Yuwen2024/Fall-2025-Ember-Bot/Documentation/ECEN403 Final Presentation.pdf

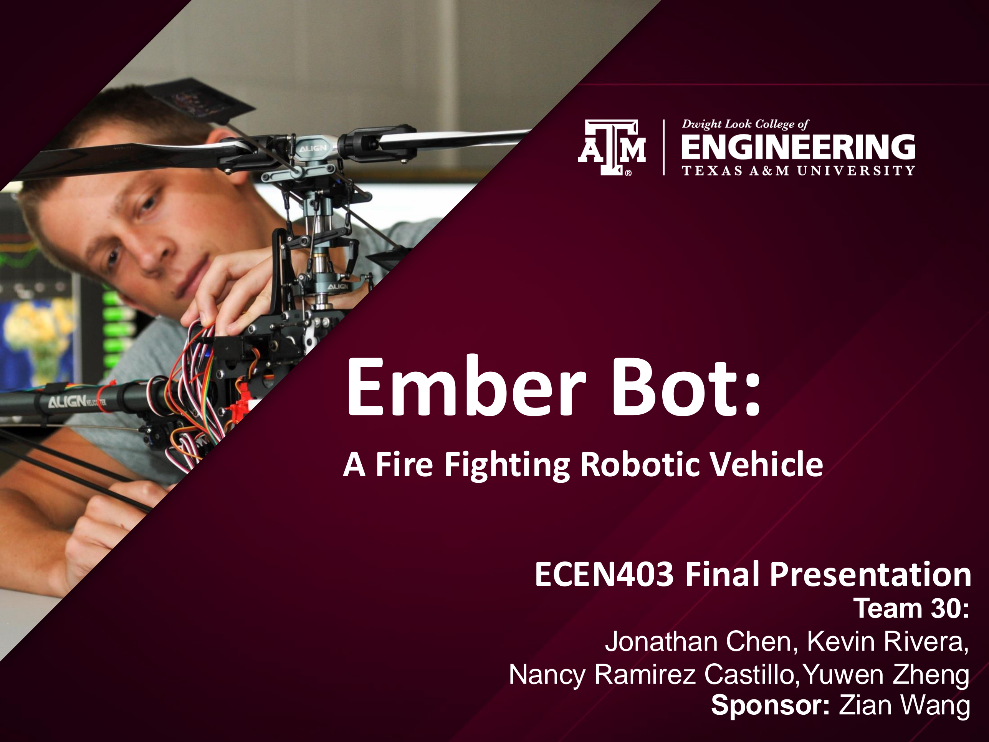
[picture p62: page 1]

# Ember Bot:

# A Fire Fighting Robotic Vehicle

## Sponsor: Zian Wang

## Team 30:

Jonathan Chen, Kevin Rivera,

## Nancy Ramirez Castillo,Yuwen Zheng

# ECEN403 Final Presentation

# Problem Statement:

### Traditional firefighting methods rely on human intervention, exposing personnel to extreme hazards such as heat, toxic smoke, and structural collapse. These settings can pose safety risks and potential response delays, especially in hard-to-

reach areas.

# Project Overview

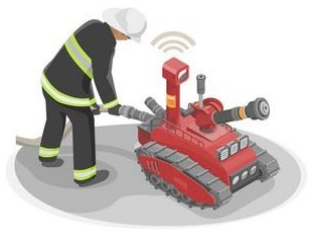
[picture p63: figure]
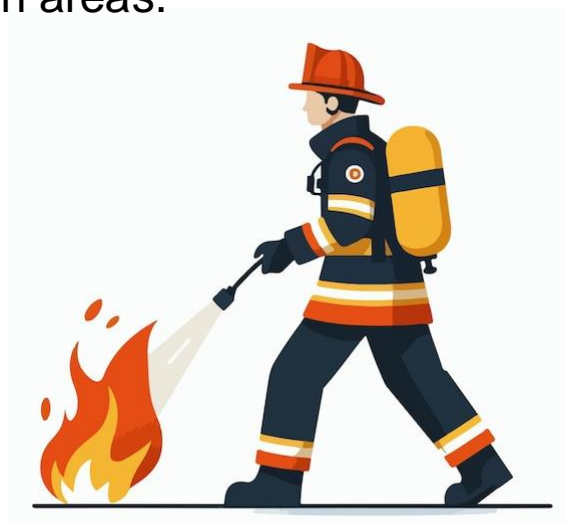
[picture p64: figure]

# Solution proposal:

### Ember Bot is a fire-fighting robotic vehicle designed to detect and extinguish small fires in

high-risk areas through a mobile app. Equipped with IR sensors and a camera,

### firefighters will be able to control Ember Bot

in areas deemed unsafe for humans.

# System Overview

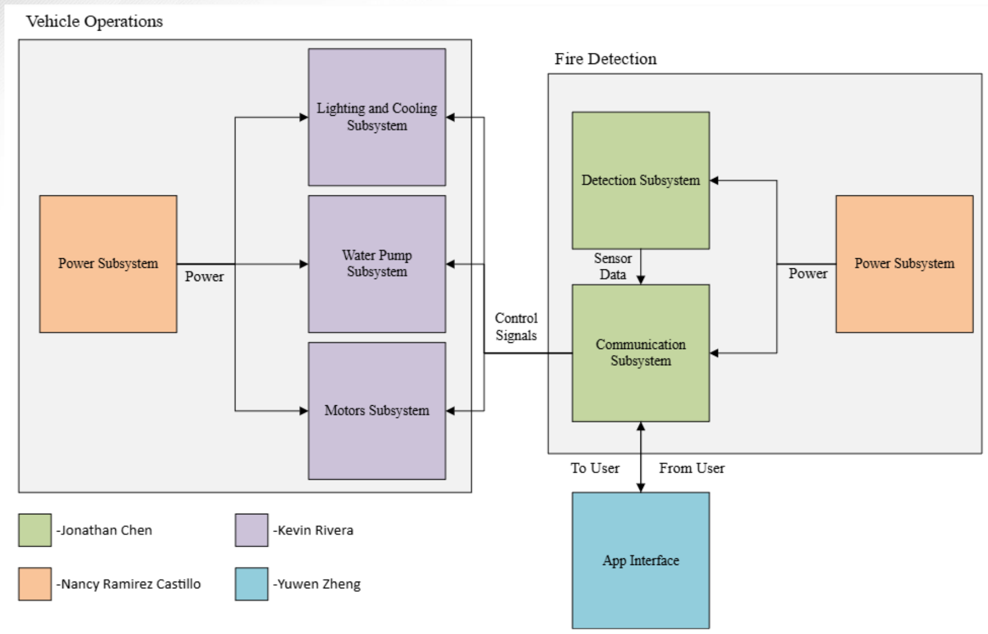
[picture p65: figure]

# Microcontroller Subsystem

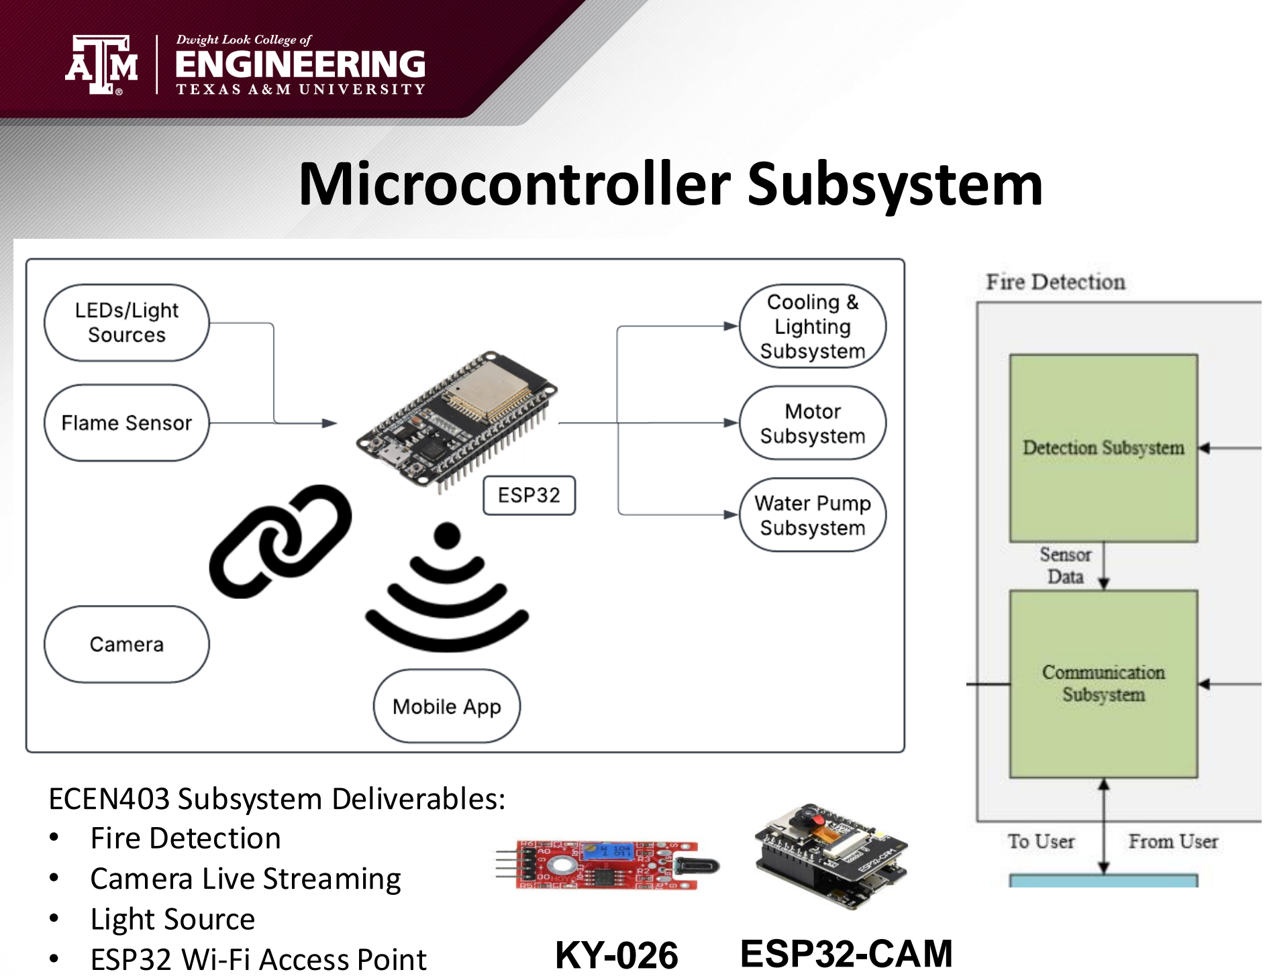
[picture p66: page 4]

## KY-026 ESP32-CAM

## ECEN403 Subsystem Deliverables: - Fire Detection - Camera Live Streaming - Light Source - ESP32 Wi-Fi Access Point

# Microcontroller Subsystem

## Jonathan Chen

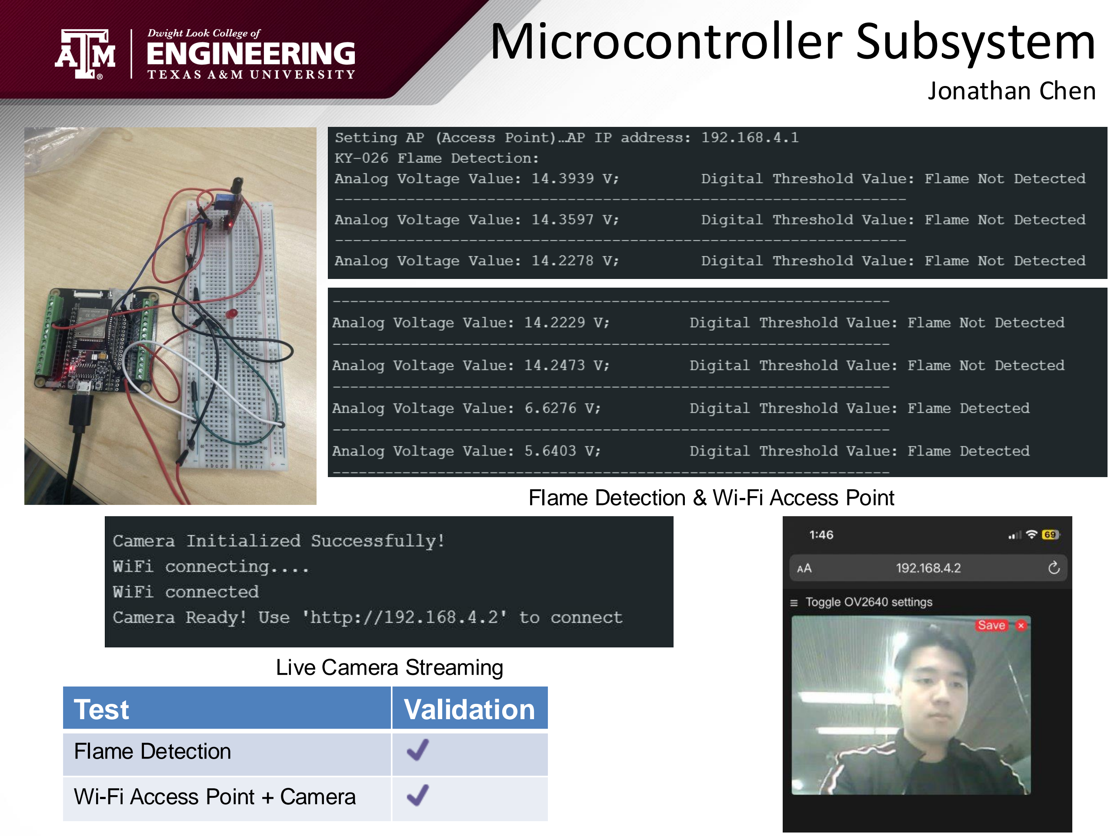
[picture p67: page 5]

Flame Detection & Wi-Fi Access Point

Live Camera Streaming
Test | Validation

Flame Detection

Wi-Fi Access Point + Camera

# Vehicle Operations

## Kevin Rivera

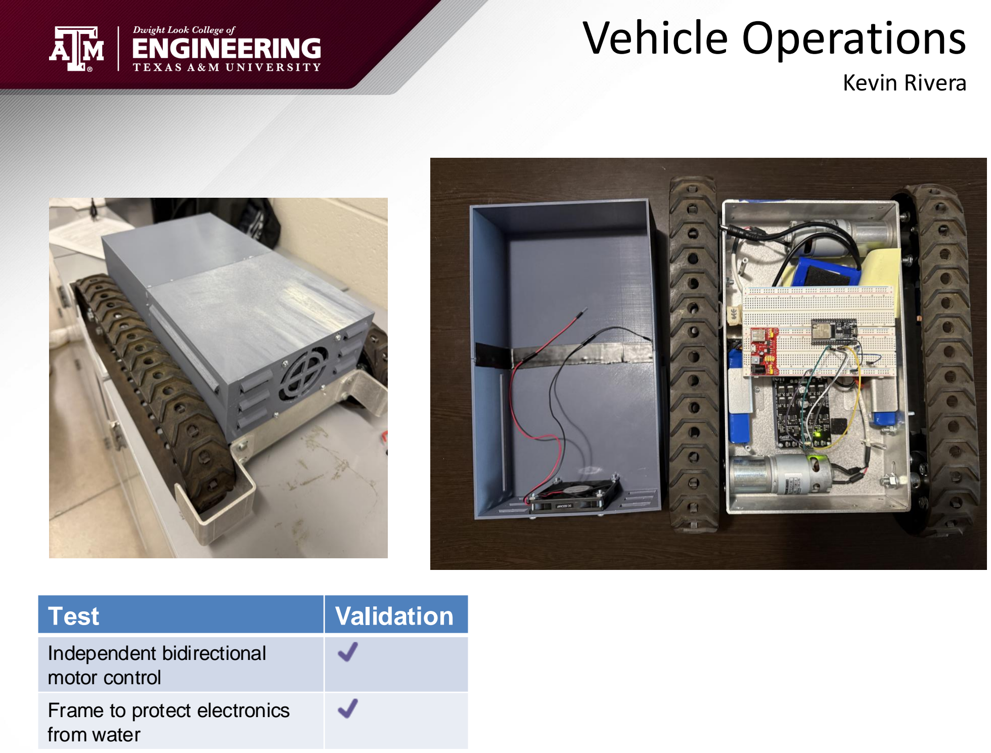
[picture p68: page 6]

Test | Validation

Independent bidirectional motor control

Frame to protect electronics from water

# Vehicle Operations

## Kevin Rivera

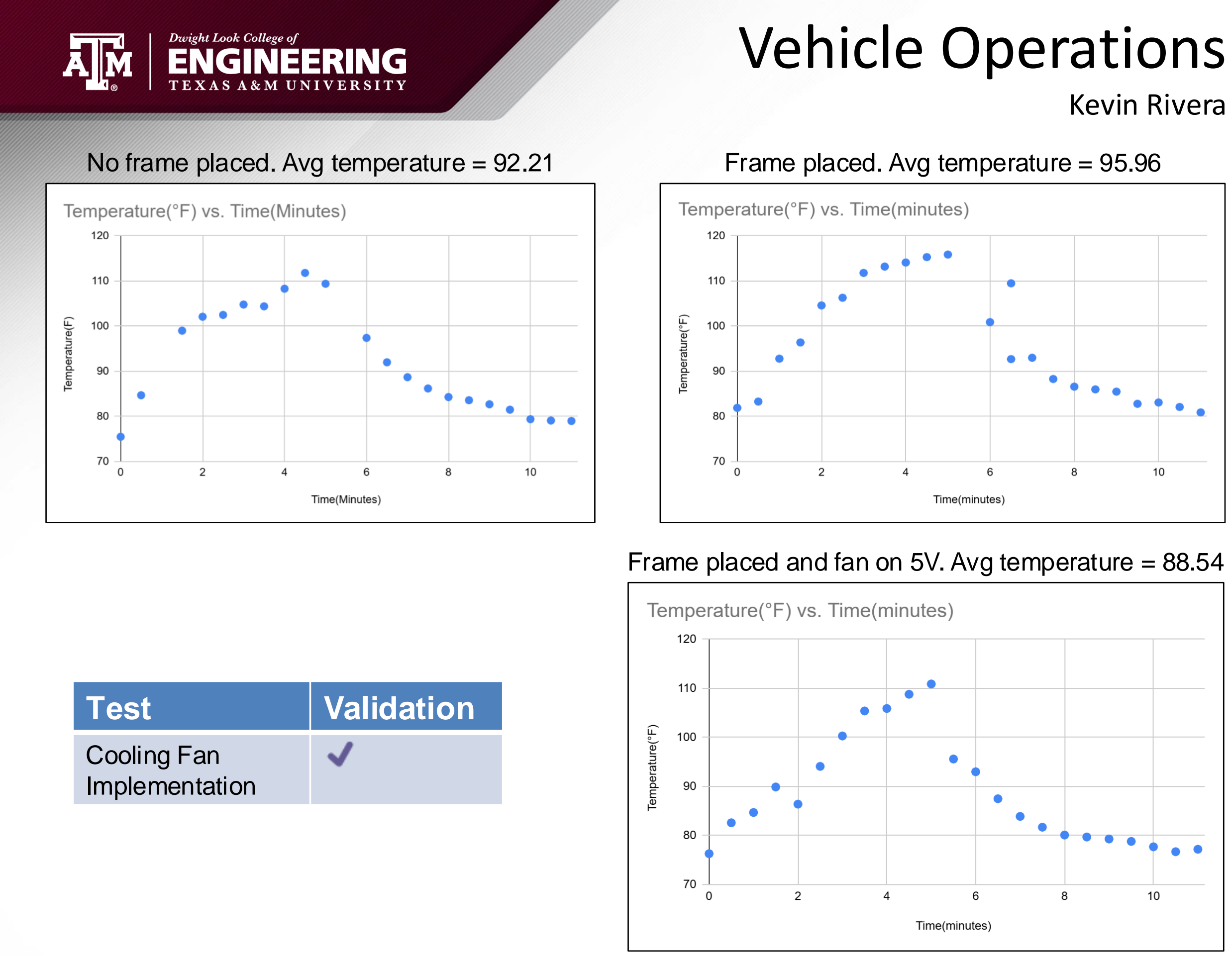
[picture p69: page 7]

No frame placed. Avg temperature = 92.21 | Frame placed. Avg temperature = 95.96

Frame placed and fan on 5V. Avg temperature = 88.54

Test | Validation

Cooling Fan Implementation

# Water Pump System

## Kevin Rivera

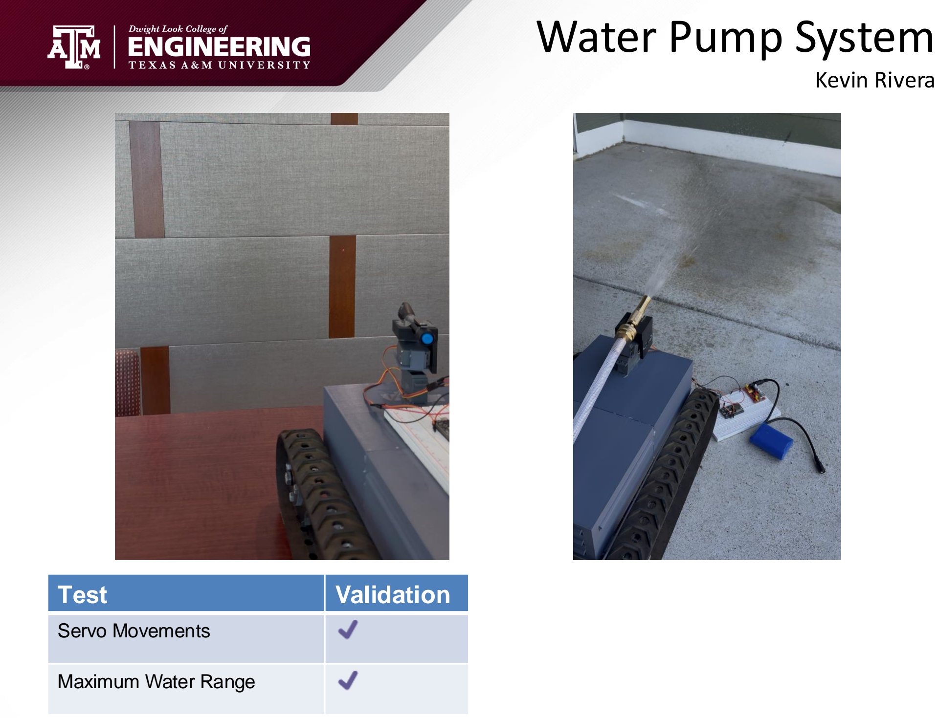
[picture p70: page 8]

Test | Validation

Servo Movements

Maximum Water Range

# Power Subsystem

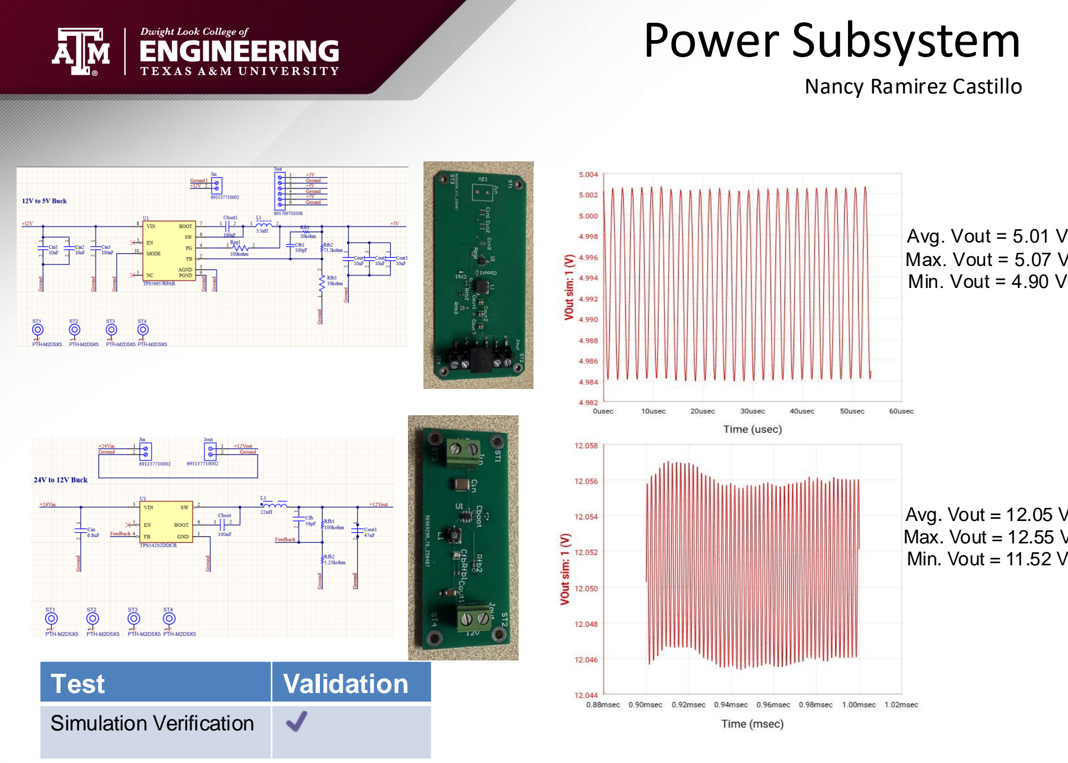
[picture p71: page 9]

### Nancy Ramirez Castillo

Test | Validation

Simulation Verification

Avg. Vout = 5.01 V
Max. Vout = 5.07 V
Min. Vout = 4.90 V

Avg. Vout = 12.05 V
Max. Vout = 12.55 V
Min. Vout = 11.52 V

# Power Subsystem

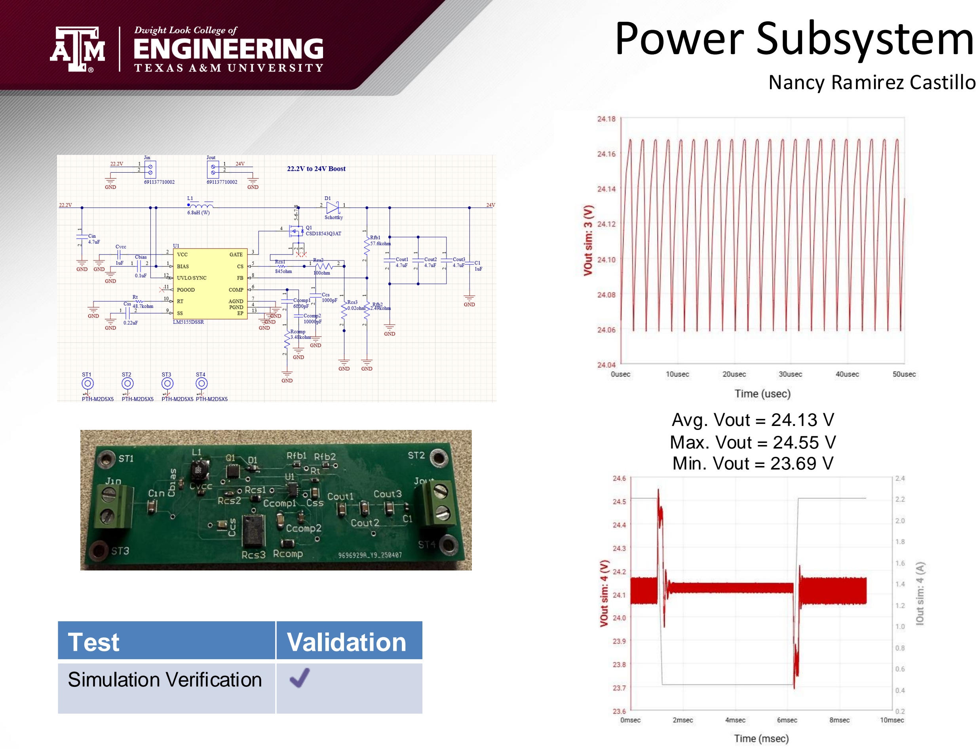
[picture p72: page 10]

### Nancy Ramirez Castillo

Test | Validation

Simulation Verification

Avg. Vout = 24.13 V
Max. Vout = 24.55 V
Min. Vout = 23.69 V

# App Design

# - Designed and built a mobile app as controller for Ember Bot - Can be used on iOS & Android - Communicate with Ember Bot via Wi-Fi - Including live video streaming functionality - User experience considered

# App Interface

## Yuwen Zheng

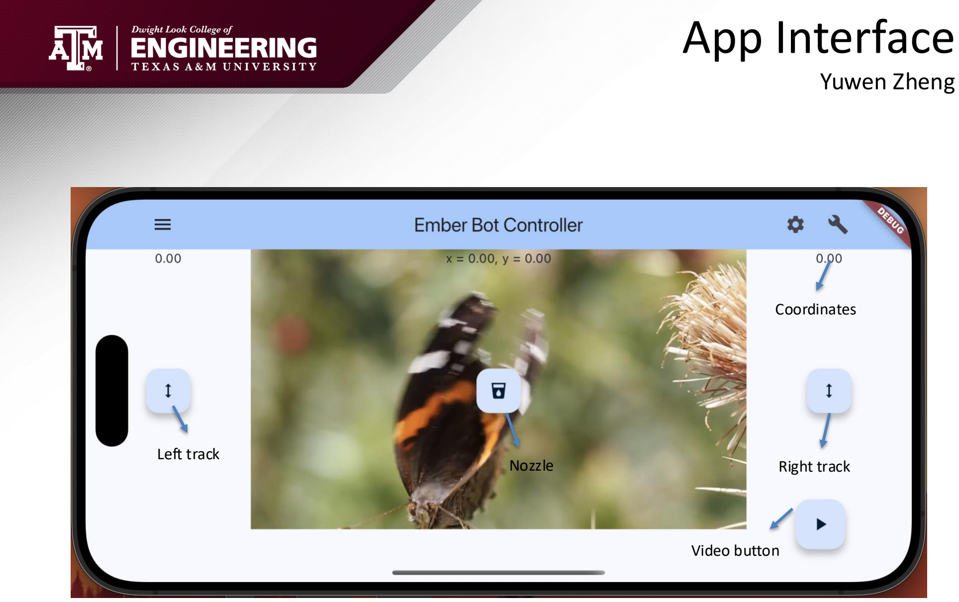
[picture p73: page 12]

Left track
Nozzle | Right track

Coordinates

Video button

# Execution Plan

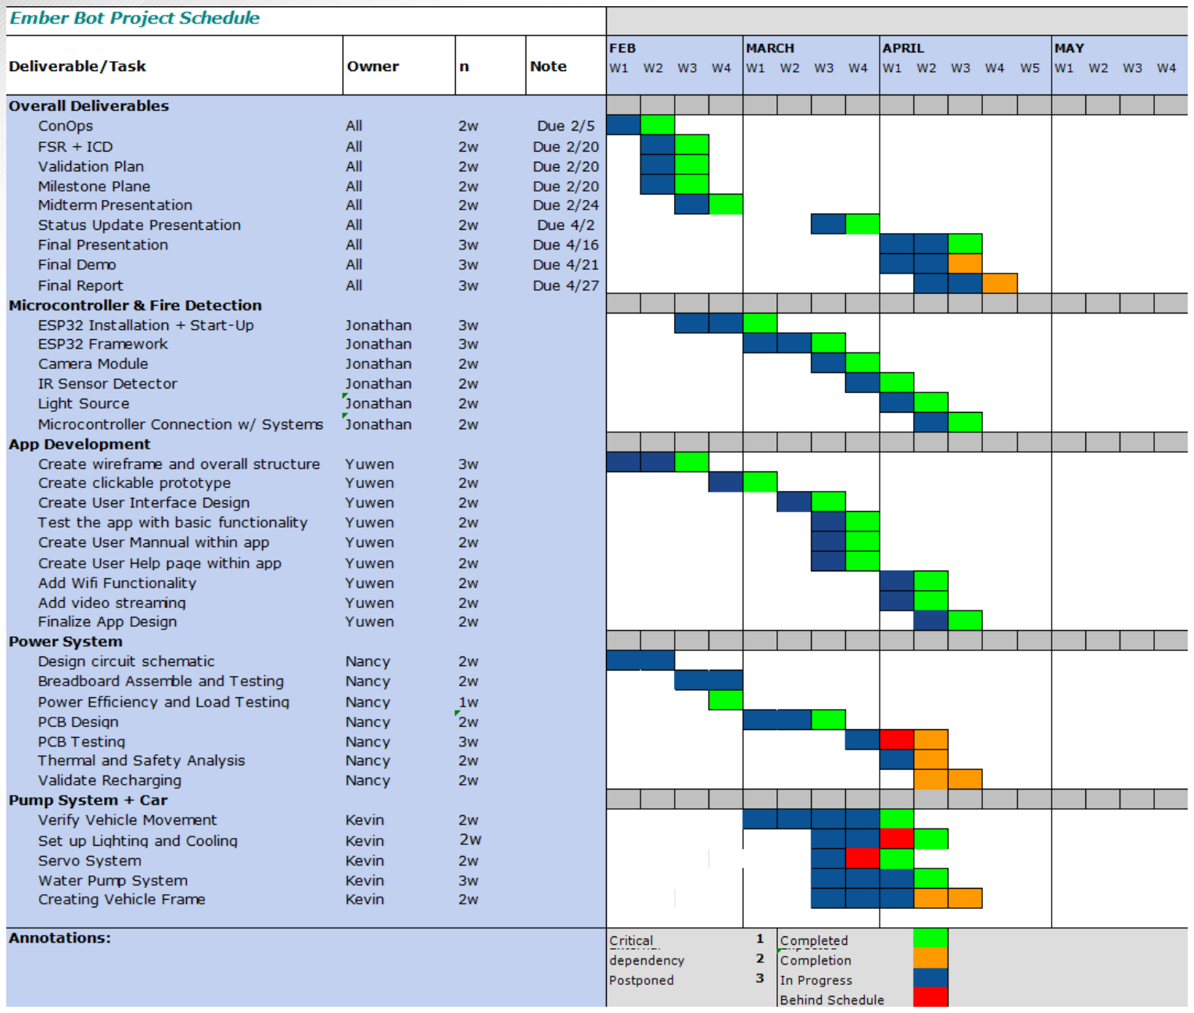
[picture p74: figure]

# Validation Plan

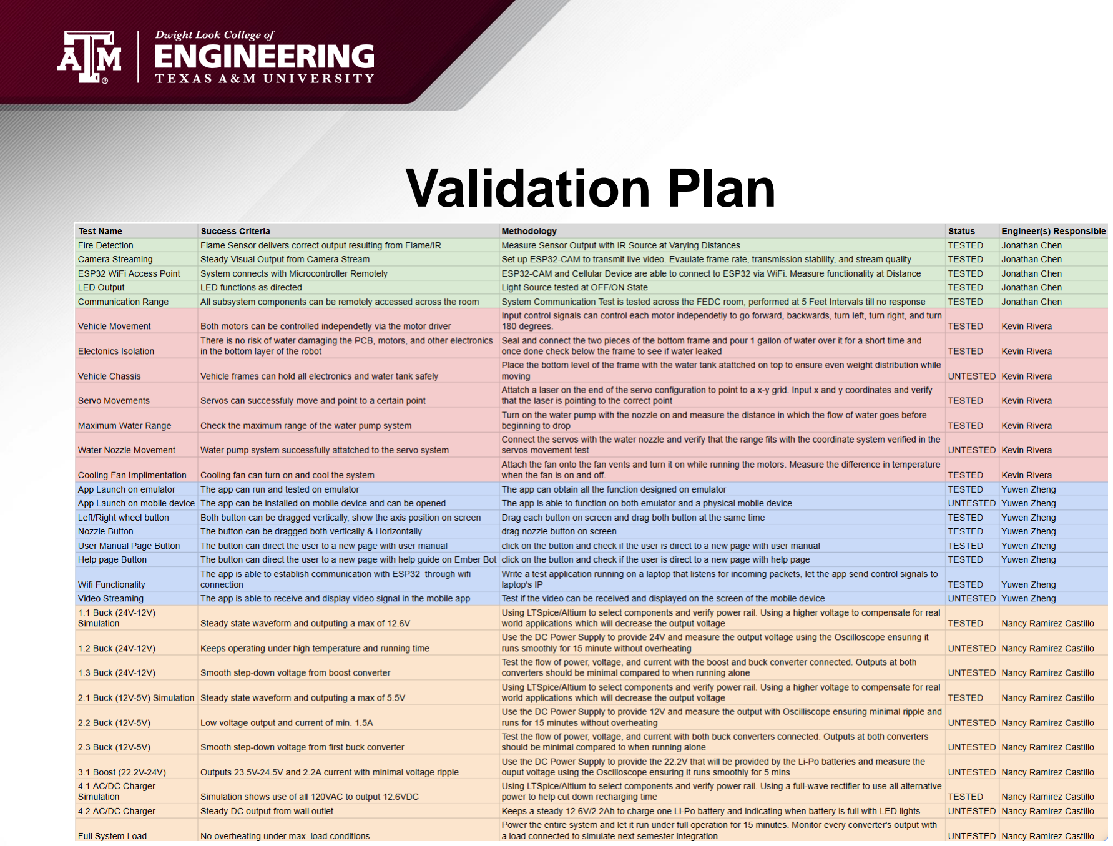
[picture p75: page 14]

# Remaining Tasks & 404 Goals

Subsystem | Remaining Tasks | 404 Goals
Microcontroller Subsystem | • Prepare for Demo with Independent Power | • Subsystem Integration with Communication • Integrate Data Readings into Mobile App • Help Design PCB for Microcontroller
Vehicle Operations & Water Pump System | • Attach frame onto the body • Design water tank • Translate co-ordinates to servo positions | • Placing PCBs and sensors inside the robot • Attach water pump system to the frame
Power Subsystem | • Test soldered PCB designs • Complete thermal testing with max load conditions | • Minimize wiring, new PCB design for microcontroller paths
Mobile App | • Test video stream from camera • Finalize app design | • Integrate app buttons with other subsystems • Optimize user experience
