Yuwen2024/Fall-2025-Ember-Bot/Documentation/ECEN403 Midterm Presentation.pdf

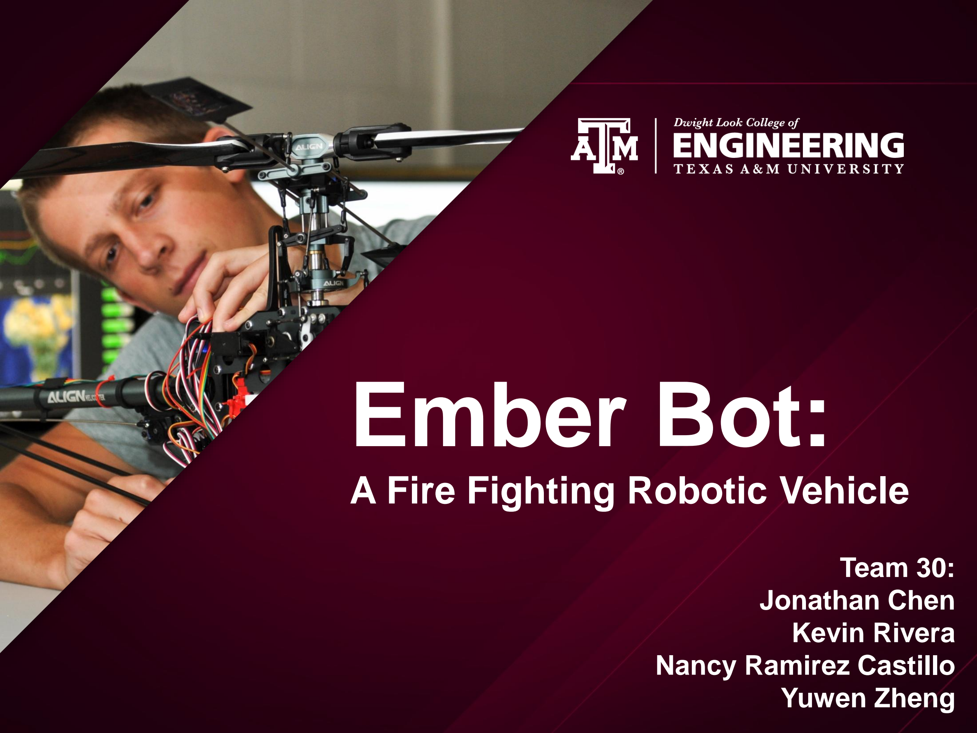
[picture p76: page 1]

# Team 30: Jonathan Chen Kevin Rivera Nancy Ramirez Castillo Yuwen Zheng

# Ember Bot:

# A Fire Fighting Robotic Vehicle

# Executive Summary:

# Problem Statement:

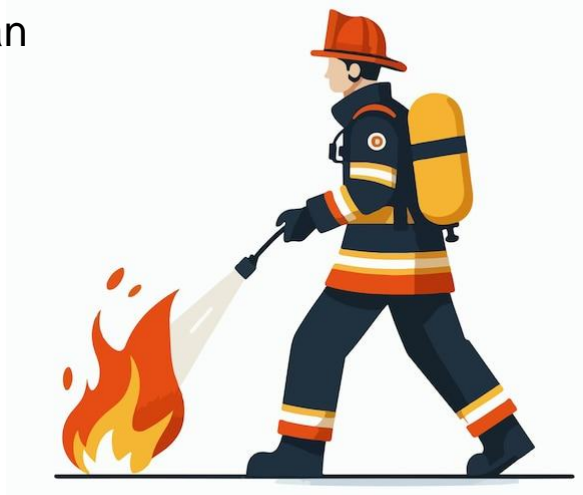
[picture p77: figure]

# Traditional firefighting methods rely on human intervention, exposing personnel to extreme hazards such as heat, toxic smoke, and structural collapse. These settings can pose

safety risks and potential response delays, especially in hard-to-reach areas.

# Project Description

# Solution proposal:

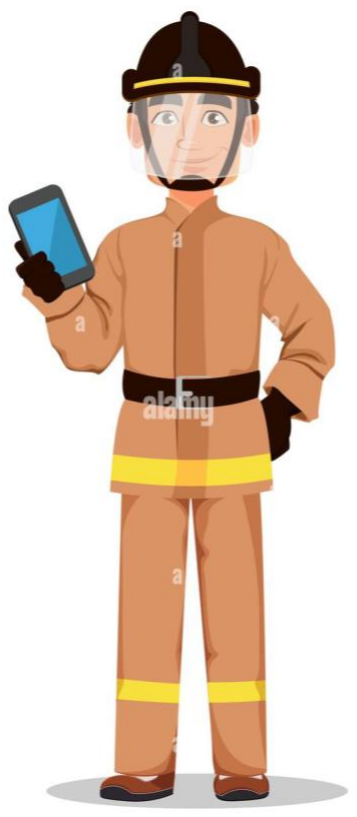
[picture p78: figure]

# Ember Bot is a fire-fighting robotic vehicle designed to detect and extinguish small fires in high-risk areas through

a mobile app. Equipped with IR sensors and a camera,

# firefighters will be able to control Ember Bot in areas

deemed unsafe for humans.

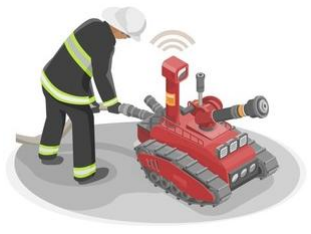
[picture p79: figure]

# System Overview

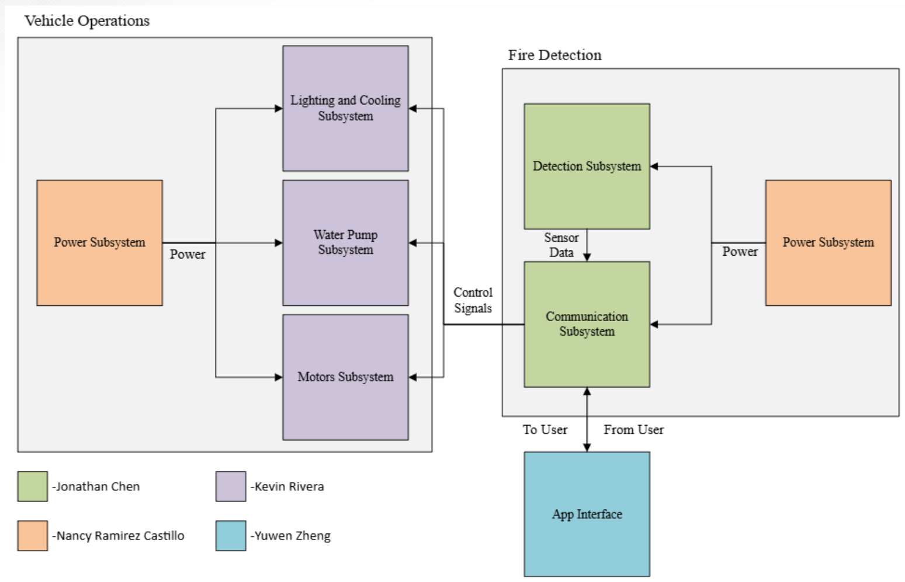
[picture p80: figure]

# Microcontroller and Fire Detection

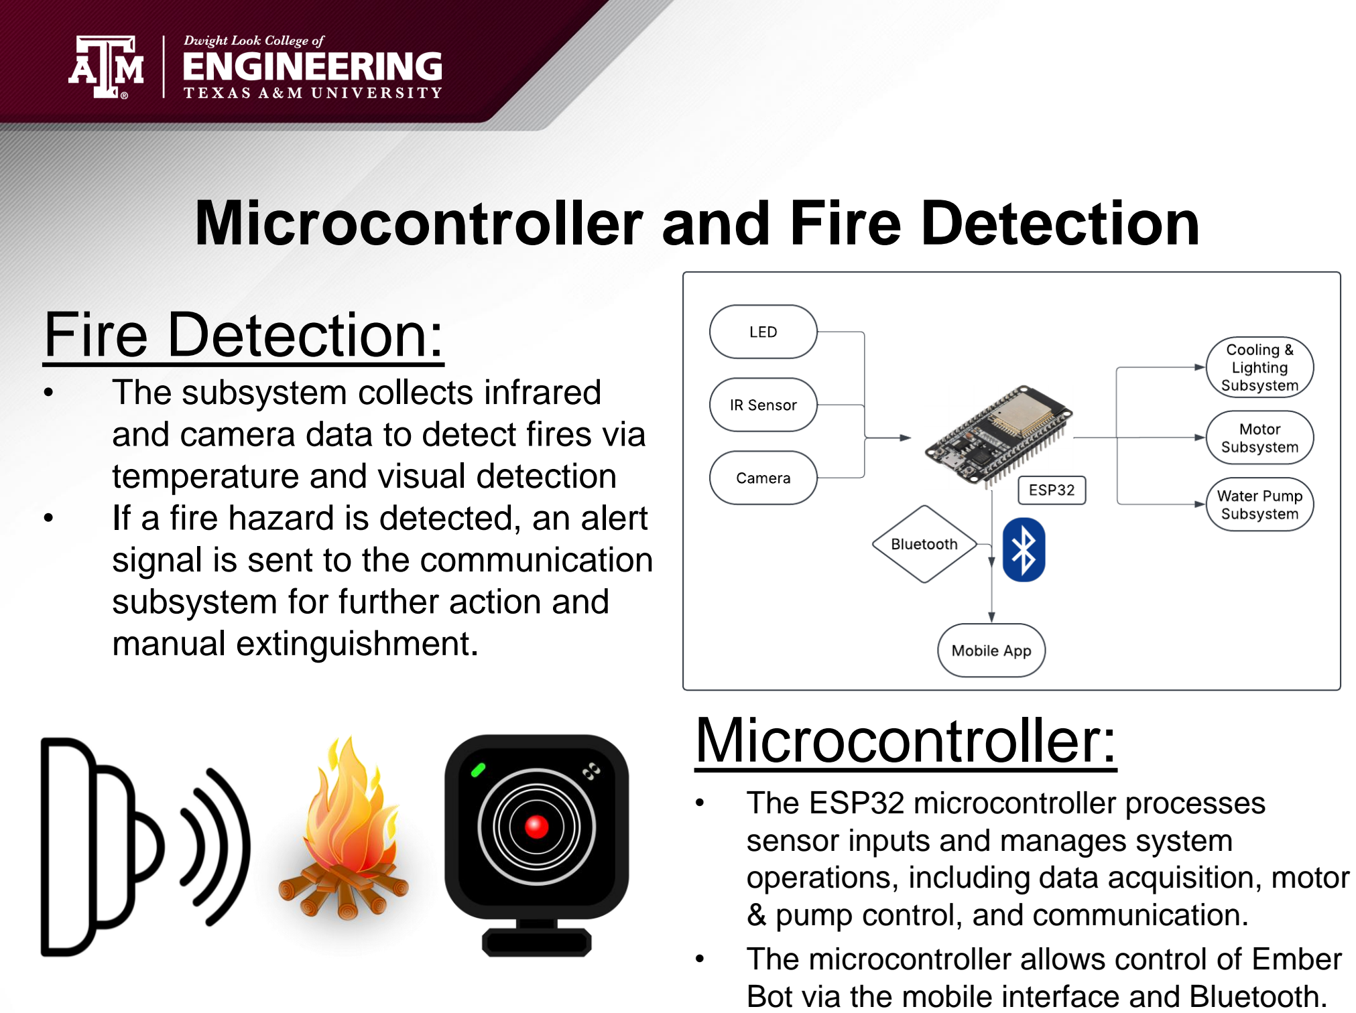
[picture p81: page 5]

# Microcontroller:

## - The ESP32 microcontroller processes sensor inputs and manages system operations, including data acquisition, motor

& pump control, and communication.

## - The microcontroller allows control of Ember

Bot via the mobile interface and Bluetooth.

# Fire Detection:

## - The subsystem collects infrared and camera data to detect fires via temperature and visual detection - If a fire hazard is detected, an alert signal is sent to the communication subsystem for further action and

manual extinguishment.

# Car Design

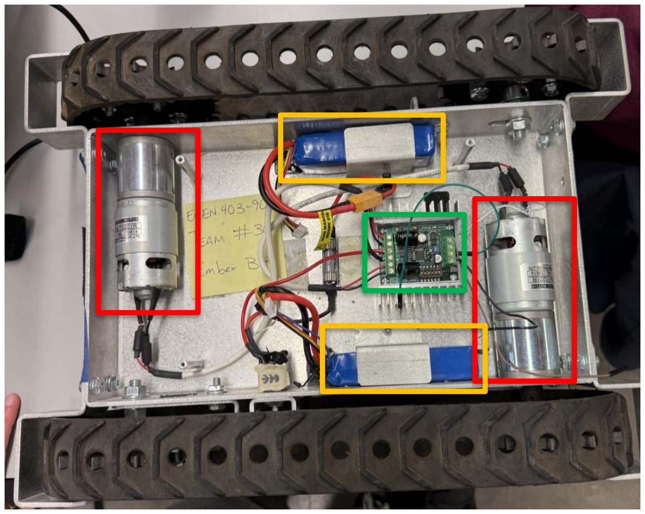
[picture p82: figure]

# - 2 24V DC Motor - Dual Channel Motor Control - 2 11.1V Battery - To be added:

## – LED Strip – Cooling Fan – Temperature Sensor – ½ Gallon Refillable Water Tank

# Pump System

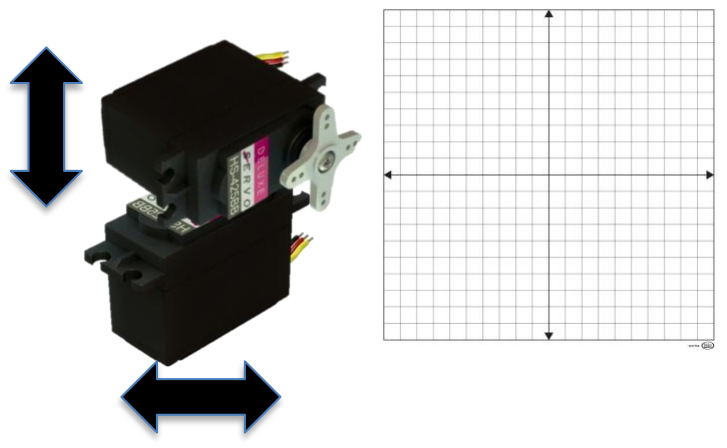
[picture p83: figure]
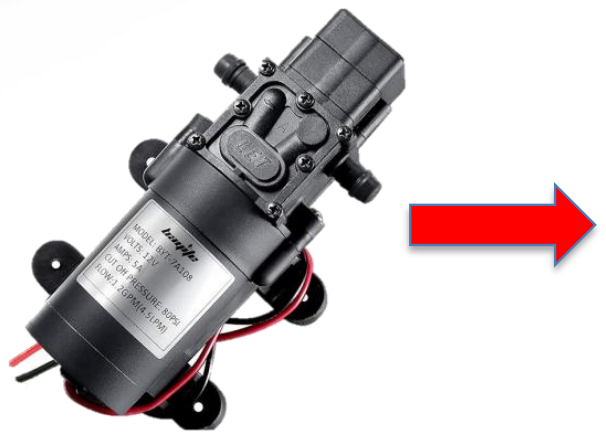
[picture p84: figure]
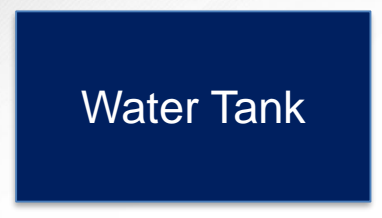
[picture p85: figure]
Water Tank

# - Water transfer pump pressurizes the water to shoot it out - Two stacked servos to move the water nozzle

# – One servo moves in the x direction, the other in the y

# Power System

# - Power Source & Distribution:

# - 2 – 11.1V/2200mAh Batteries - Regulators:

# - Buck Converter (11.1V to 3.3V) - Boost Converter (22.2V to 24V) - Buck Converter (22.2V to 12V)

# Power System

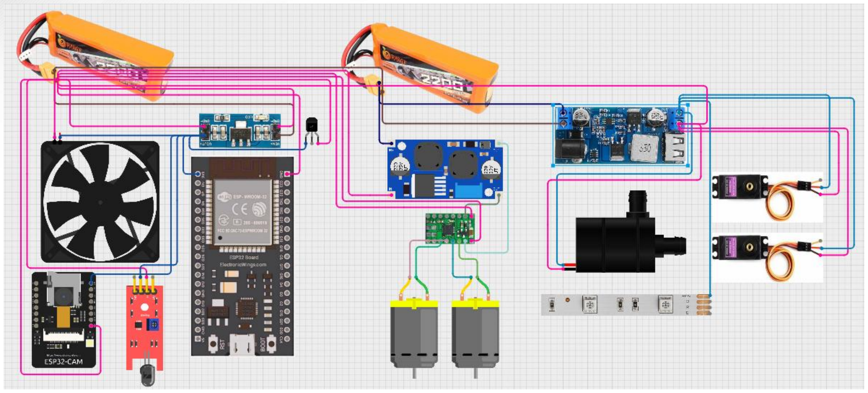
[picture p86: figure]

# Mobile App Design

# - Build with Flutter, a cross-platform framework - Support iOS / Android - Code written in Dart - Communicate with Ember Bot via Bluetooth

# UI Demonstration

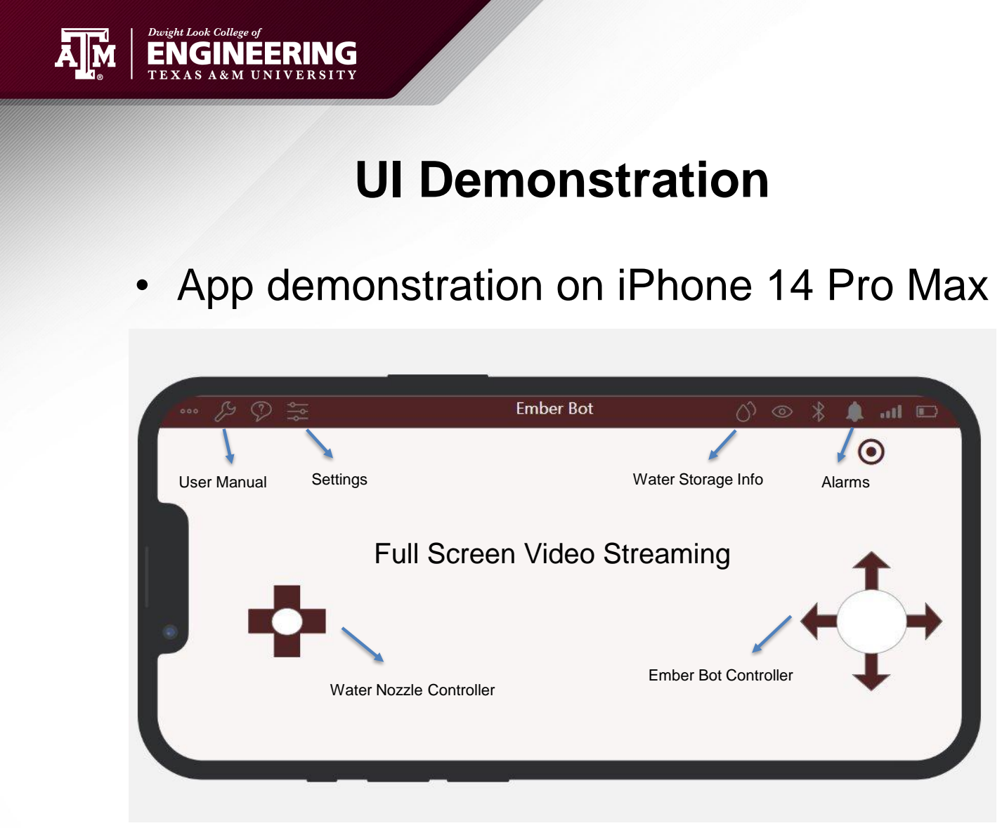
[picture p87: page 11]

# - App demonstration on iPhone 14 Pro Max

## Full Screen Video Streaming

User Manual | Settings | Water Storage Info

Ember Bot Controller
Water Nozzle Controller

Alarms

# Features - User Manual - Settings & Help Page - Warnings & Alarms

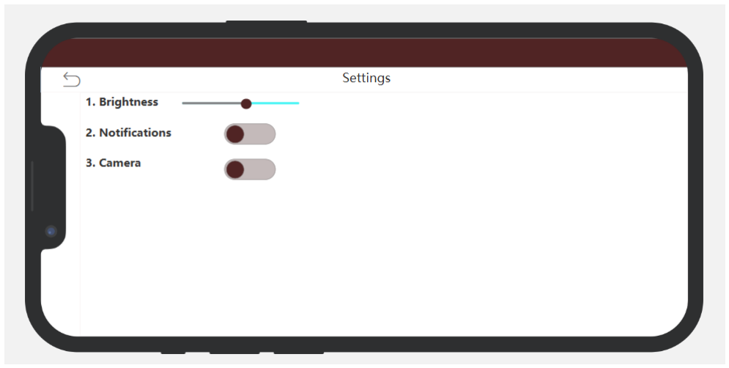
[picture p88: figure]

# Future Possibilities

# Some Possible Future Additions:

# 1. Tap to Extinguish 2. Automatic Land Traversal 3. Extended Communication Range 4. Even More Possibilities!

# Execution Plan

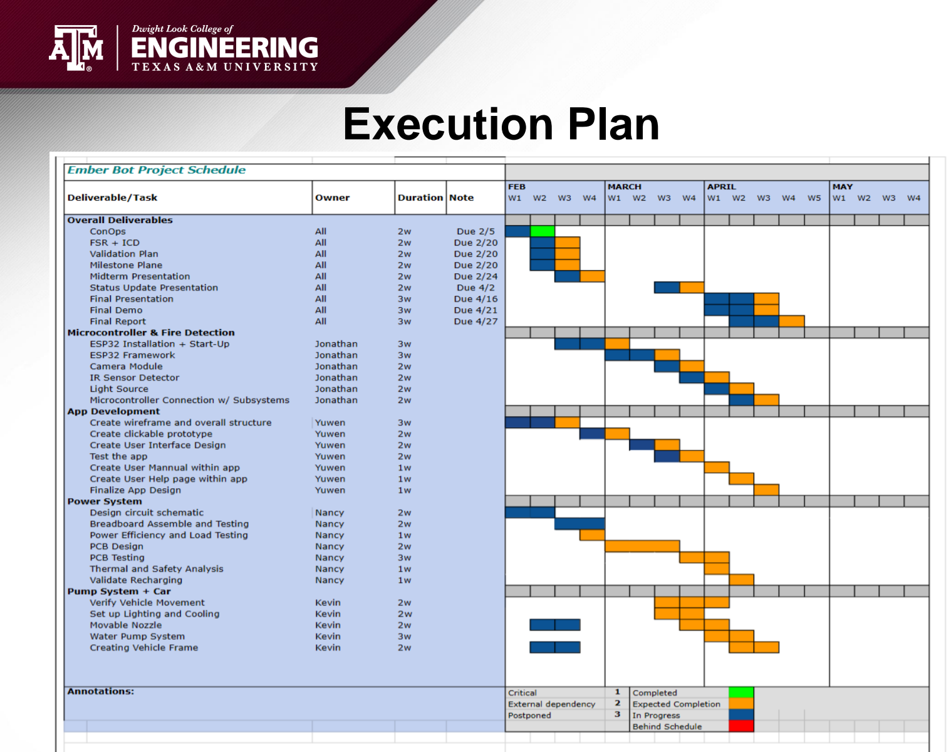
[picture p89: page 14]

# Validation Plan

Status Indicators

Completed

In Progress

Behind Schedule

Task | Deadline | Current Status | Color Code
Understand & Research | 1/30/2025 | Completed
ConOPS Completed | 2/5/2025 | Completed
Components Ordered | 2/18/2025 | Completed
FSR, ICD, Milestones, and Validation Plan Completed | 2/20/2025 | Completed
Midterm Presentation | 2/24/2025 | In Progress
Parts Received | TBD | In Progress
Breadboard Testing | 2/28/2025 | In Progress
Vehicle Movement | 3/18/2025 | In Progress
PCB Designed + Ordered | 3/19/2025 | In Progress
ESP32 Framework Completed | 3/25/2025 | In Progress

# Validation Plan

Task | Deadline | Current Status | Color Code
Pump System Completion | 3/25/2025 | In Progress
Primary App Design Completed | 4/1/2025 | In Progress
PCB Testing Complete | 4/2/2025 | In Progress
Microcontroller System Set-up | 4/8/2025 | In Progress
Power System Tested w/ Car | 4/8/2025 | In Progress
Final Presentation | 4/16/2025 | In Progress
Final Demo | 4/21/2025 | In Progress
Final Report | 4/27/2025 | In Progress
