Yuwen2024/Fall-2025-Ember-Bot/Documentation/ECEN403 Status Update.pdf

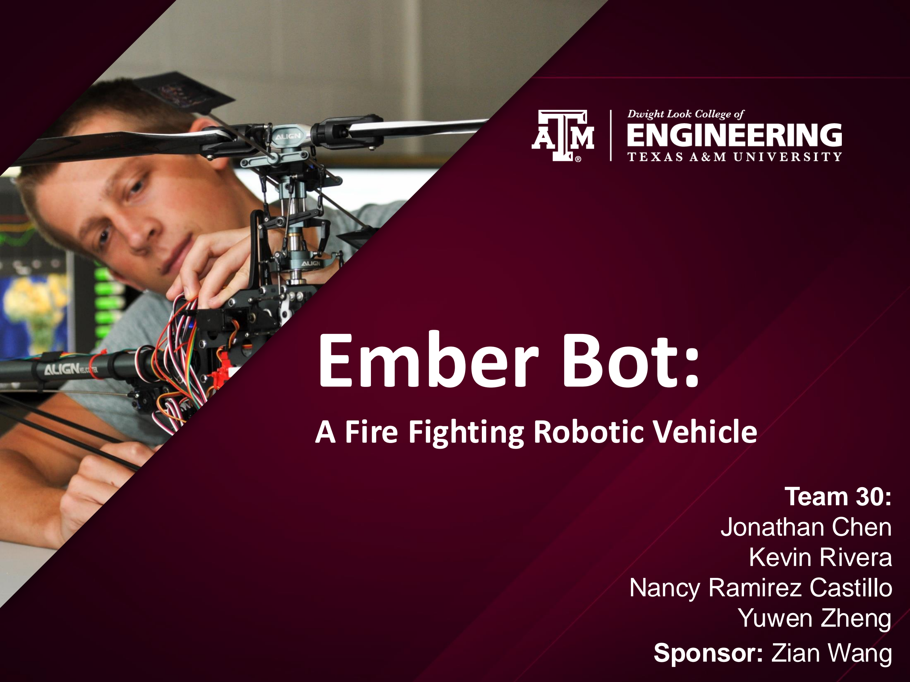
[picture p90: page 1]

# Ember Bot:

## A Fire Fighting Robotic Vehicle

Sponsor: Zian Wang

Team 30:
Jonathan Chen
Kevin Rivera
Nancy Ramirez Castillo
Yuwen Zheng

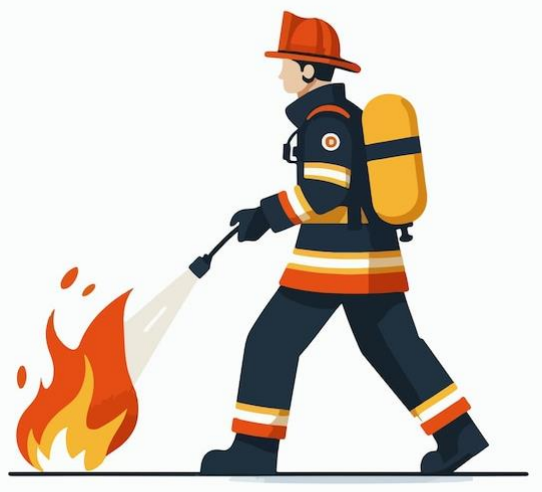
[picture p91: figure]

# Problem Statement:

Traditional firefighting methods rely on human intervention, exposing personnel to extreme hazards such as heat, toxic smoke, and structural collapse. These settings can pose safety risks and potential response delays, especially in hard-toreach areas.

# Project Overview

# Project Overview

# Solution proposal:

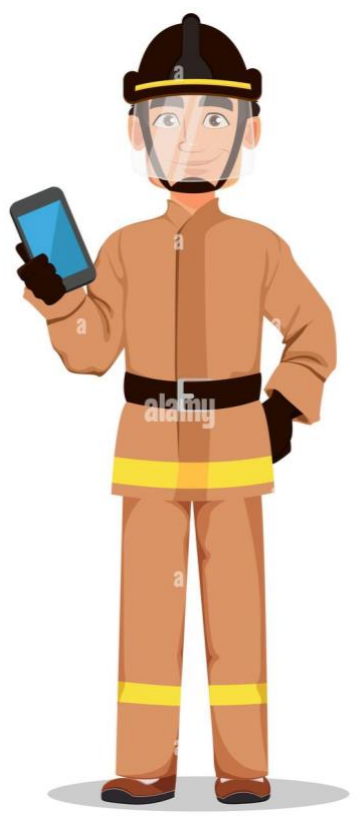
[picture p92: figure]

Ember Bot is a fire-fighting robotic vehicle designed to detect and extinguish small fires in high-risk areas through a mobile app. Equipped with IR sensors and a camera, firefighters will be able to control Ember Bot in areas deemed unsafe for humans.

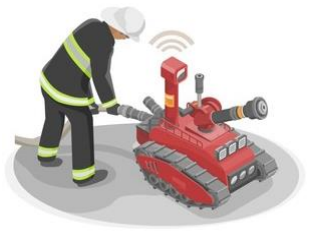
[picture p93: figure]

# System Overview

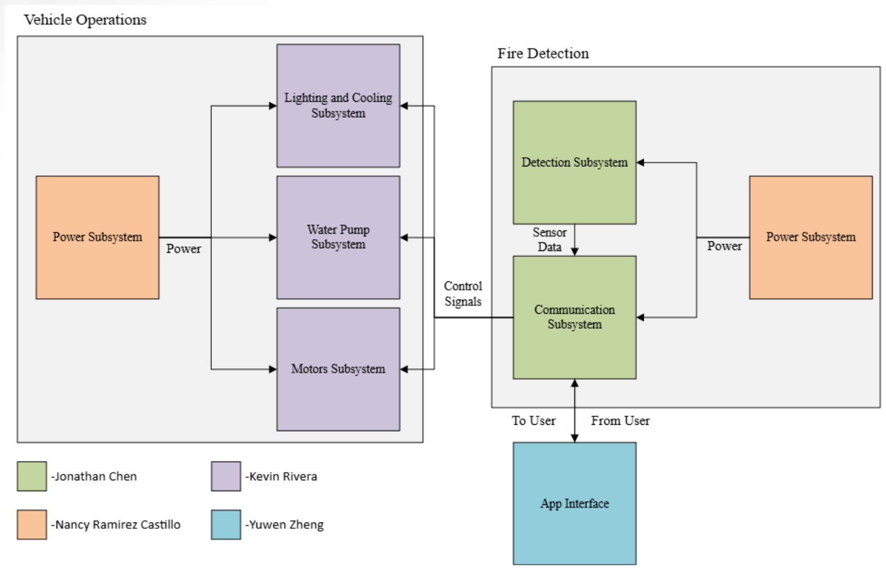
[picture p94: figure]

# Microcontroller Subsystem

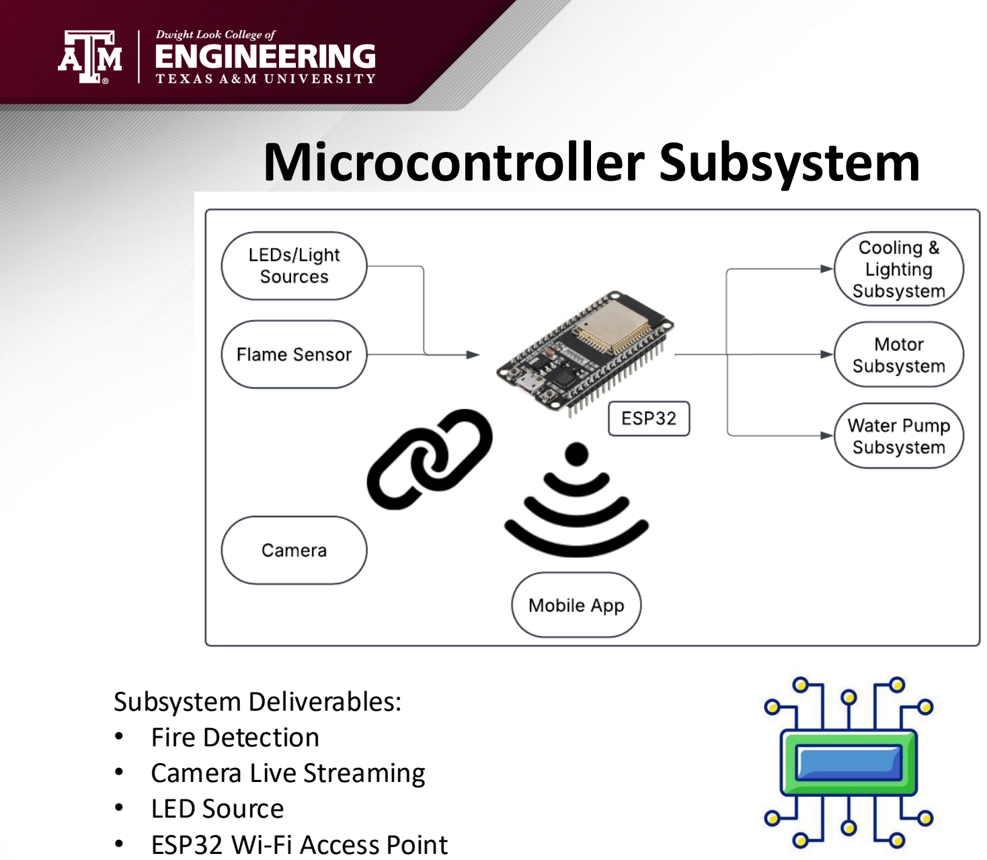
[picture p95: page 5]

Subsystem Deliverables:
- Fire Detection
- Camera Live Streaming
- LED Source
- ESP32 Wi-Fi Access Point

# Microcontroller Subsystem

Jonathan Chen

Accomplishments since the last presentation

Ongoing progress/problems and plans until the next presentation

- Fire Detection Completed (KY-026)
- Camera Live Streaming (ESP32-CAM)
- Code Base & IDE-Set Up (ESP-IDF & Arduino IDE)

Ongoing Progress:
- Wi-Fi Access Point
- Lighting System
- Demo/System Integration

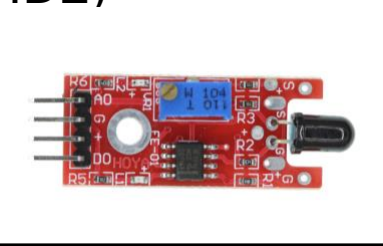
[picture p96: figure]
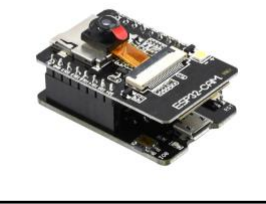
[picture p97: figure]

Problems:
- Fire Detection Range
- Unstable Camera Feed

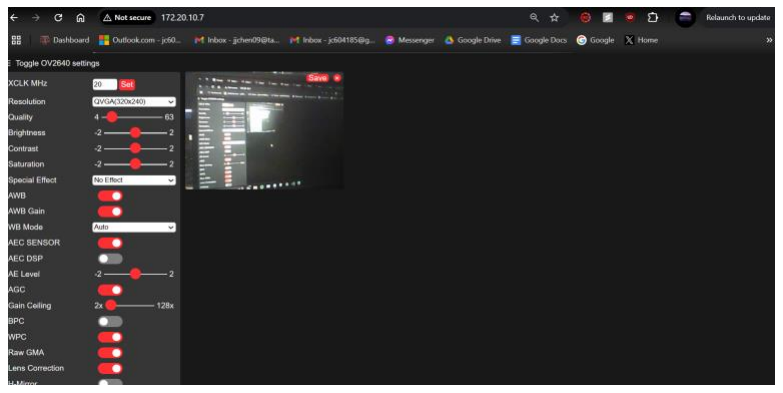
[picture p98: figure]
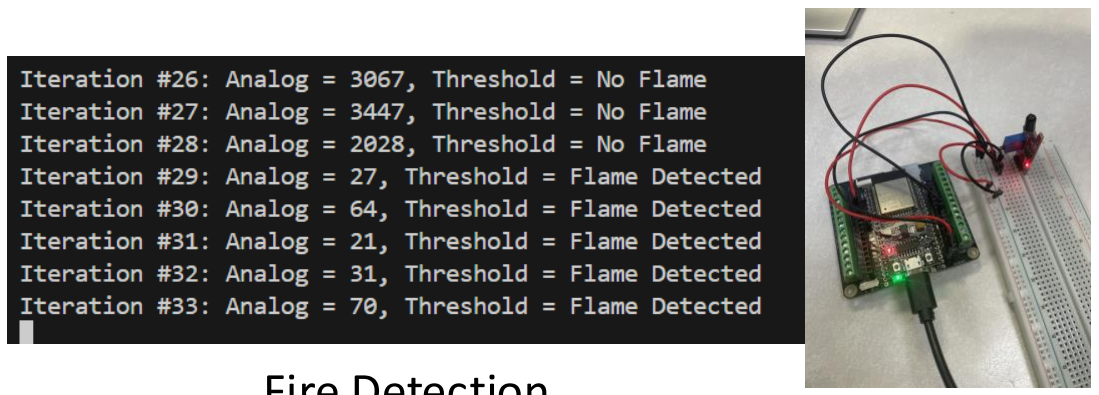
[picture p99: figure]

Fire Detection | Camera Streaming

# Vehicle Operations

Kevin Rivera

Accomplishments since the last presentation | Ongoing progress/problems and plans until the next presentation
- First version of frame printed | • Design is too big to be printed as a single piece • Designing second layer containing water tank • Old motor driver did not work, new one coming in this week

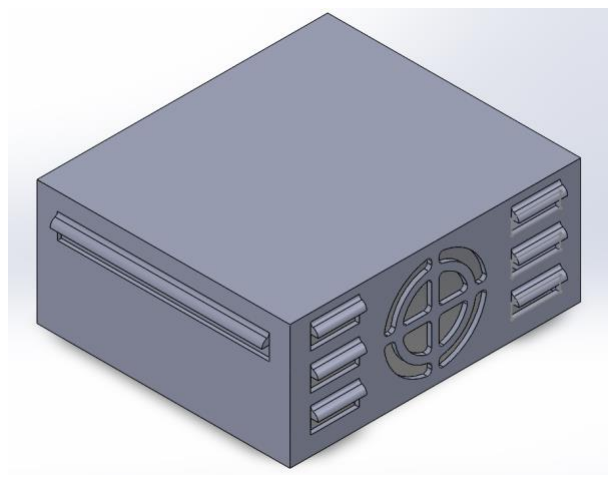
[picture p100: figure]
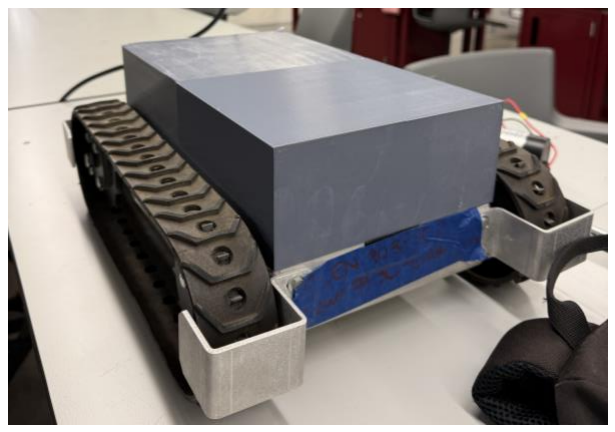
[picture p101: figure]
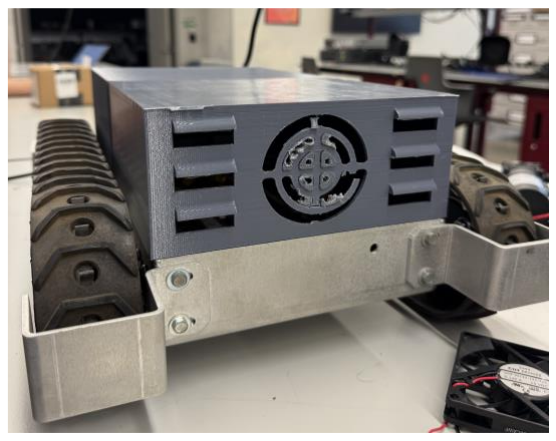
[picture p102: figure]

# Water Pump System

Kevin Rivera

Accomplishments since the last presentation | Ongoing progress/problems and plans until the next presentation
- Verified water pump max range of 7-8ft • Began testing nozzle movement system | • Water pump is a little loud • Design a holder for the water nozzle

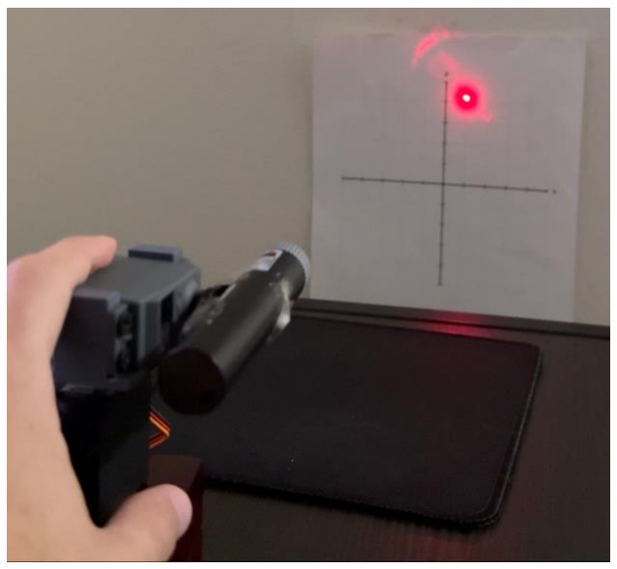
[picture p103: figure]
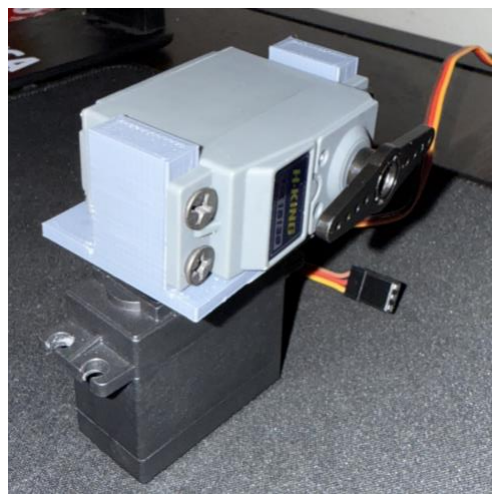
[picture p104: figure]

# Power Subsystem

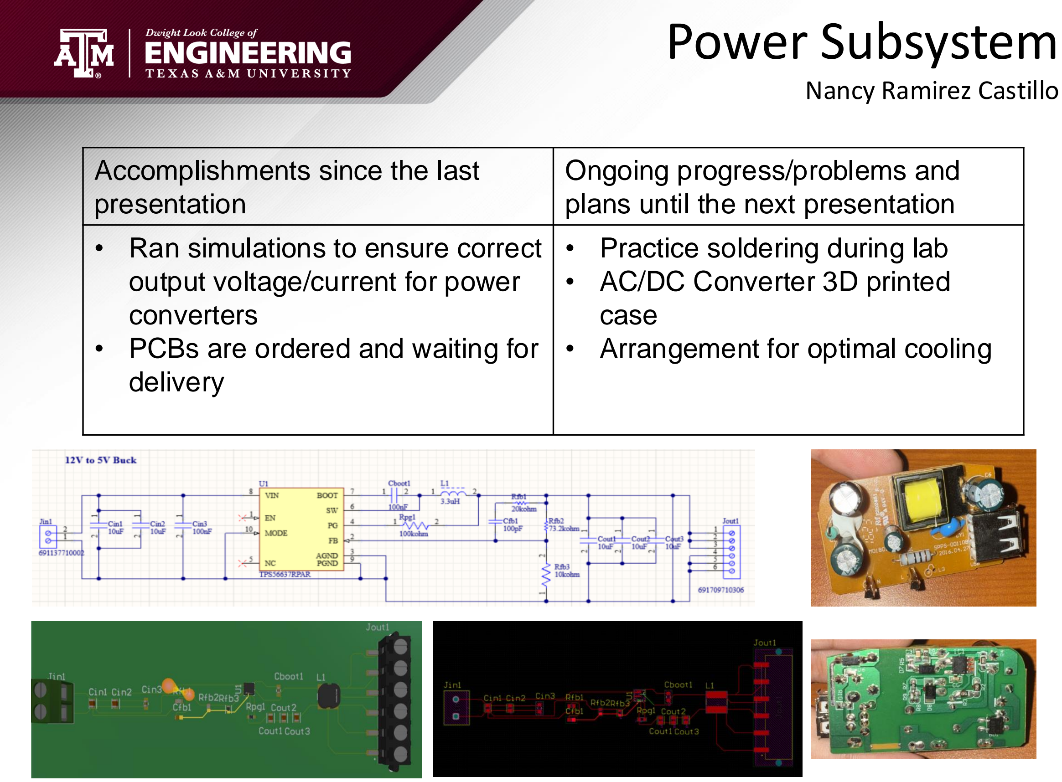
[picture p105: page 9]

Nancy Ramirez Castillo

Accomplishments since the last presentation | Ongoing progress/problems and plans until the next presentation
- Ran simulations to ensure correct output voltage/current for power converters • PCBs are ordered and waiting for delivery | • Practice soldering during lab • AC/DC Converter 3D printed case • Arrangement for optimal cooling

# App Interface

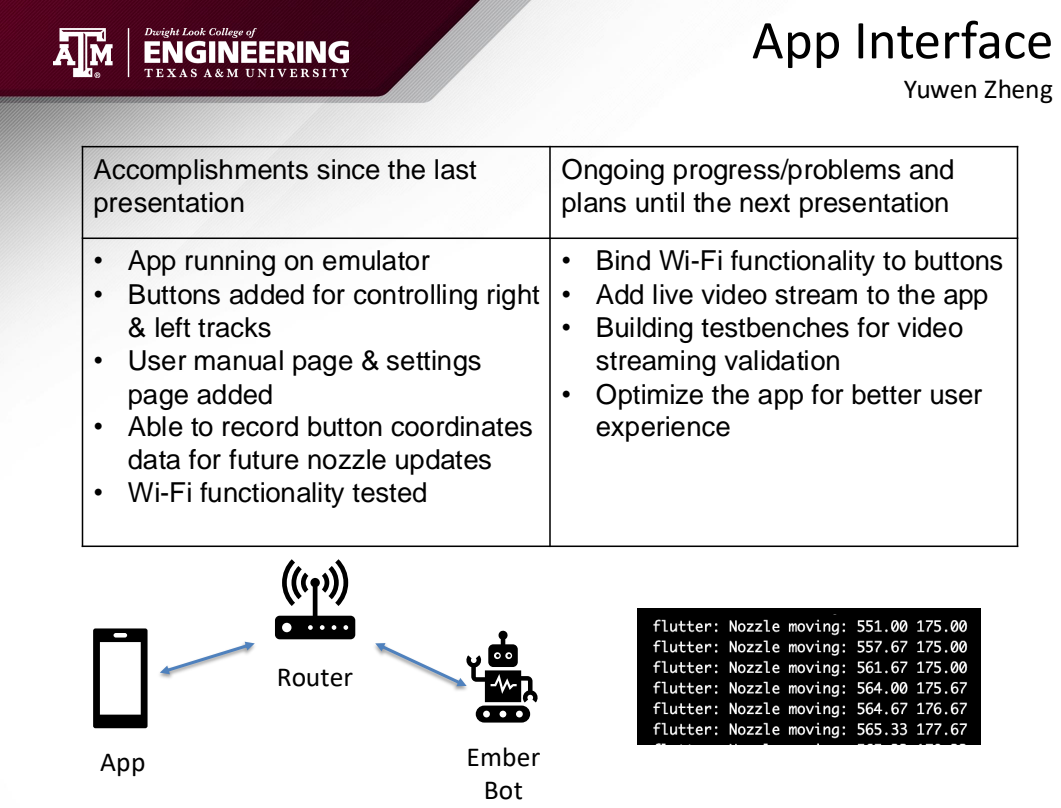
[picture p106: page 10]
Yuwen Zheng; App; Router; Ember Bot

Accomplishments since the last
presentation

Ongoing progress/problems and
plans until the next presentation

• App running on emulator
• Buttons added for controlling right
& left tracks
• User manual page & settings
page added
• Able to record button coordinates
data for future nozzle updates
• Wi-Fi functionality tested

• Bind Wi-Fi functionality to buttons
• Add live video stream to the app
• Building testbenches for video
streaming validation
• Optimize the app for better user
experience

# App UI Demo

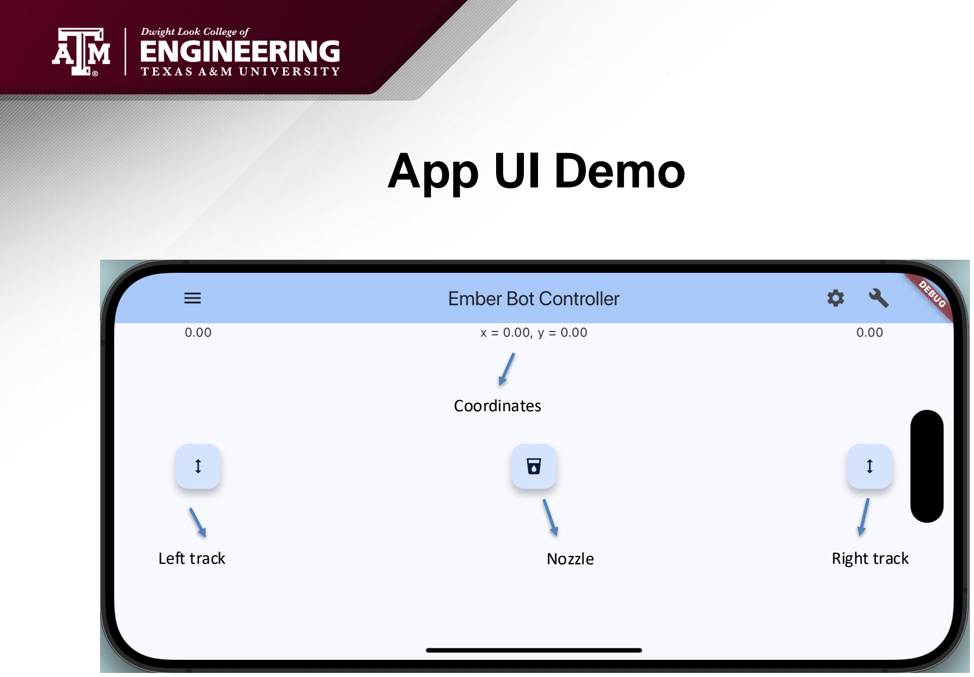
[picture p107: page 11]

Left track | Nozzle | Right track

Coordinates

# Execution Plan

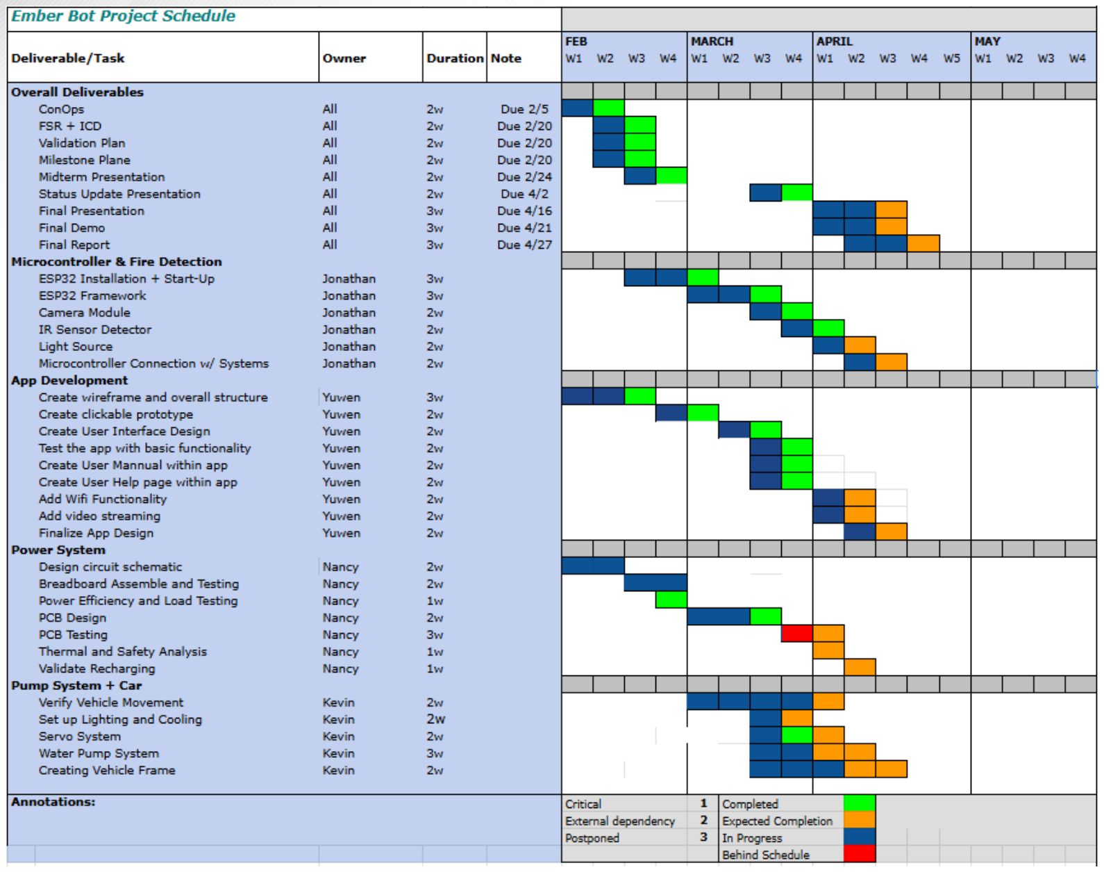
[picture p108: figure]

# Validation Plan

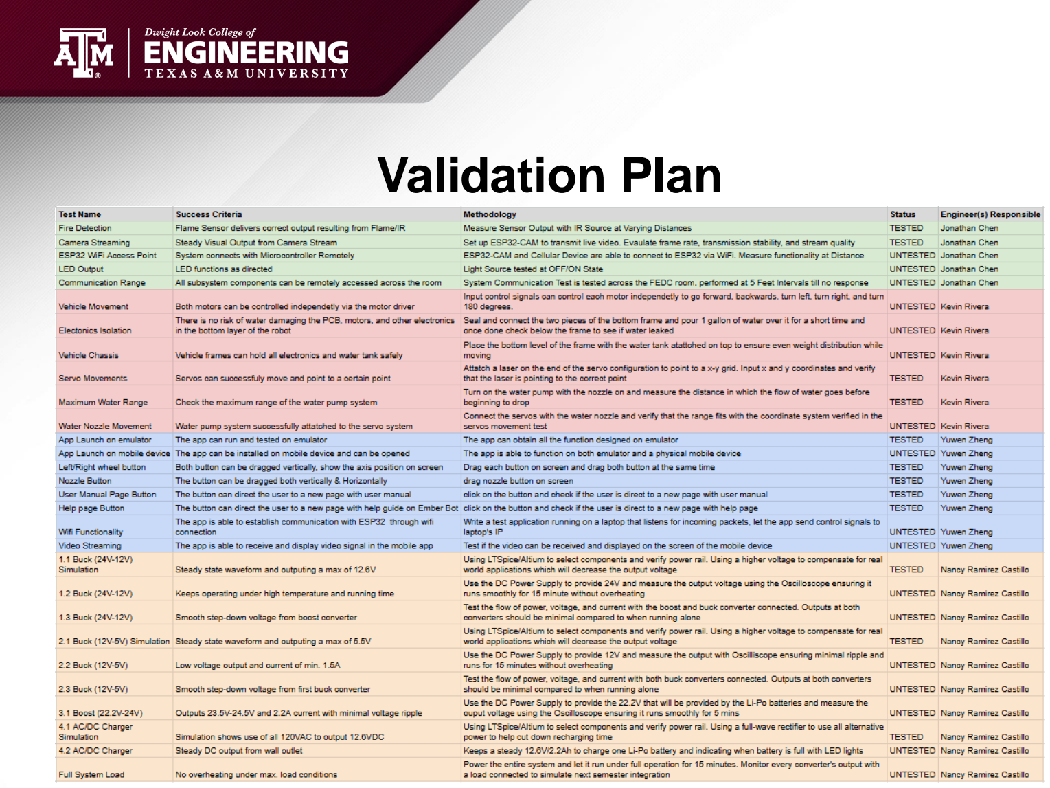
[picture p109: page 13]
