Yuwen2024/Fall-2025-Ember-Bot/Documentation/ECEN404 Final Presentation.pdf

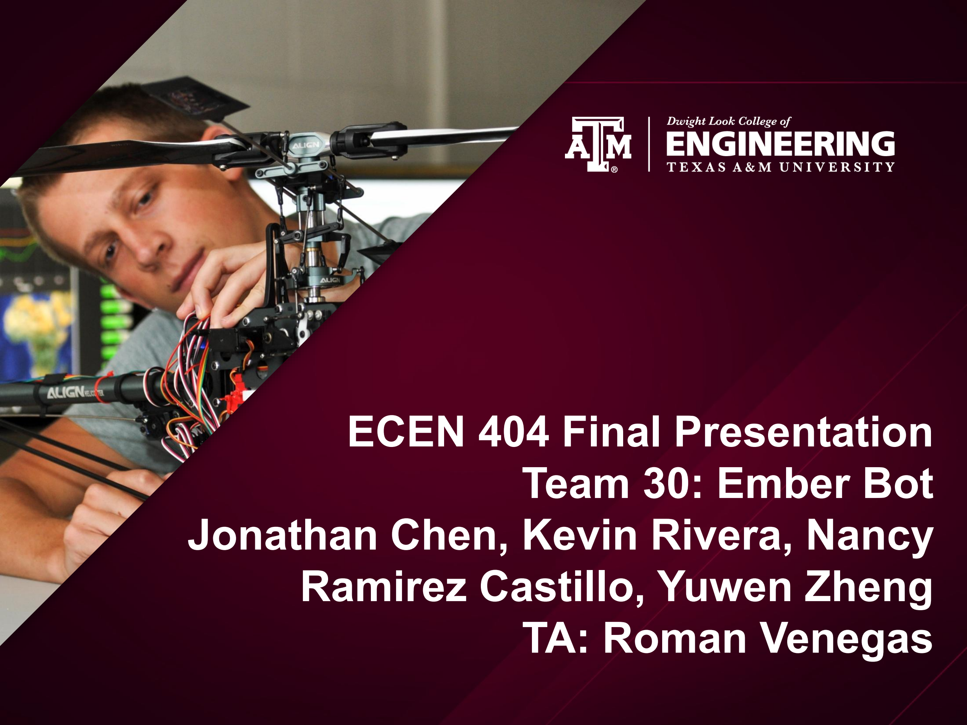
[picture p110: page 1]

# ECEN 404 Final Presentation Team 30: Ember Bot Jonathan Chen, Kevin Rivera, Nancy Ramirez Castillo, Yuwen Zheng TA: Roman Venegas

# Project Overview

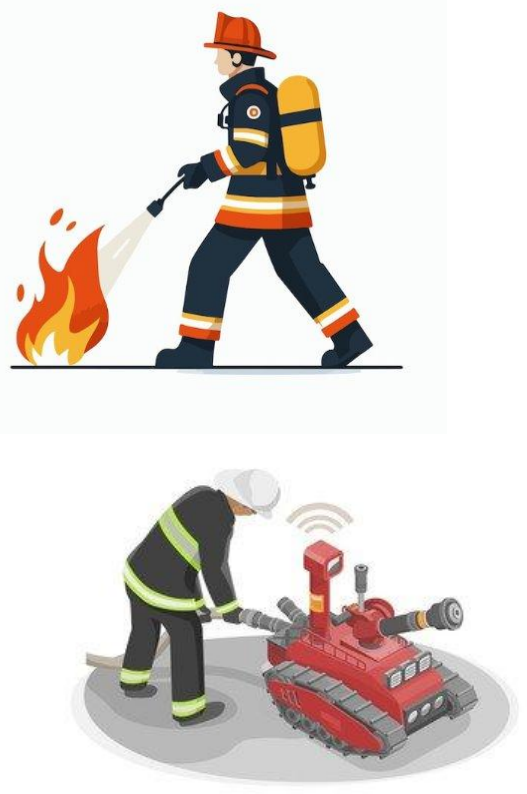
[picture p111: figure]

# Problem Statement:

# Traditional firefighting methods

place firefighters in direct danger,

# exposing them to conditions that significantly threaten their safety

and livelihood.

# Solution Proposal:

## Ember Bot introduces a remotely operated robotic vehicle that allows firefighters to

combat fires from a safe distance.

# Integrated Project Diagram

Back: | Front:

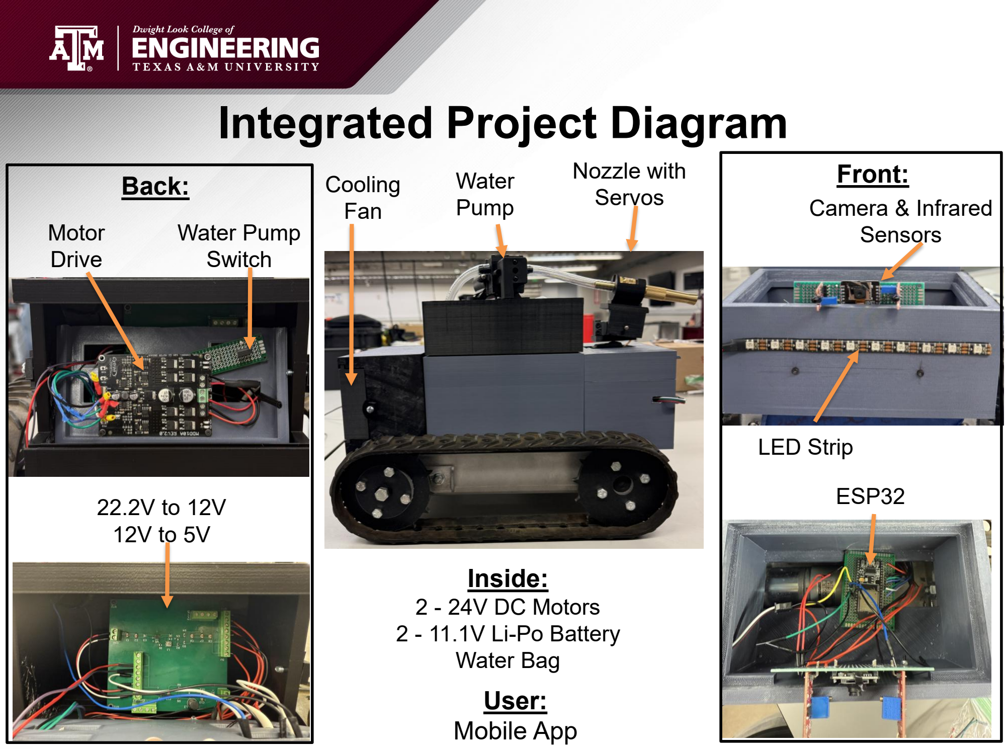
[picture p112: page 3]

Water
Pump

Nozzle with
Servos | Camera & Infrared
| Sensors

LED Strip

ESP32

Motor
Drive

Water Pump
Switch

22.2V to 12V
12V to 5V

## Inside:

2 - 24V DC Motors
2 - 11.1V Li-Po Battery
Water Bag

## User: Mobile App

Cooling
Fan

# UI Design

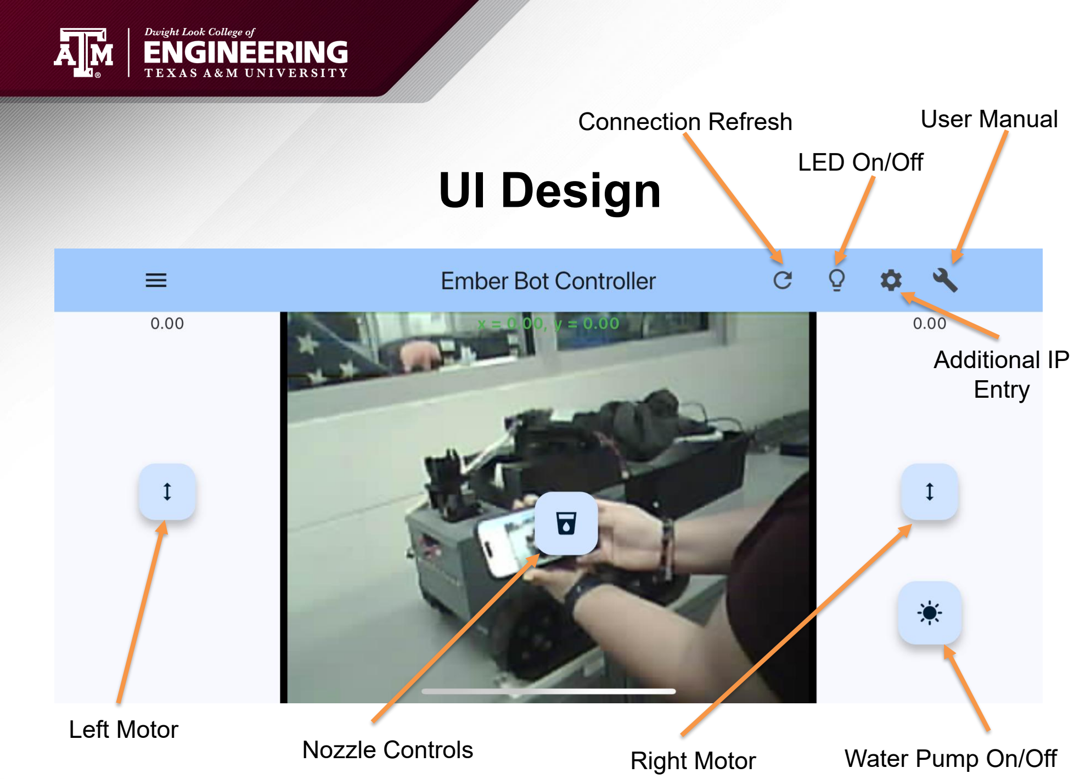
[picture p113: page 4]

Left Motor
Right Motor | Water Pump On/Off Nozzle Controls

Connection Refresh

LED On/Off

User Manual

Additional IP
Entry

# User Manual Page

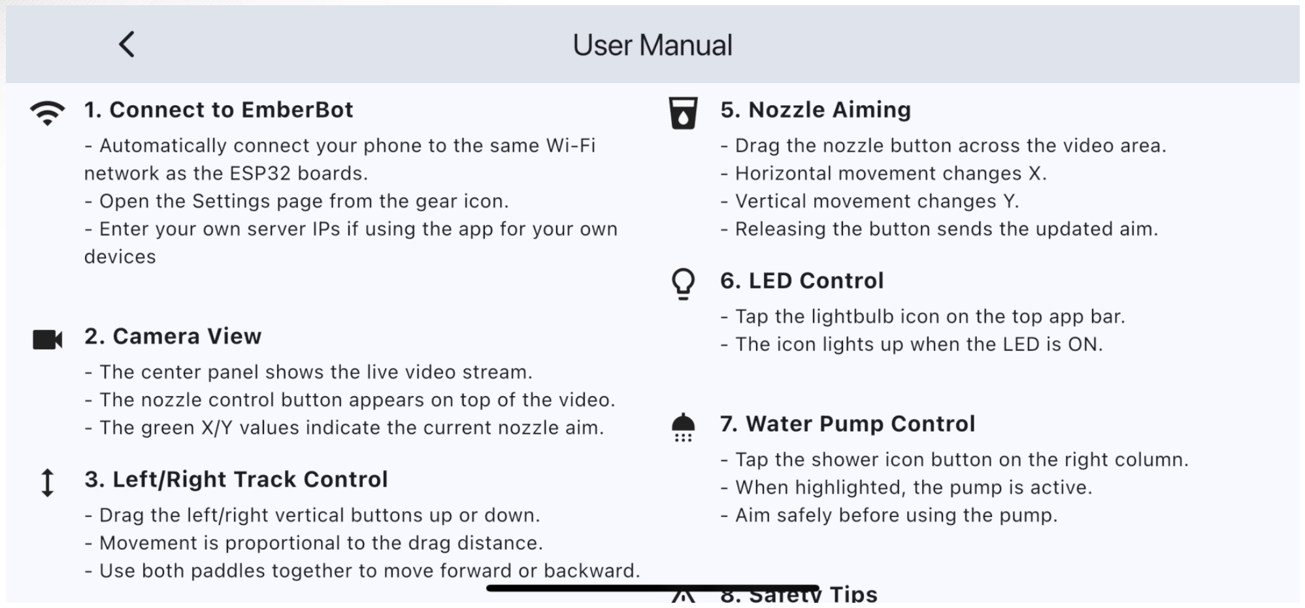
[picture p114: figure]

# Engineering Design Accomplishment

## Kevin Rivera

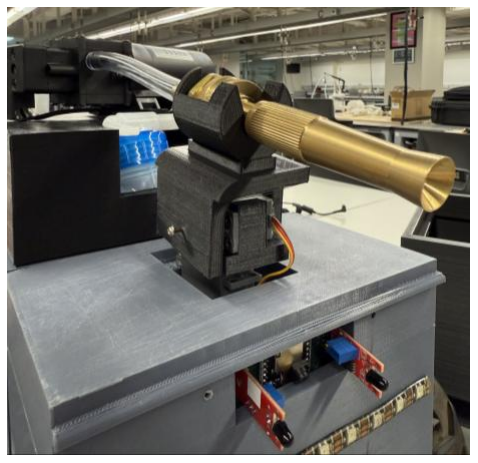
[picture p115: figure]

Parameter | Result

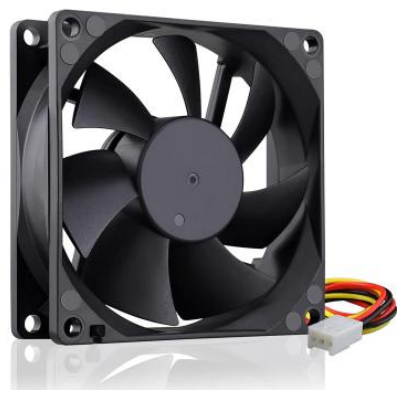
[picture p116: figure]

Nozzle Accuracy | Mean: 0.975 inches Standard Deviation: 0.764 inches

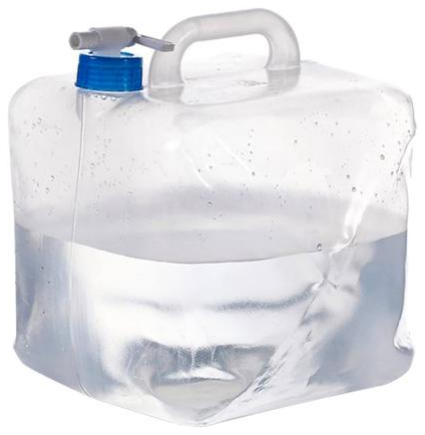
[picture p117: figure]

Water Storage | 0.92 Gallons
Water Output | 40 mL/s
Water Spray Max Range | 7ft
Total Robot Weight | 24.3 lbs
Maximum Speed | Mean: 1.72 mph
Obstacle Capability | Max: 2.1 inches (44% tread height)

## - 2 - 24V DC Motor - Motor Driver - 12V Water Pump - 2 - 5V Servos - Foldable Water Tank - Vehicle Framing - 12V Cooling Fan

# Engineering Design Accomplishment

## Kevin Rivera

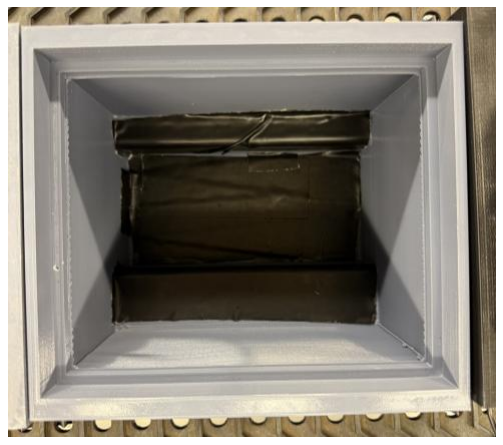
[picture p118: figure]
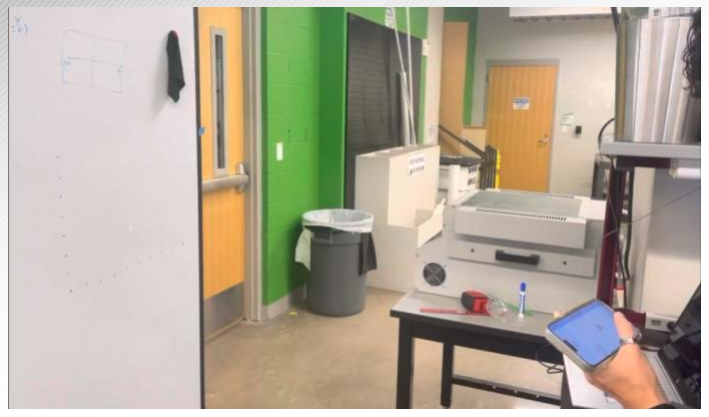
[picture p119: figure]

Challenges | Solution | Status
Increase Nozzle Accuracy | Modify code to microseconds instead of angle values | Resolved – Accuracy improved from mean 1.6 inches to 0.975 inches
Ensure All Electronics Remain Dry | Plastic water tank instead of pouring water directly into 3D print design. | Resolved – Plastic water tank safely stores water, further actions currently undergoing to ensure plenty of safety nets
Increase Nozzle Maneuverability | Swap high pressure, threaded tubing for standard tubing. | Implemented – Range of motion increased by 13.5 inches in x-direction. Y-direction needs further testing
Maximize Total Water Storage | Attach plastic water tank directly to surface of container | Not Implemented – Attaching directly will be done before final demo

# Engineering Design Accomplishments

## Nancy Ramirez Castillo

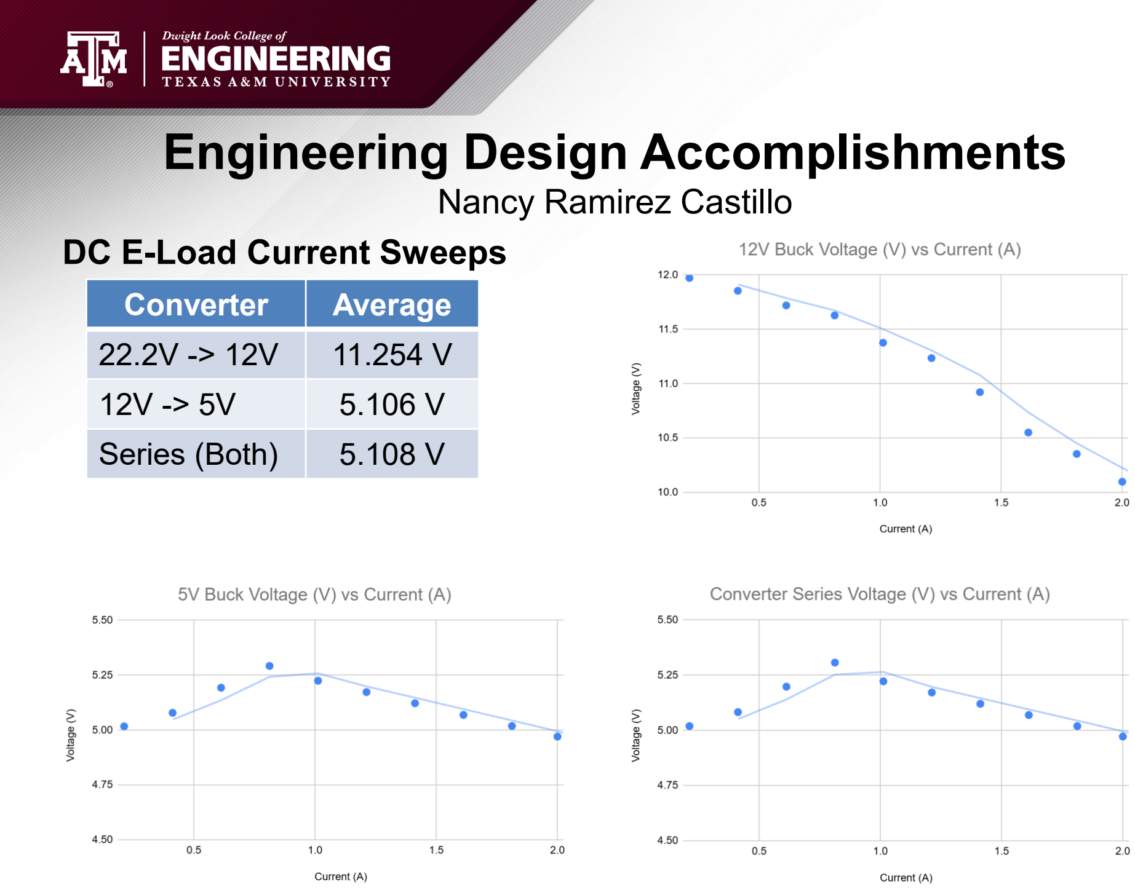
[picture p120: page 8]

Converter | Average
22.2V -> 12V | 11.254 V
12V -> 5V | 5.106 V
Series (Both) | 5.108 V

## DC E-Load Current Sweeps

# Engineering Design Accomplishments

## Nancy Ramirez Castillo

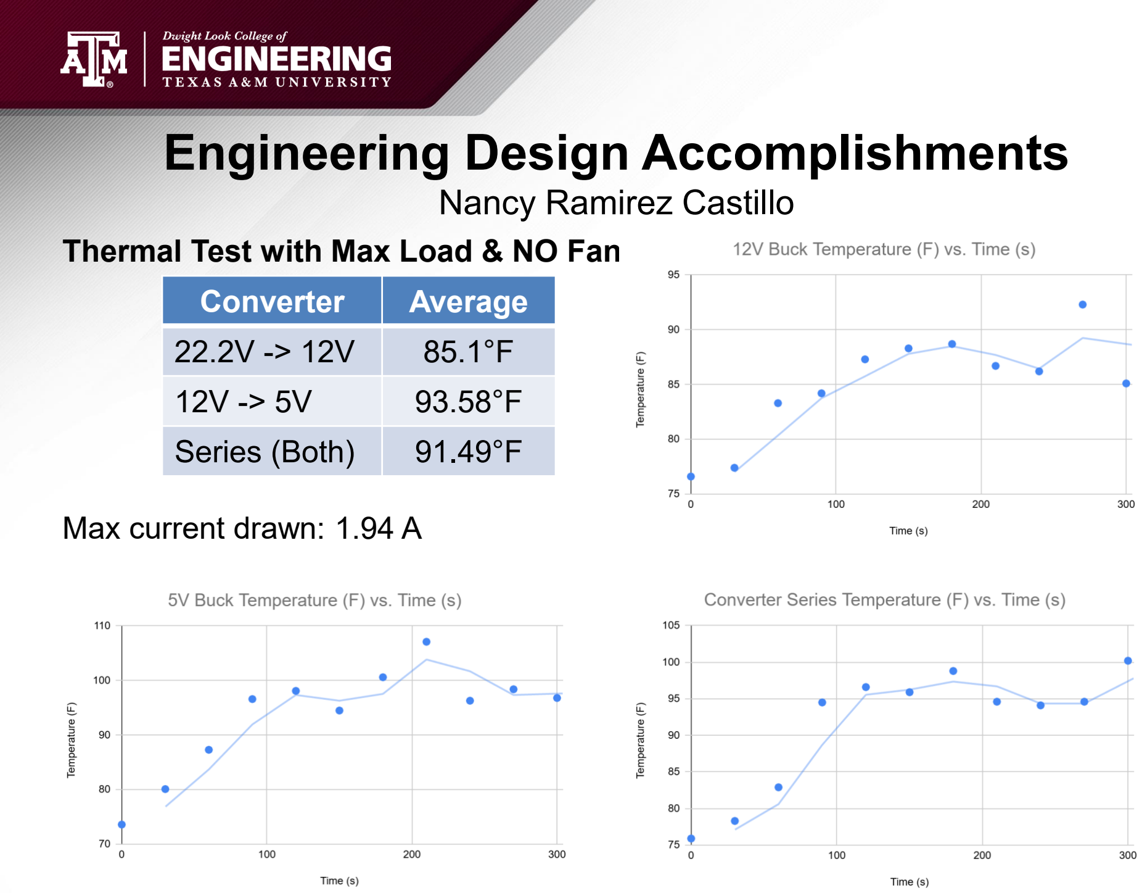
[picture p121: page 9]

Converter | Average
22.2V -> 12V | 85.1°F
12V -> 5V | 93.58°F
Series (Both) | 91.49°F

## Thermal Test with Max Load & NO Fan

## Max current drawn: 1.94 A

# Engineering Design Accomplishments

## Nancy Ramirez Castillo

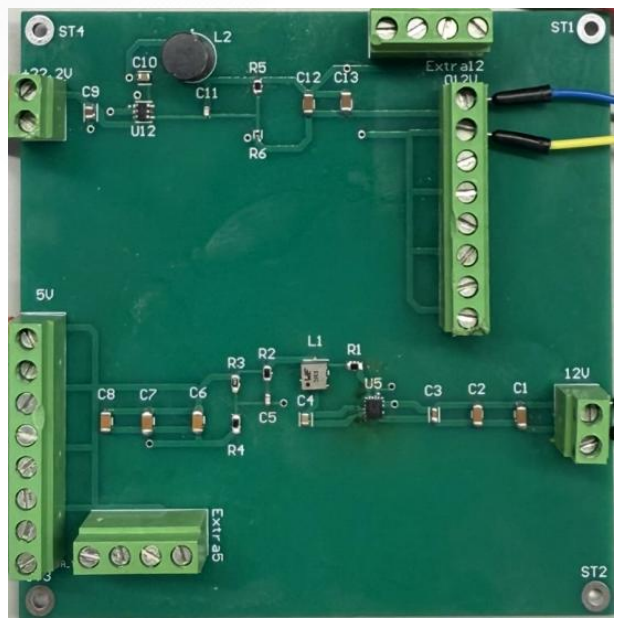
[picture p122: figure]

Challenges | Description | Status
12V -> 5V Failure | Unit worked initially, then stopped producing Vout or feedback after ~24 hrs. | Resolved — Replaced IC and inductor; converter now functional
Start-up Delay | Water pump and LED require pressing on/off twice before powering. | Unresolved — Likely power sequencing or current-limiting delay.

# Engineering Design Accomplishment

## Jonathan Chen

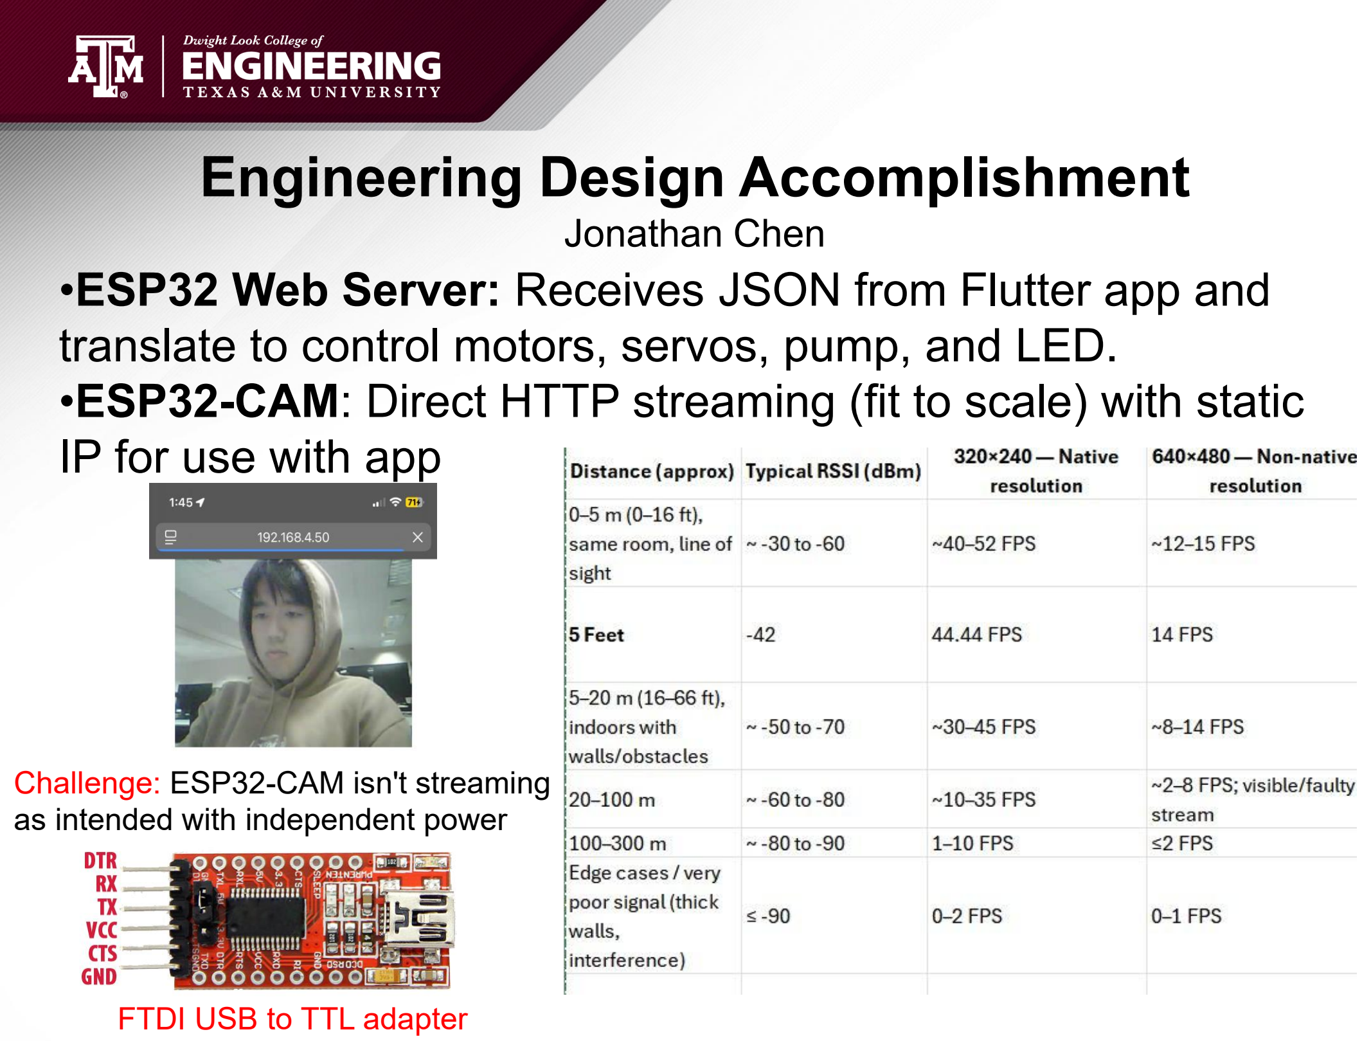
[picture p123: page 11]

# •ESP32 Web Server: Receives JSON from Flutter app and

translate to control motors, servos, pump, and LED.

# •ESP32-CAM: Direct HTTP streaming (fit to scale) with static IP for use with app

Challenge: ESP32-CAM isn't streaming as intended with independent power

FTDI USB to TTL adapter

# Engineering Design Accomplishment

## Jonathan Chen

Challenge: ESP32 has
latency in data handling
from delays in processing
incoming JSON files

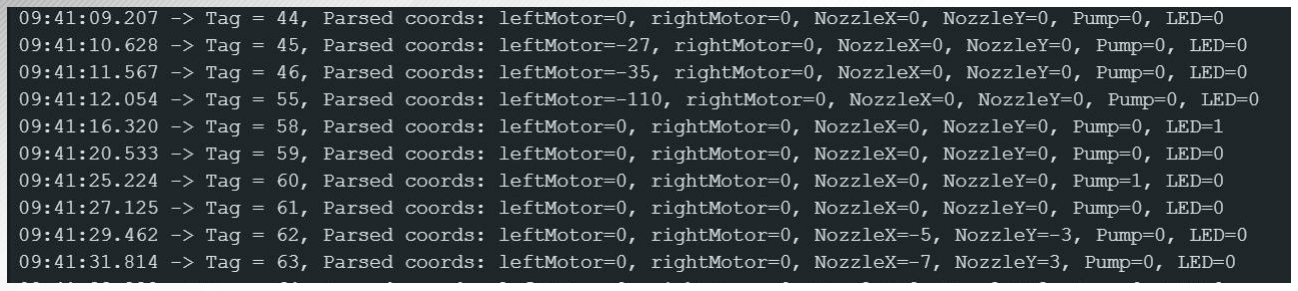
[picture p124: figure]

Solution: Implemented a
tagging system with integrity and timing checks as well as multiple JSON validation
functions.

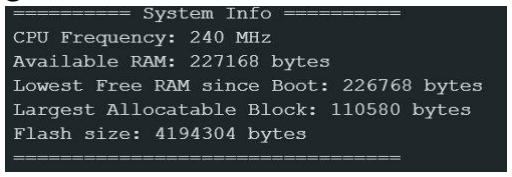
[picture p125: figure]

### ESP32 Internal Diagnostics

Control | Result (Response < 500 ms)

Left Motor & Right Motor

Nozzle X & Nozzle Y

Pump

LED

Tests Conducted Per Variable | 100
Average Response Time | 483 ms

# Mobile App Design Accomplishments

## Yuwen Zheng

- Designed and built a mobile app as a controller for the Ember Bot using Flutter - The mobile app can automatically connect to the Ember Bot when opened - The App can support functionalities such as moving the robot, turn LED ON/OFF, video streaming, reconnecting to the Ember Bot and shooting waters - Provide user manual guide for users in the app - Designed a different version for iPads

# Mobile App Validation

- All functionalities are successfully tested on iOS/Android emulators, 4 different iOS devices and on the physical Ember Bot - Tested the accuracy of the App when sending motor control signals - Tested how easily users can understand the user manual guide - Cannot test on Android physical devices due to lack of product but tested on the android emulator

# Tested Devices & Accuracy

Devices | Results
iPhone 16 Promax | Loaded | Successfully connected to Ember Bot
iPhone 16 Pro | Loaded | Successfully connected to Ember Bot
iPhone 16 Pro | Loaded | Successfully connected to Ember Bot
iPhone 13 | Loaded | Successfully connected to Ember Bot
iPad Air | Loaded | Successfully connected to Ember Bot
Android Emulator | Loaded | Successfully connected to Server
Using scenario | Average % of Accuracy
Motor Button Dragging Slowly | 97.55%
Motor Button Flicking | 91.10%

## The accuracy tends to be lower when the data set is larger and when user flick buttons

faster.

## This does not affect the motor behavior

# Integrated System Results

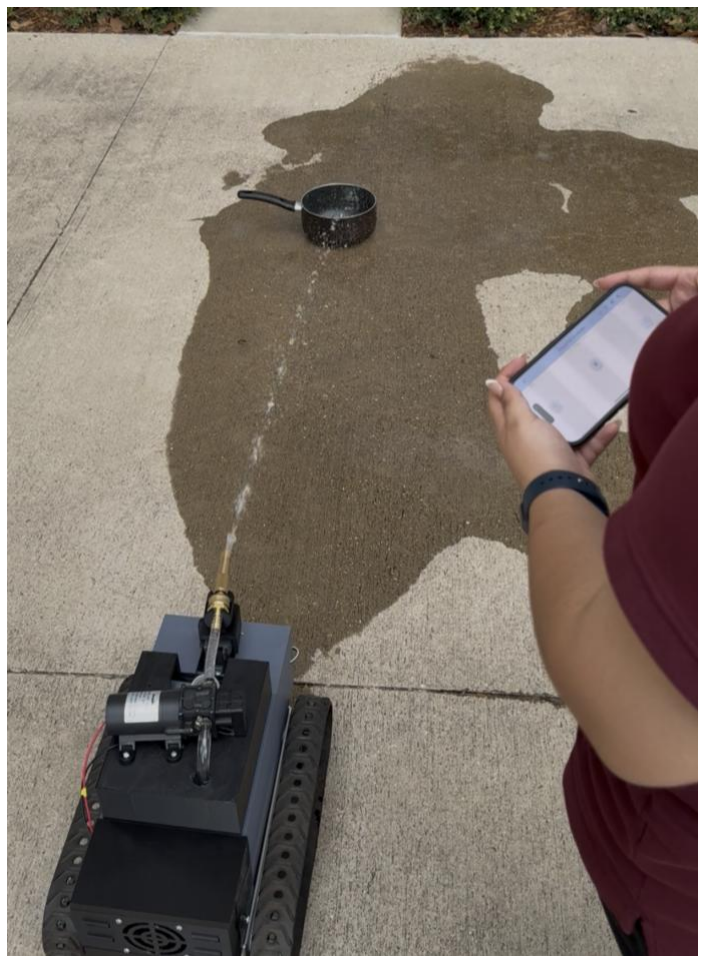
[picture p126: figure]

## - Test Parameter: - Drive Ember Bot 10 ft to a point 5 ft away

from the target.

## - Aim and shoot the nozzle to hit the target - Volume of water landing inside to be tracked - Result: - Ember Bot successfully controlled

through mobile app.

## - Target was hit after moving the nozzle

with user adjustment.

## - Total volume shot: 490 mL - Total volume inside target: 250mL - Target total volume shot: Minimum 75% of volume inside target (438 mL)

# Conclusion

Issue | Original Assumption (ConOps/FSR/ICD) | Design Change / Mitigation
IR Flame Sensors don't work outside | KY-026 Sensors would function as a flame detector in working scenarios – Inside Situation (ICD 5.2) | Removed Flame Sensor Detection for Outside Cases, left for additional features if desired in the future
Multiple Connections to ESP32 Access Point | Only one connection would be needed from App to Microcontroller (FSR 4.1.1) | Used multiple connections: HTTP /coords server runs independently from camera streaming using static IPs
High pressure threaded tubing being inflexible | The tubing would be able to deliver water in a high-pressure manner to ensure maximum range (FSR 3.1.2.5) | Swapped out high pressure tubing for standard tubing
22.2V -> 24V Boost Converter | Originally planned boost to 24V to achieve motor top speed. (FSR 3.2.1.3) | Removed as it's not required after weight & test data showed 22.2V is sufficient.

# Current Status: Full Integrated Complete, on Final Testing & Minor Debugging, Final Demo Testing Course Preparation

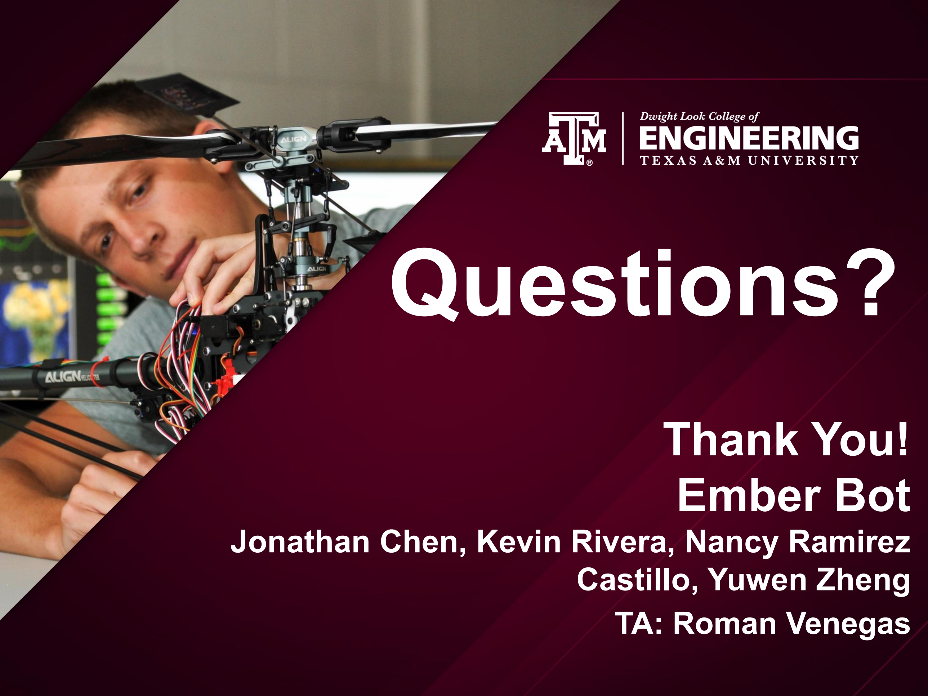
[picture p127: page 18]

# Thank You! Ember Bot

# Jonathan Chen, Kevin Rivera, Nancy Ramirez Castillo, Yuwen Zheng

# TA: Roman Venegas

# Questions?
