Yuwen2024/Fall-2025-Ember-Bot/Documentation/ECEN404 Status Update #1.pdf

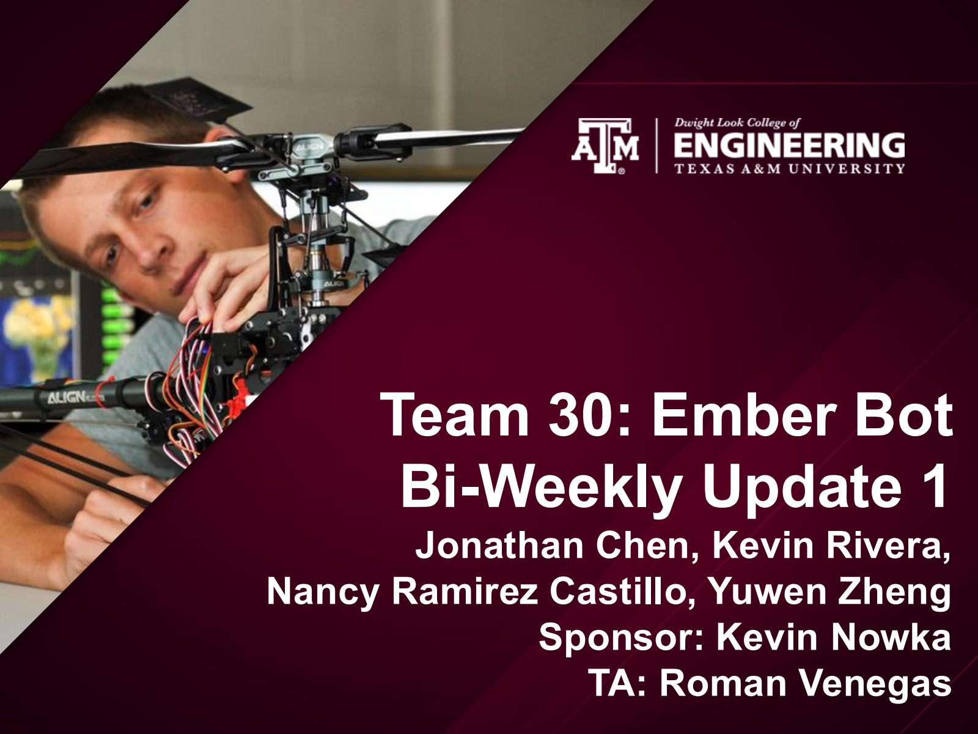
[picture p128: page 1]

# Team 30: Ember Bot Bi-Weekly Update 1

Jonathan Chen, Kevin Rivera,

## Nancy Ramirez Castillo, Yuwen Zheng Sponsor: Kevin Nowka TA: Roman Venegas

# Project Summary

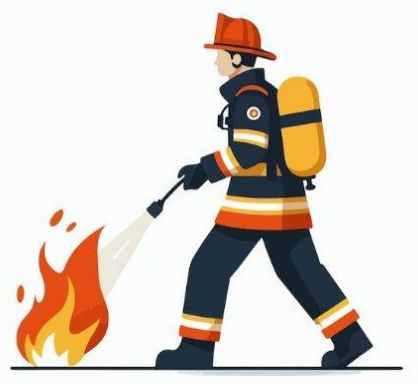
[picture p129: figure]

## Problem Statement:

Traditional firefighting methods rely on human intervention, exposing personnel to extreme hazards such as heat, toxic smoke, and structural collapse. These settings can pose safety risks and potential response delays, especially in hard-to-reach areas.

# Project Summary

## Solution Proposal:

Ember Bot is a fire-fighting robotic vehicle designed to detect and extinguish small fires in high-risk areas through a mobile app. Equipped with IR sensors and a camera, firefighters will be able to control Ember Bot in areas deemed unsafe for humans.

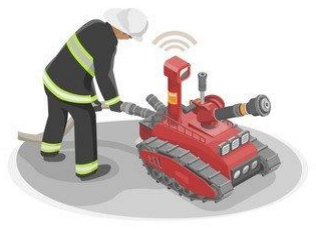
[picture p130: figure]

# System Overview

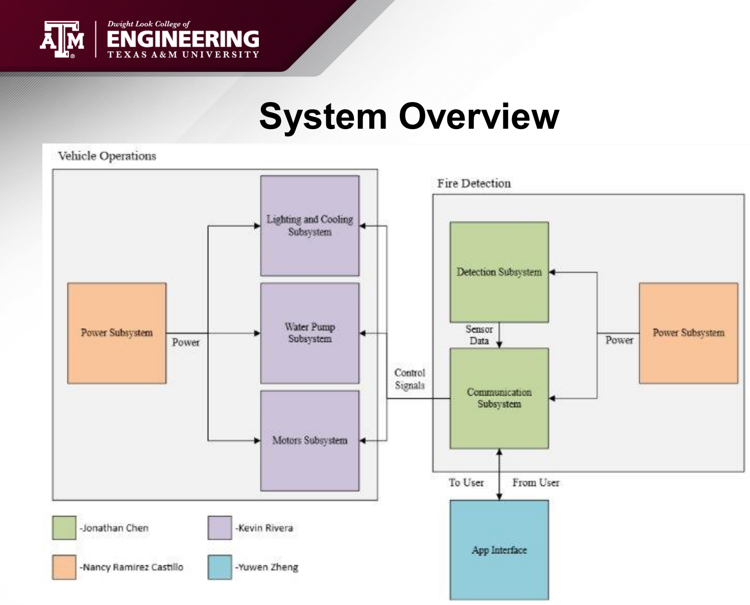
[picture p131: page 4]

# Major Project Changes for 404

Major Changes | Reasons & Purpose
- Frame Redesign
- Power Restructure
- Database & Server
- Collaboration
- New design to lower center of mass and decrease overall height
- No need for the 24V boost converter
- To store user data
- For better integration of the project

# Project Timeline

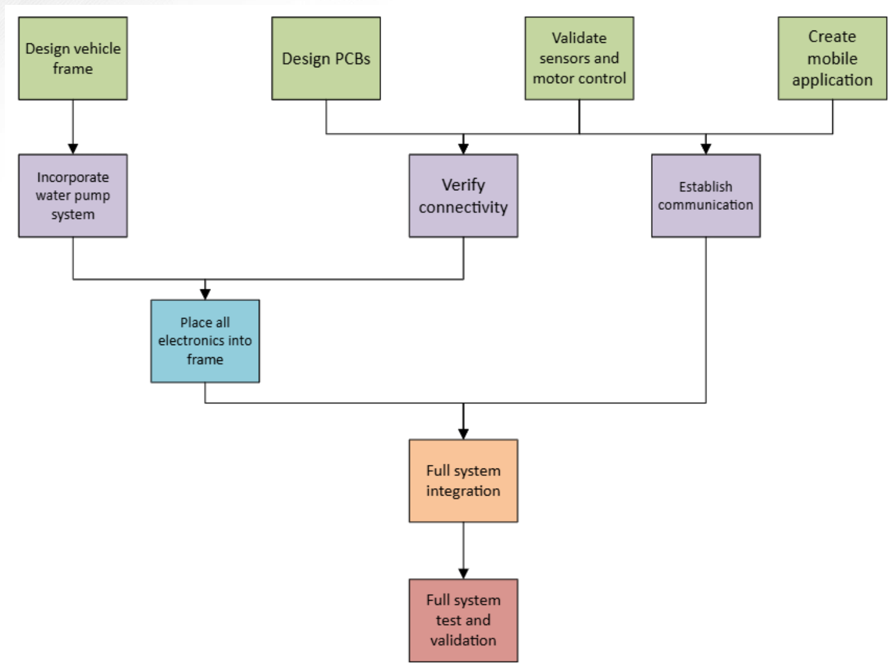
[picture p132: figure]

# Microcontroller Subsystem

Jonathan Chen

Accomplishments since 403
9 hrs of effort

Ongoing progress/problems and plans until the next presentation

- Set Up IR Detection and Camera from 403 with minor code
upgrades
- Set Up Static IP Address for Wi-Fi Connectivity
- Started Integrating Camera with Mobile App Interface
- Assisting on creating PCBs for components on robot
- Looking into Data Server possibilities for other subsystems

# Microcontroller Subsystem

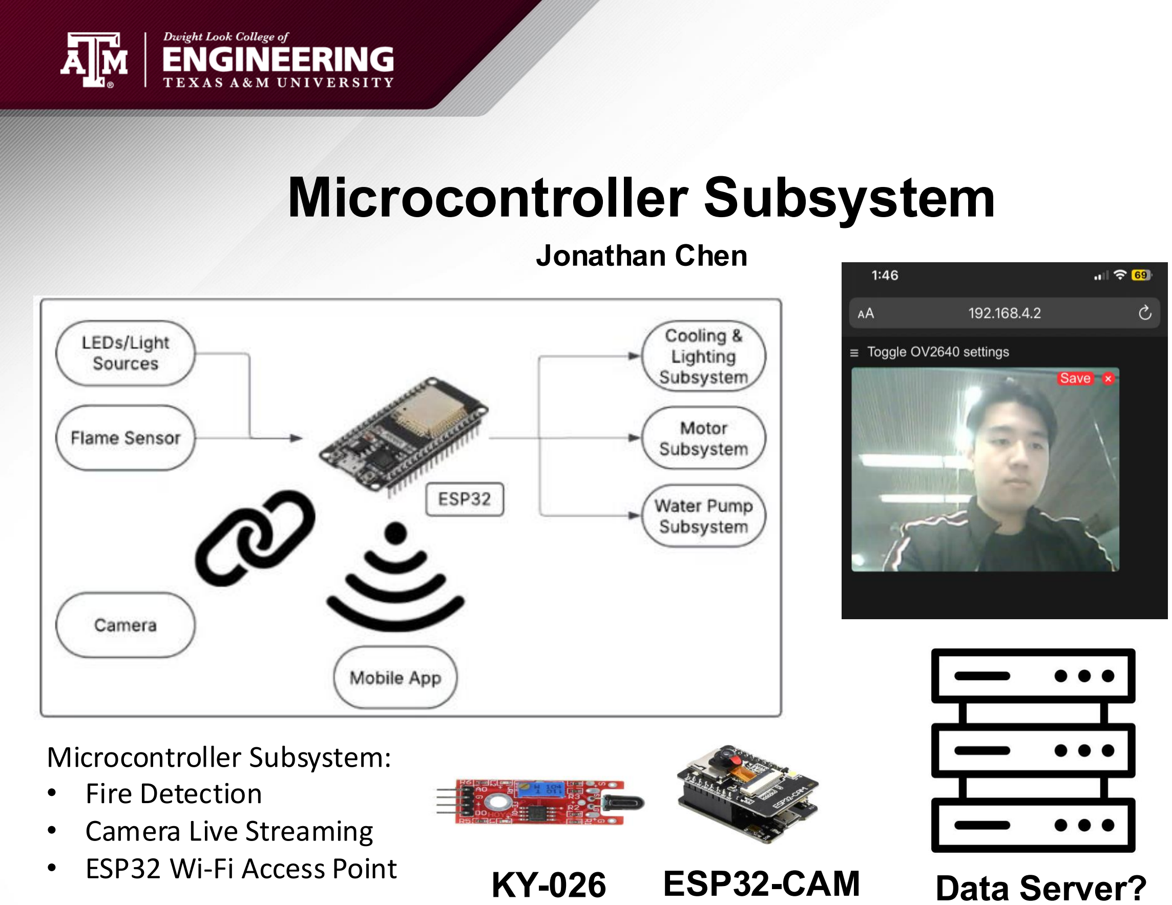
[picture p133: page 8]

Jonathan Chen

Microcontroller Subsystem:
- Fire Detection
- Camera Live Streaming
- ESP32 Wi-Fi Access Point | KY-026 | ESP32-CAM | Data Server?

# Vehicle Operations & Water Pump

Kevin Rivera

Accomplishments since 403 8 hrs of effort | Ongoing progress/problems and plans until the next presentation
- Completed first version of frame redesign | - Optimize code for motor control and servos - Assist in new PCB designs to connect servos and water pump

# Vehicle Operations & Water Pump

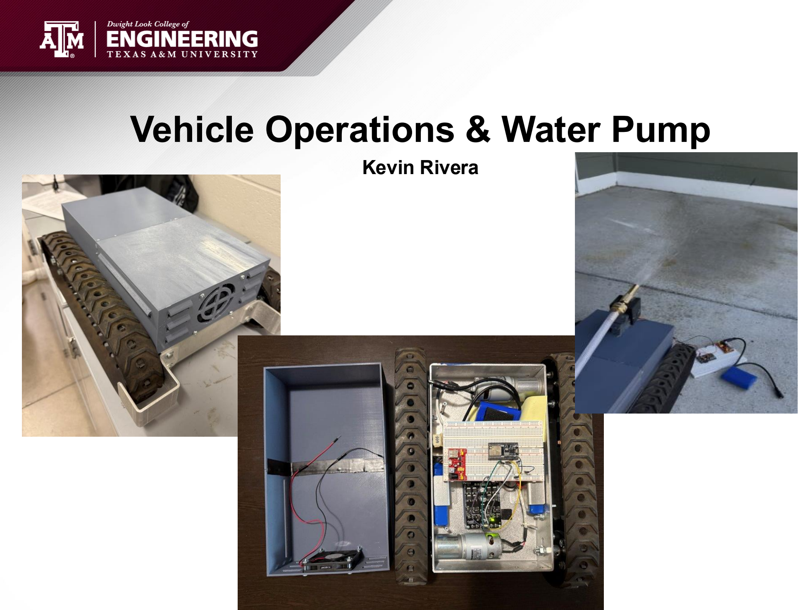
[picture p134: page 10]

Kevin Rivera

# Vehicle Operations & Water Pump

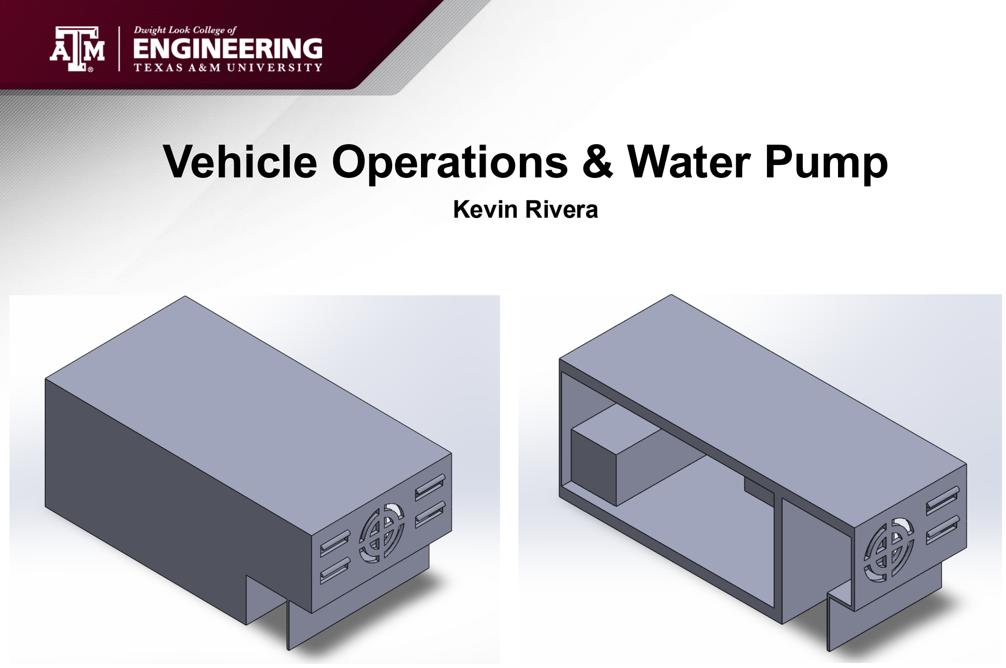
[picture p135: page 11]

Kevin Rivera

# Power & Recharging

Nancy Ramirez Castillo

Accomplishments since 403 8 hrs of effort | Ongoing progress/problems and plans until the next presentation
- Battery Charger - Completed editing current PCB traces on buck converters | - Design one PCB to isolate ESP32 and all I/O from other subsystems - Implement battery percentage monitor - Assist in creating a water monitor

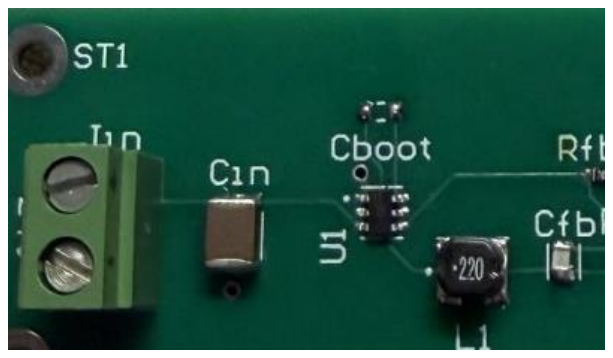
[picture p136: figure]

- Traces were too small for the high discharge batteries, so they kept frying while testing, shown on Cboot

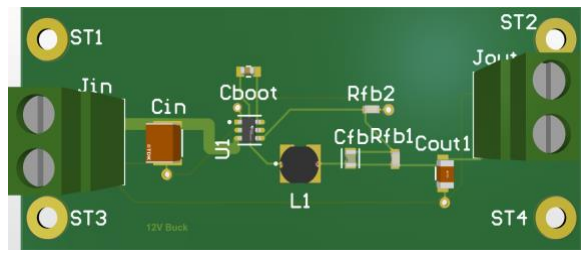
[picture p137: figure]
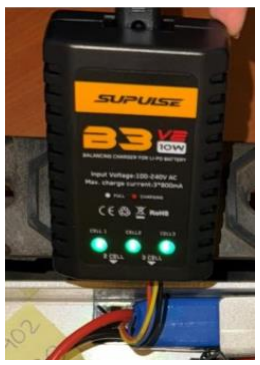
[picture p138: figure]

- Battery charger has been tested two times and takes ~1.5 hrs to fully charge
- 24V Boost Converter is low priority, eliminating completely

# Power & Recharging

Nancy Ramirez Castillo

# App Interface

Yuwen Zheng

Accomplishments since 403
12 hrs of effort

Ongoing progress/problems and plans until the next presentation

- Reloaded the mobile app on iPhone
- The mobile app can send
coordinates data to a Python Flask server with different IP Address
- The mobile app can display online video
- Implement the code for video streaming
- Integrate video streaming with ESP32

# App Interface

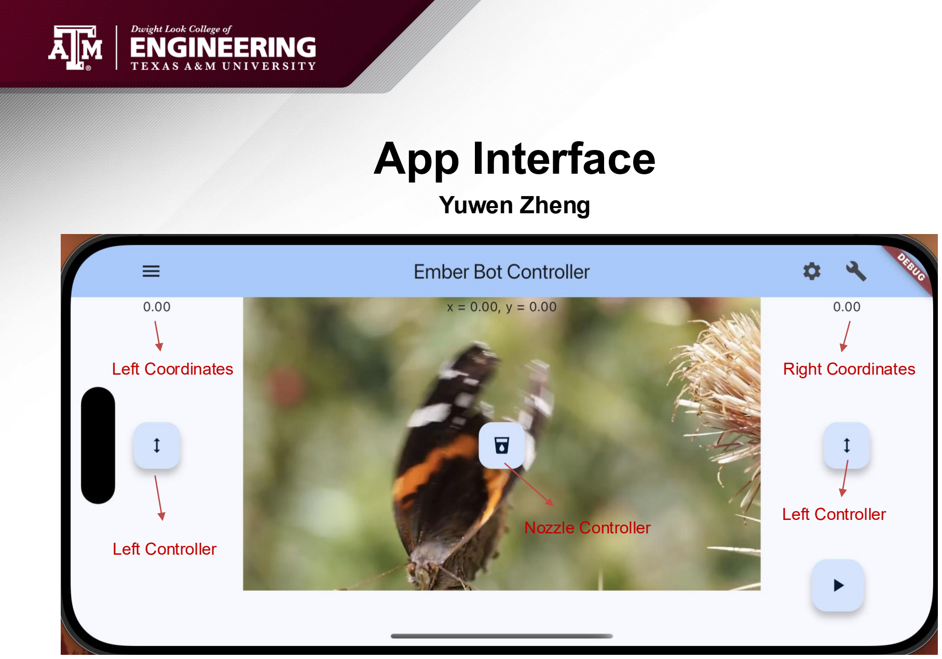
[picture p139: page 15]

Yuwen Zheng

Left Coordinates

Left Controller

Right Coordinates

Left Controller
Nozzle Controller

# Parts Ordering Status

- ESP32 PCB & Components
- Will be complete and ordered by next week 9/18
- Extra battery charger
- Ordering tomorrow, not yet received
- Buck Converters Components
- None needed, have plenty of extras

# Execution Plan

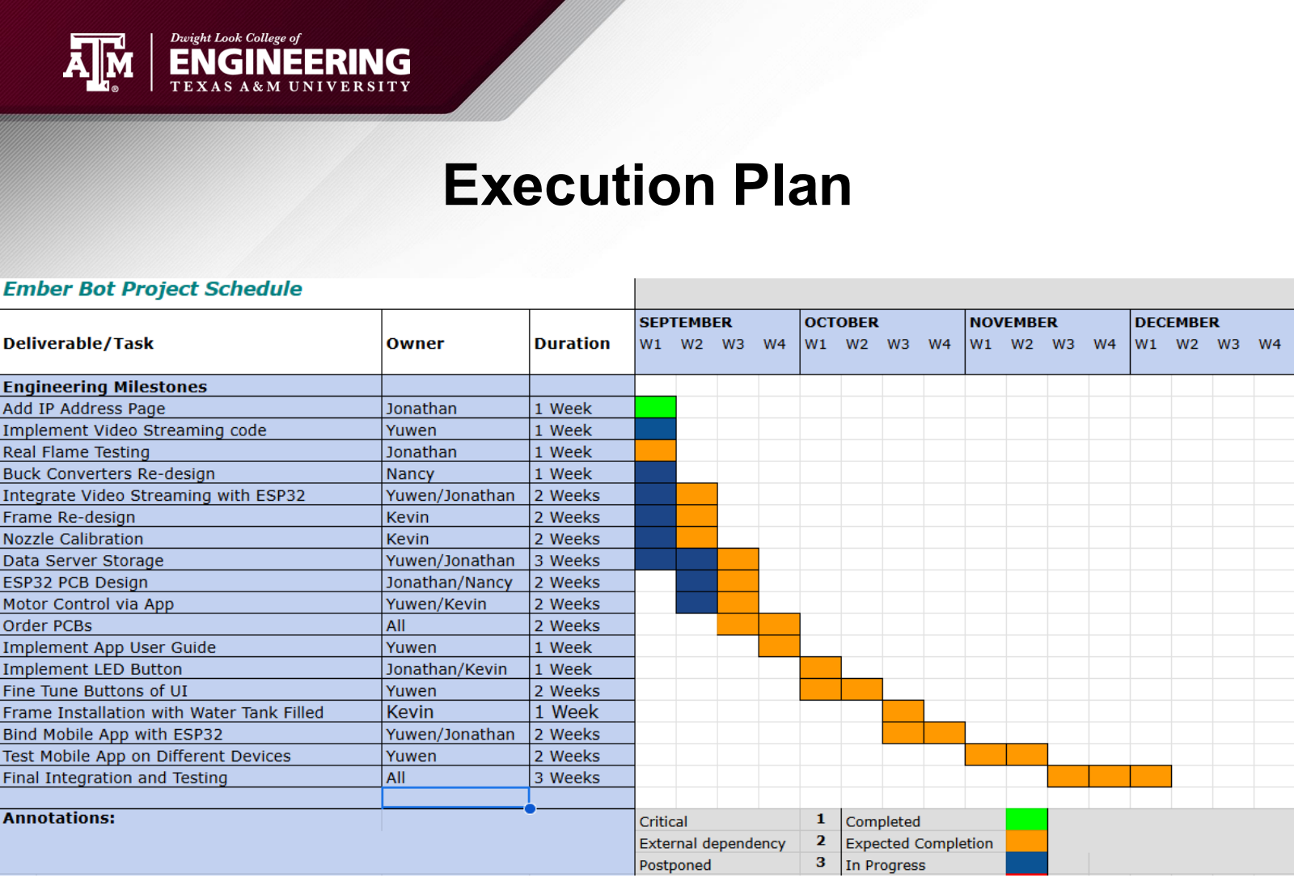
[picture p140: page 17]

# Validation Plan

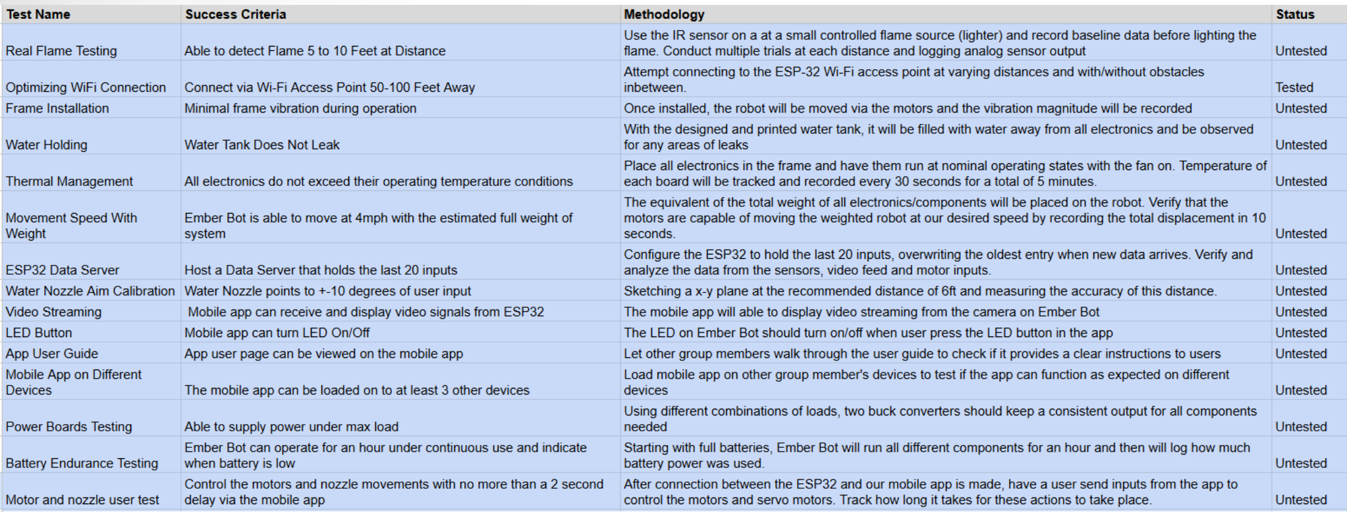
[picture p141: figure]
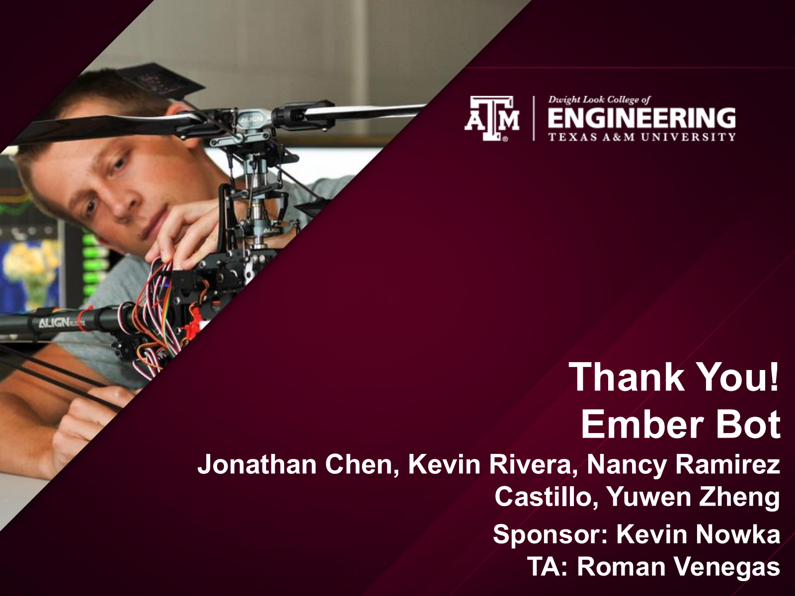
[picture p142: page 19]

# Thank You! Ember Bot

## Jonathan Chen, Kevin Rivera, Nancy Ramirez

## Castillo, Yuwen Zheng

## Sponsor: Kevin Nowka TA: Roman Venegas
