Yuwen2024/Fall-2025-Ember-Bot/Documentation/ECEN404 Status Update #2.pdf

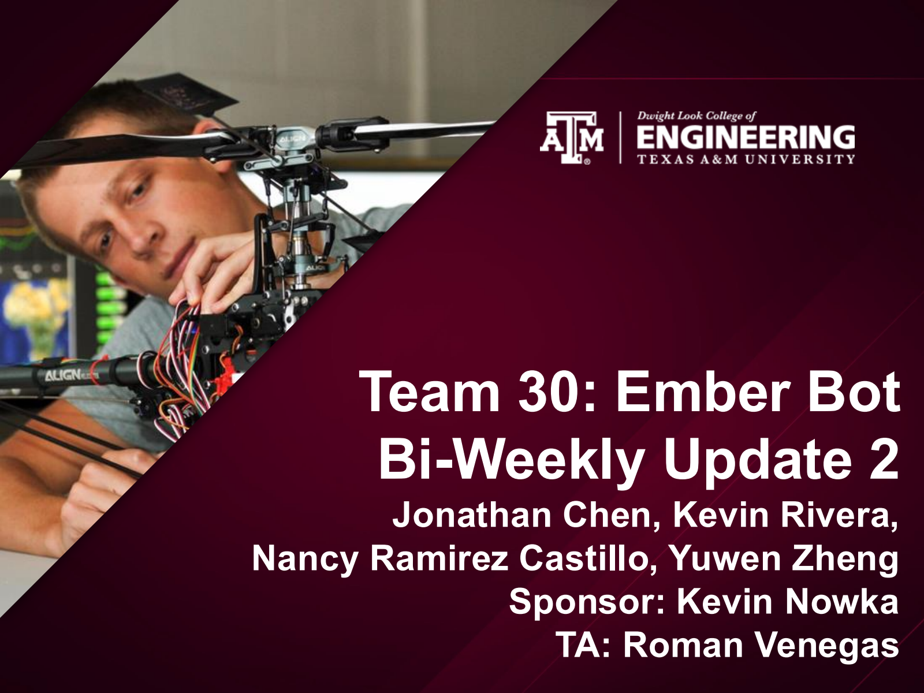
[picture p143: page 1]

# Team 30: Ember Bot Bi-Weekly Update 2

Jonathan Chen, Kevin Rivera,

## Nancy Ramirez Castillo, Yuwen Zheng Sponsor: Kevin Nowka TA: Roman Venegas

# Project Summary


# Problem Statement:

## Traditional firefighting methods rely on human intervention, exposing personnel to extreme hazards such as heat, toxic smoke, and structural collapse. These settings pose safety risks, especially in hard-to-reach

areas.

# Project Summary

## Solution Proposal:

Ember Bot is a mobile-controlled fire-fighting robotic vehicle equipped with IR sensors and a live camera feed, enabling firefighters to remotely detect and extinguish small fires in hazardous areas where human presence is unsafe.


# System Overview

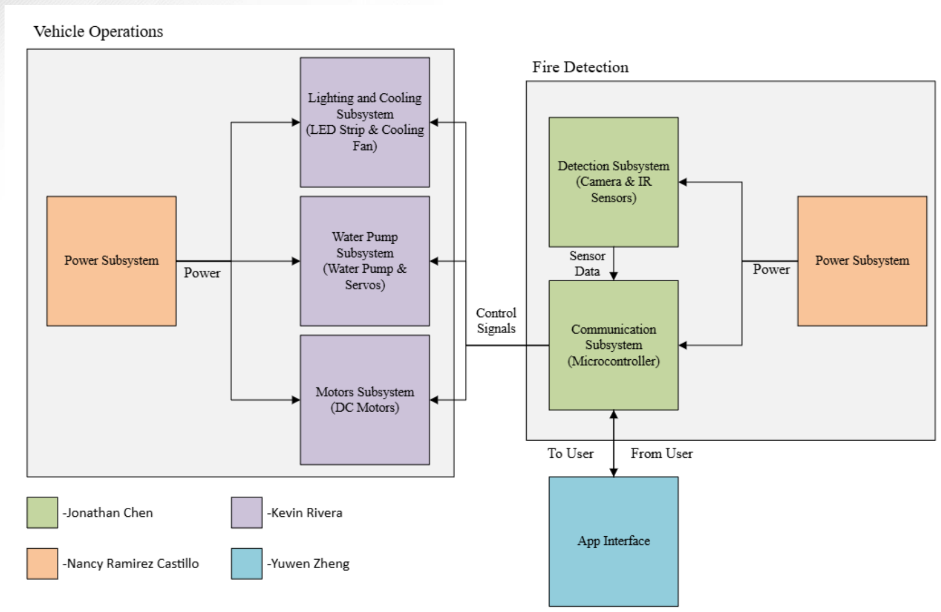
[picture p144: figure]

# Project Timeline

Subsystem
Designs and
Testing
(completed
9/11)

Integration of
motor
subsystem
and MCU
(completed
9/17)

Integration of
Wi-Fi and
iPhone App
(to complete
by 9/28)

Individual
Subsystem
Power Test
(to complete
by 10/15)

Frame
Placement
Integration
(to complete
by 11/2)

Integration
Validation
(to complete
by 11/26)

Demo and
Report
(to complete
by 12/5)

Accomplishments since last update 9 hours of effort

Ongoing progress/problems and plans until the next presentation
- Completed Video Streaming Integration with Mobile App
- Tested independent IR Sensors and Camera with real-life
situation
- Designing and Testing New Frame for IR Sensor Constraints
- Implementing PCBs integration with Power and Motor
Subsystems
- By next review, will be able to receive information from App Inputs
- Optimizing camera output display with mobile app

# Microcontroller Subsystem

Jonathan Chen

# Microcontroller Subsystem

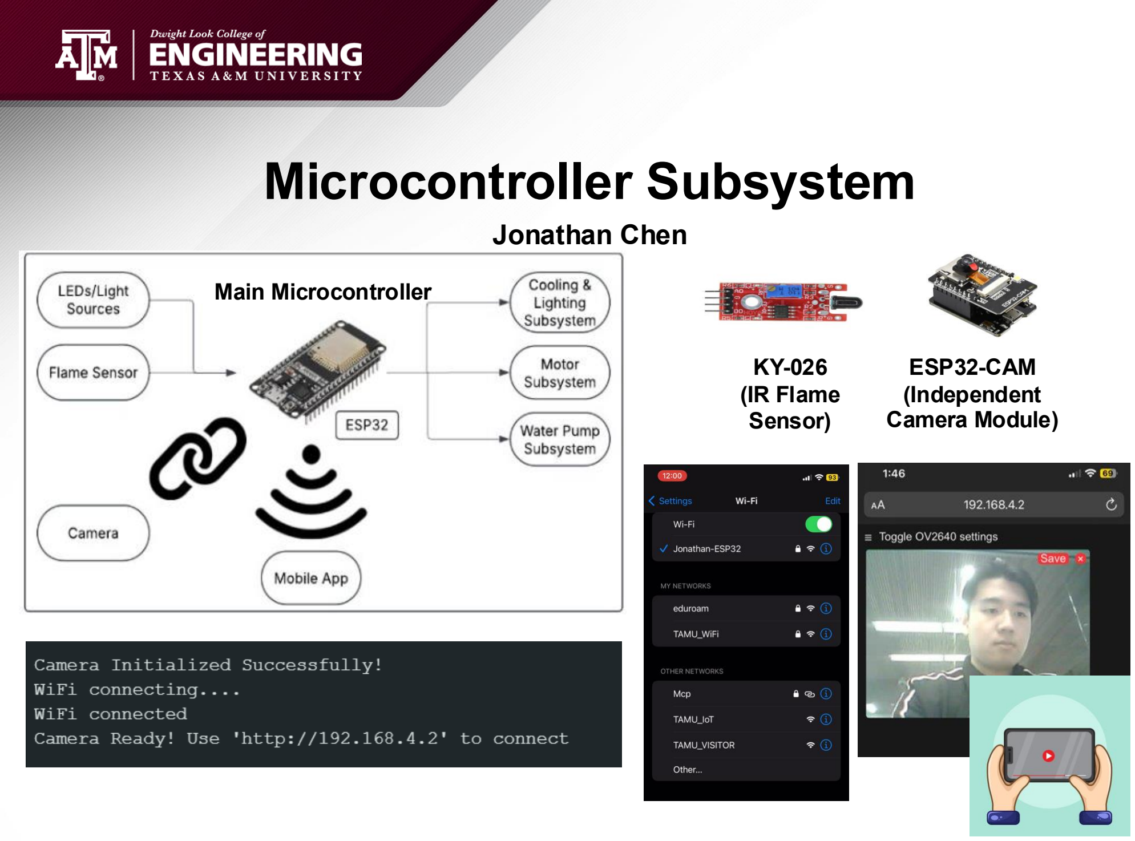
[picture p145: page 7]

Jonathan Chen

KY-026
(IR Flame
Sensor)

ESP32-CAM
(Independent
Camera Module)

Main Microcontroller

## Vehicle Operations & Water Pump Subsystem

Kevin Rivera

Accomplishments since last update 10 hrs of effort | Ongoing progress/problems and plans until the next presentation
- Separated robot cover frame into 3 sections | • Verify user-input code to integrate with mobile app • Secure cover frame onto metal base to begin placing all boards/sensors

# Vehicle Operations & Water Pump


Kevin Rivera

# Vehicle Operations & Water Pump

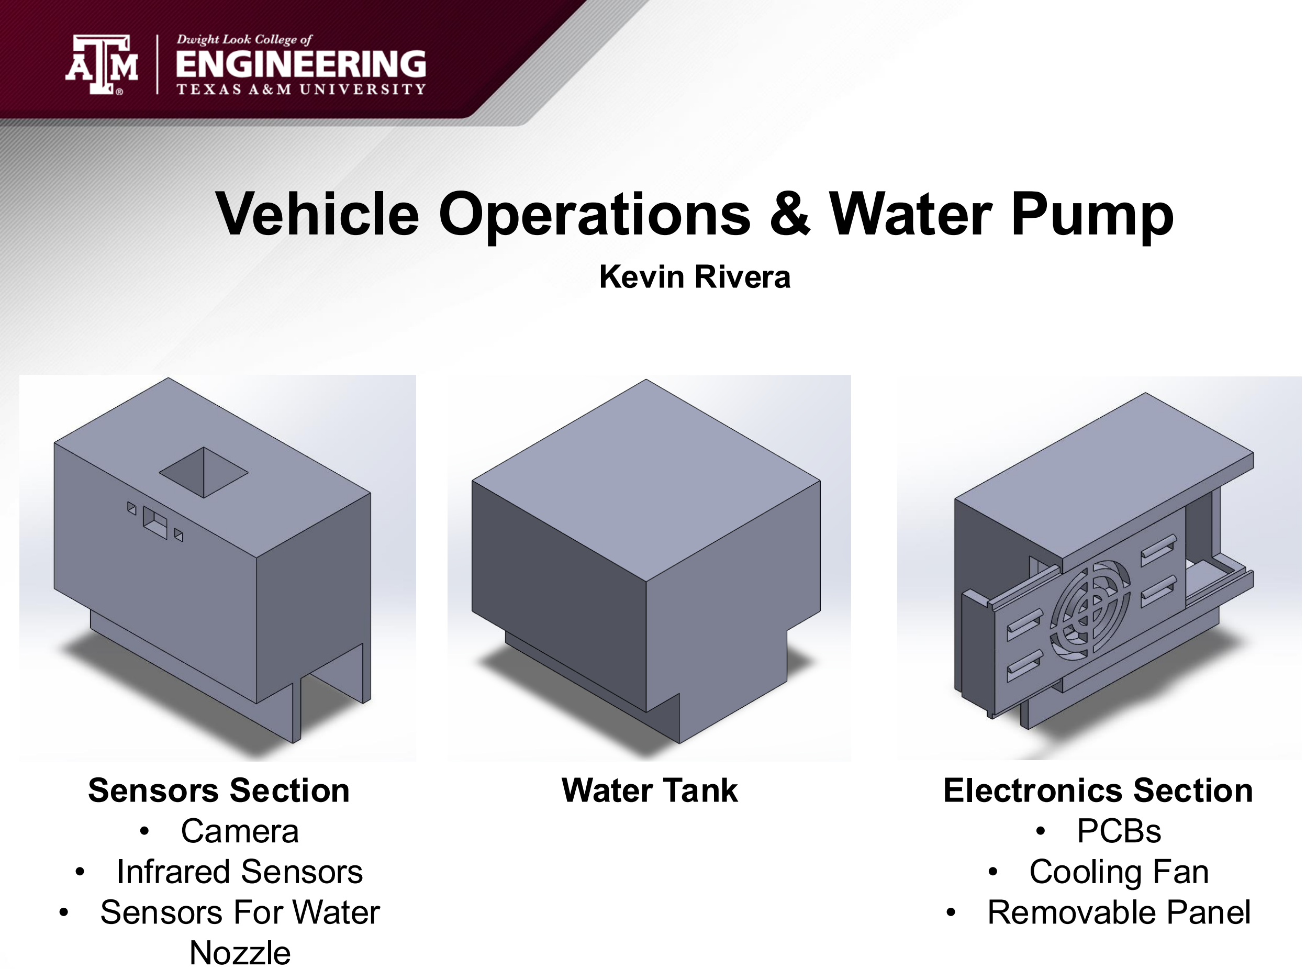
[picture p146: page 10]

Kevin Rivera

Electronics Section
- PCBs
- Cooling Fan
- Removable Panel
Sensors Section | Water Tank
- Camera
- Infrared Sensors
- Sensors For Water
Nozzle

# Power & Recharging

Nancy Ramirez Castillo

Accomplishments since last update 9 hrs of effort | Ongoing progress/problems and plans until the next presentation
- Ordered ESP32 PCB, Flame Detection PCB - 12V Buck Converter Running | - Minor fixes on the 5V Buck - Integrate with Vehicle Operations and Microcontroller to mount on frame

# Power & Recharging

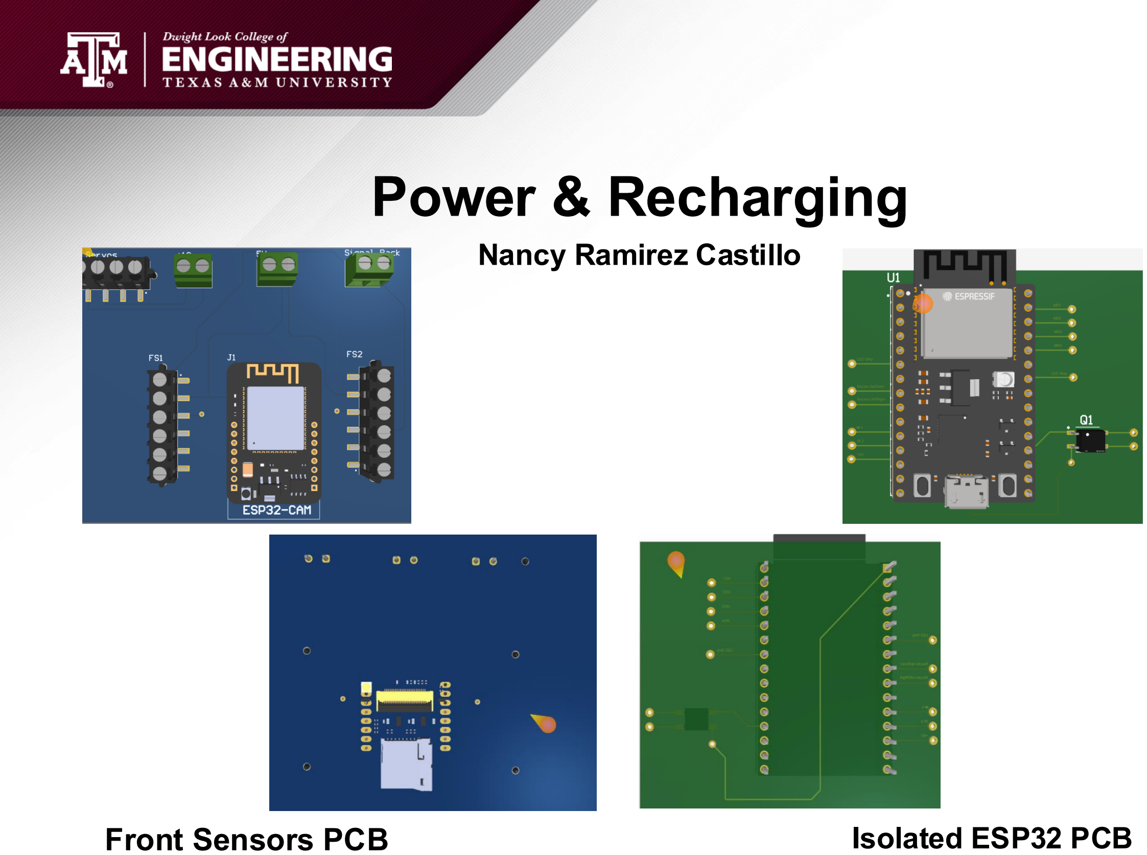
[picture p147: page 12]

Front Sensors PCB

Nancy Ramirez Castillo

Isolated ESP32 PCB

# Mobile App Subsystem

Yuwen Zheng

Accomplishments since last update 8 hrs of effort

Ongoing progress/problems and plans until the next presentation
- Completed real-time video streaming integration
with microcontroller subsystem
- Tested video streaming
functionality on mobile app by connecting to ESP32 and
displaying video streaming while camera is moving
- Create fixed size video display in Mobile App
- Add LED Button & Nozzle Button
- Test user control coordinates functionality with microcontroller and water pump subsystem

# App Interface

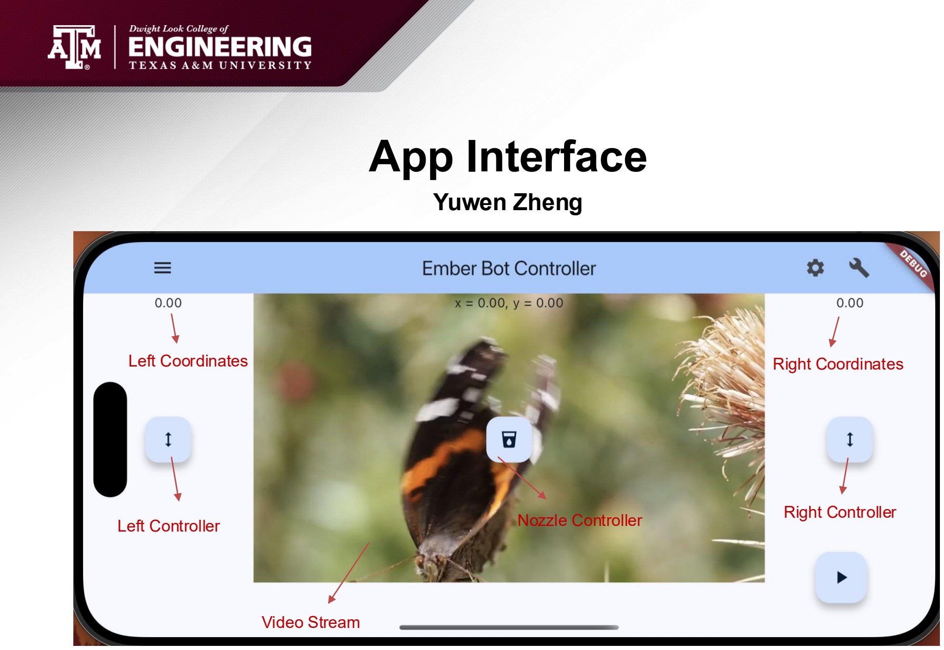
[picture p148: page 14]

Yuwen Zheng

Left Coordinates

Left Controller

Right Coordinates

Right Controller Nozzle Controller

Video Stream

## Mobile App Subsystem

## Yuwen Zheng

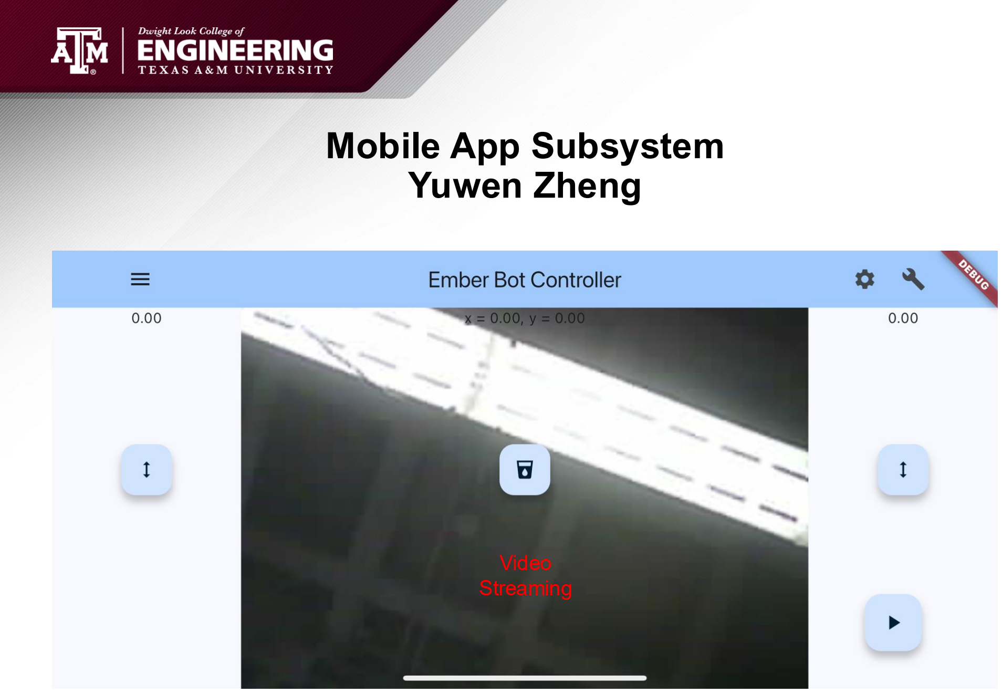
[picture p149: page 15]

Video
Streaming

# Execution Plan

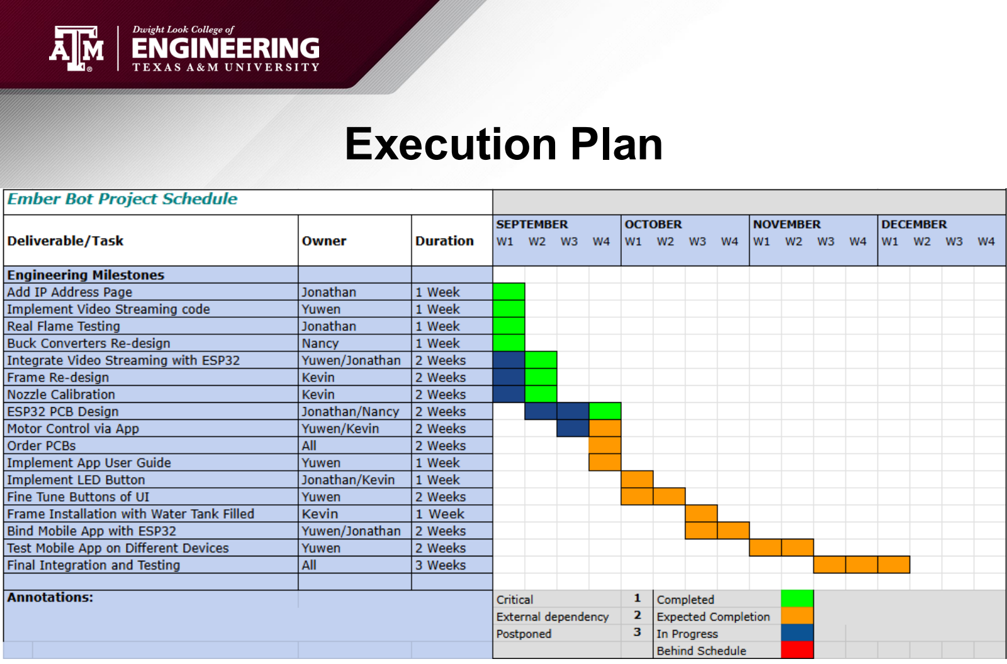
[picture p150: page 16]

# Validation Plan

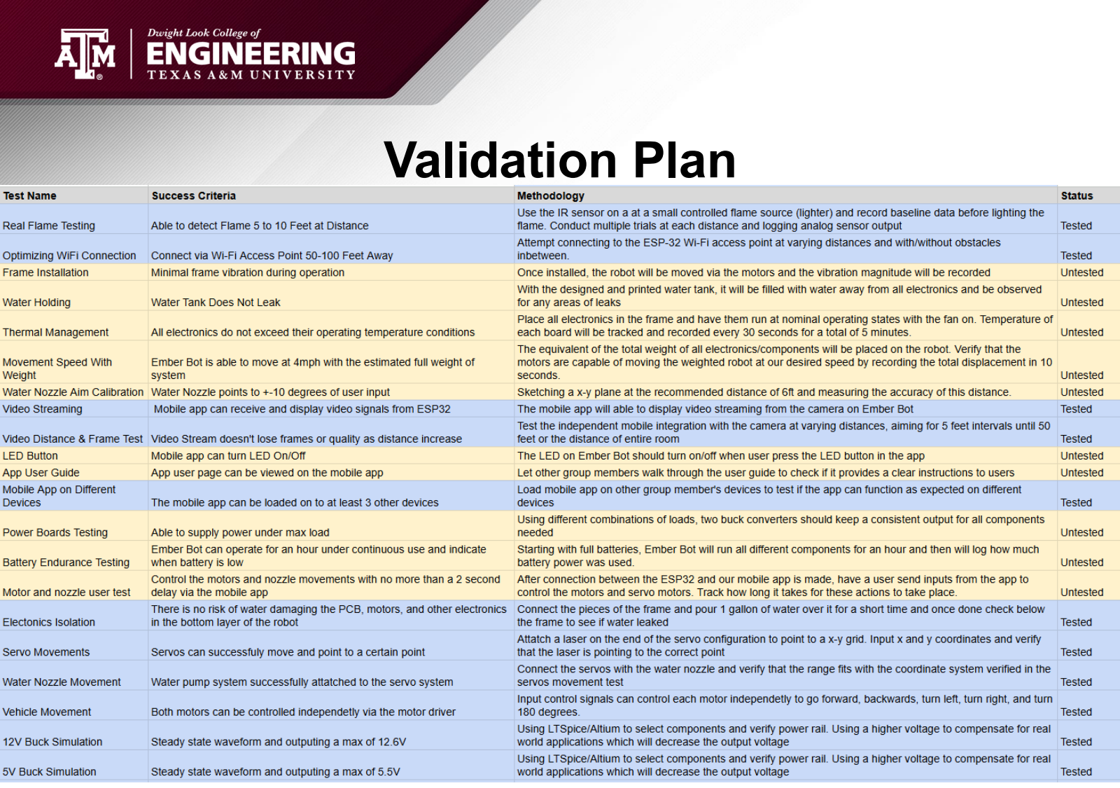
[picture p151: page 17]
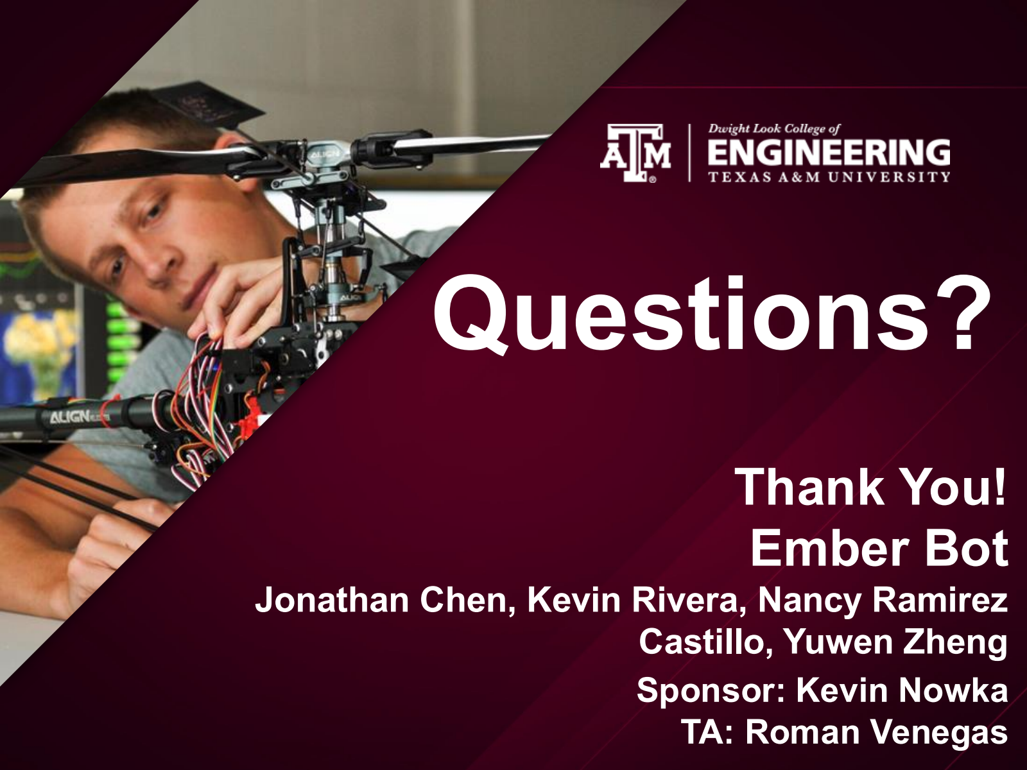
[picture p152: page 18]

# Thank You! Ember Bot

## Jonathan Chen, Kevin Rivera, Nancy Ramirez

## Castillo, Yuwen Zheng

## Sponsor: Kevin Nowka TA: Roman Venegas

# Questions?
