Yuwen2024/Fall-2025-Ember-Bot/Documentation/ECEN404 Status Update #3.pdf

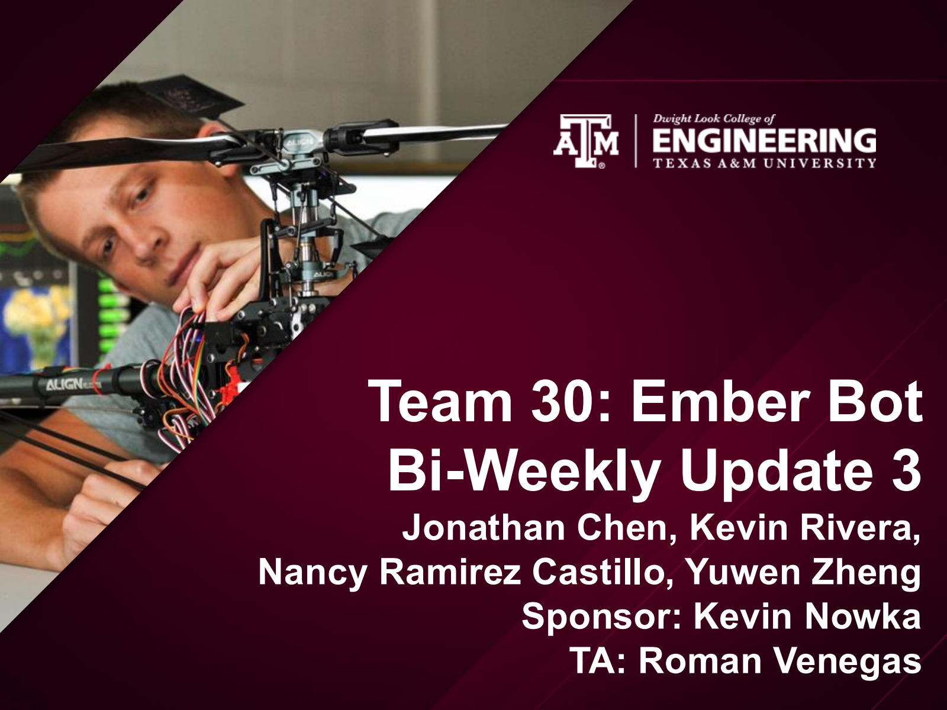
[picture p153: page 1]

# Team 30: Ember Bot Bi-Weekly Update 3

Jonathan Chen, Kevin Rivera,

## Nancy Ramirez Castillo, Yuwen Zheng Sponsor: Kevin Nowka TA: Roman Venegas

# Project Summary


# Problem Statement:

## Traditional firefighting methods

place firefighters in direct danger, exposing them to extreme heat,

## toxic smoke, and potential structural collapse, conditions that

significantly threaten their safety.

# Project Summary

## Solution Proposal:

## Ember Bot introduces a remotely operated robotic vehicle that allows firefighters to

combat fires from a safe distance.

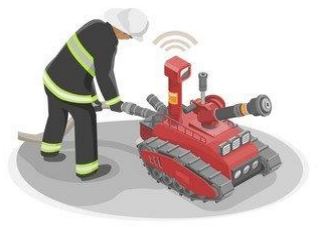
[picture p154: figure]

# System Overview

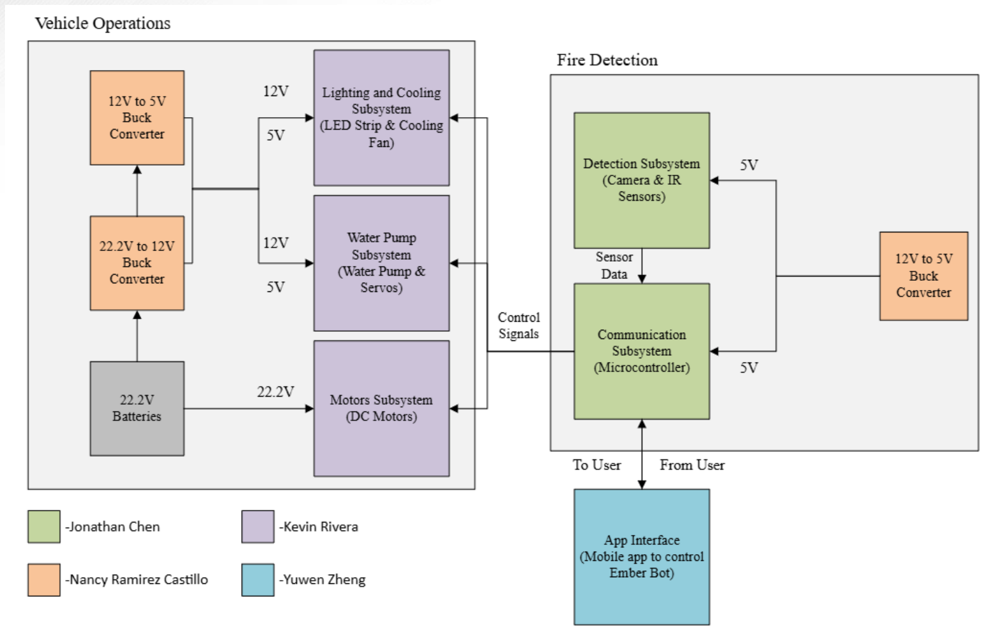
[picture p155: figure]

# Project Timeline

Subsystem
Designs and
Testing
(completed
9/11)

Integration of
motor
subsystem
and MCU
(completed
9/17)

Integration of
Wi-Fi and
iPhone App
(to complete
by 9/28)

Individual
Subsystem
Power Test
(to complete
by 10/15)

Frame
Placement
Integration
(to complete
by 11/2)

Integration
Validation
(to complete
by 11/26)

Demo and
Report
(to complete
by 12/5)

# Microcontroller Subsystem

Jonathan Chen

Accomplishments since last update 22 hrs of effort

Ongoing progress/problems and plans until the next presentation
- Implemented Separate Web Server to deliver Real-time Coordinate Values
- Configured multiple IP addresses for parallel data handling
- Starting Physical Testing calibration with Motors and Nozzle Systems
- Ongoing Integration with Power PCBs and Testing – Completed by Next Review
- Building HTML page to display values for users
- On-Going Implementation with Direct Camera Functionality
- Tested New Frame for Sensor – Validation Failed

# Microcontroller Subsystem

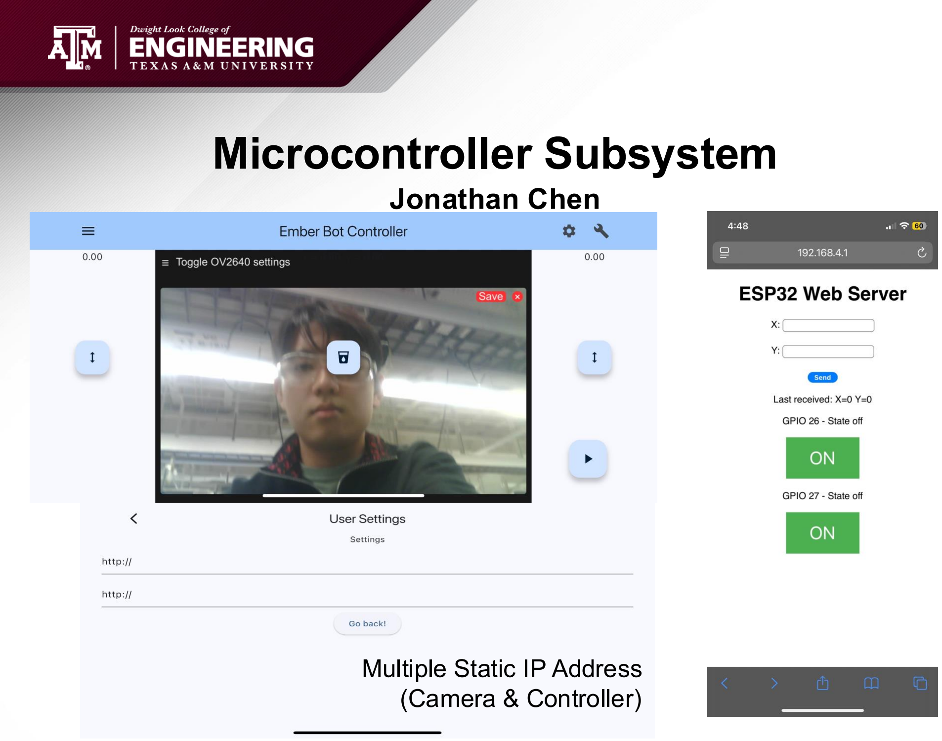
[picture p156: page 7]

Jonathan Chen

Multiple Static IP Address (Camera & Controller)

# Microcontroller Subsystem

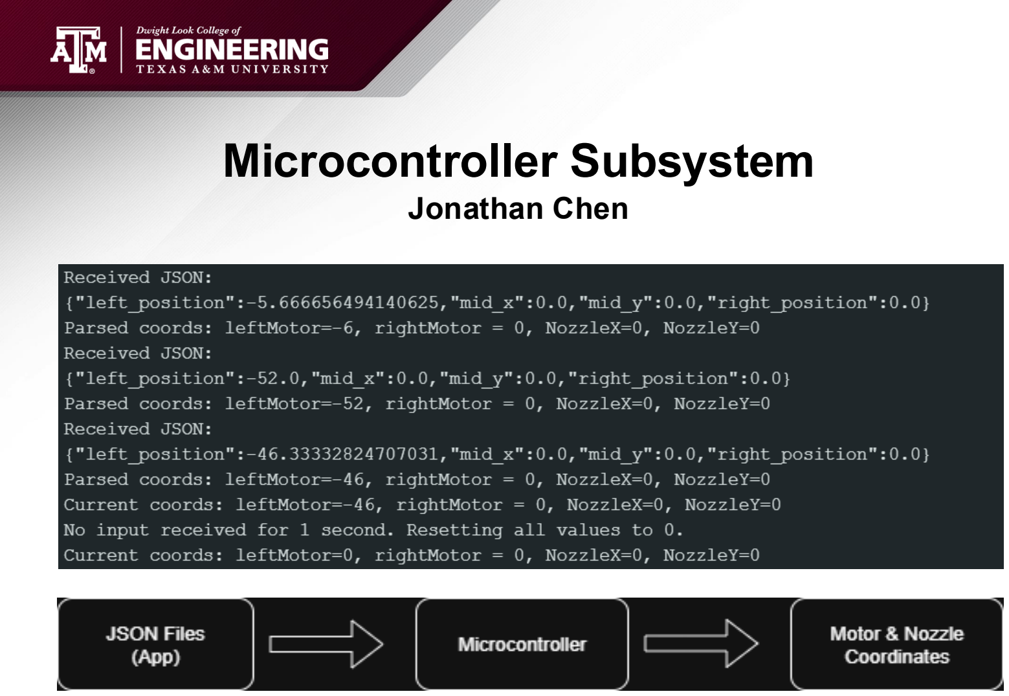
[picture p157: page 8]

Jonathan Chen

## Vehicle Operations & Water Pump Subsystem

Kevin Rivera

Accomplishments since last update 15 hrs of effort | Ongoing progress/problems and plans until the next presentation
- Prepared motors and water nozzle control for app integration | • Final adjustments to frame for housing PCBs/sensors • Integrate motors and water pump with PCB

## Vehicle Operations & Water Pump Subsystem

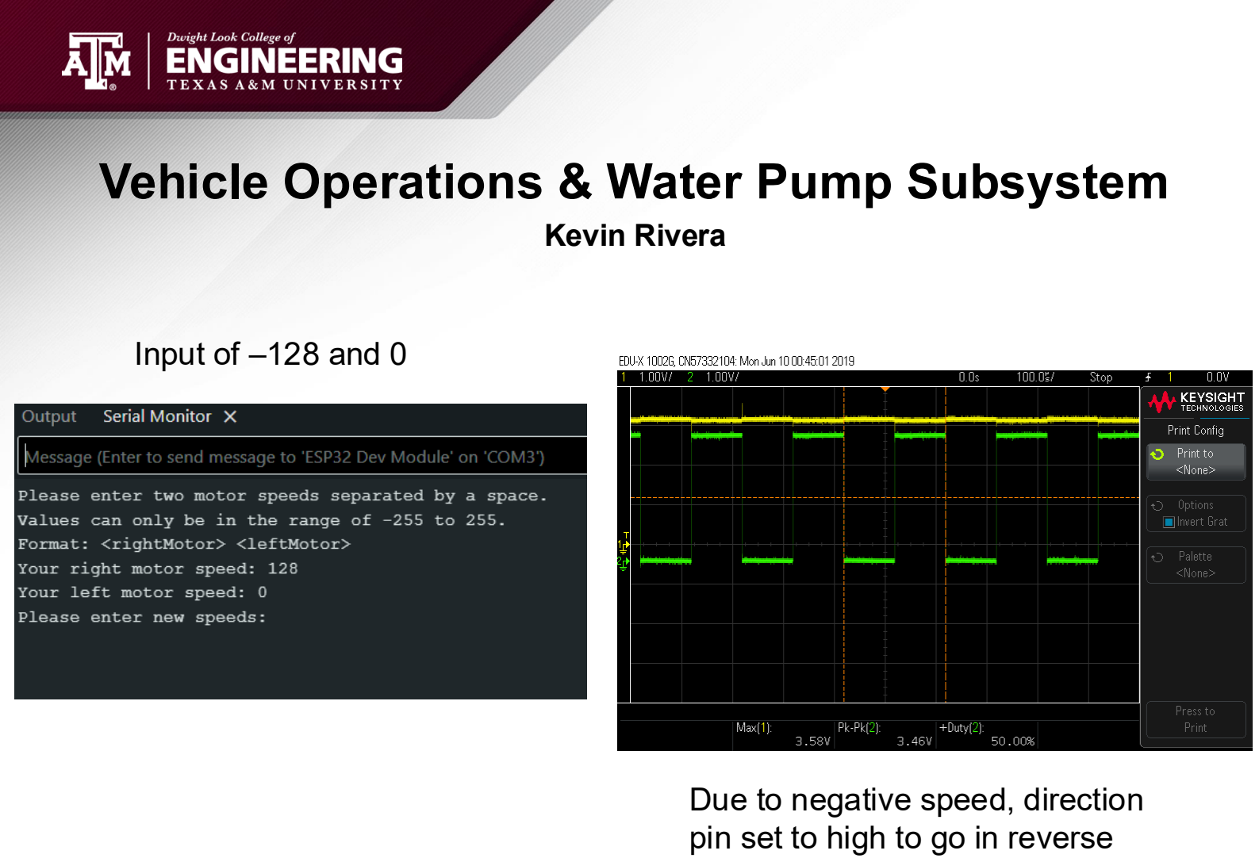
[picture p158: page 10]

Kevin Rivera

Input of –128 and 0

Due to negative speed, direction pin set to high to go in reverse

# Power & Recharging

Nancy Ramirez Castillo

Accomplishments since last update 9 hrs of effort

Ongoing progress/problems and plans until the next presentation
- Ordered new 5V Buck Converter PCB, will be delivered EOW
- 5V Buck: Solder, E-Load test, and mounted onto frame
- Perf board mounted for camera, servo motors, and LED light
- Battery Percentage
Implementation
- Failed to do E-Load test on 12V Buck Converter

# Power & Recharging

Nancy Ramirez Castillo

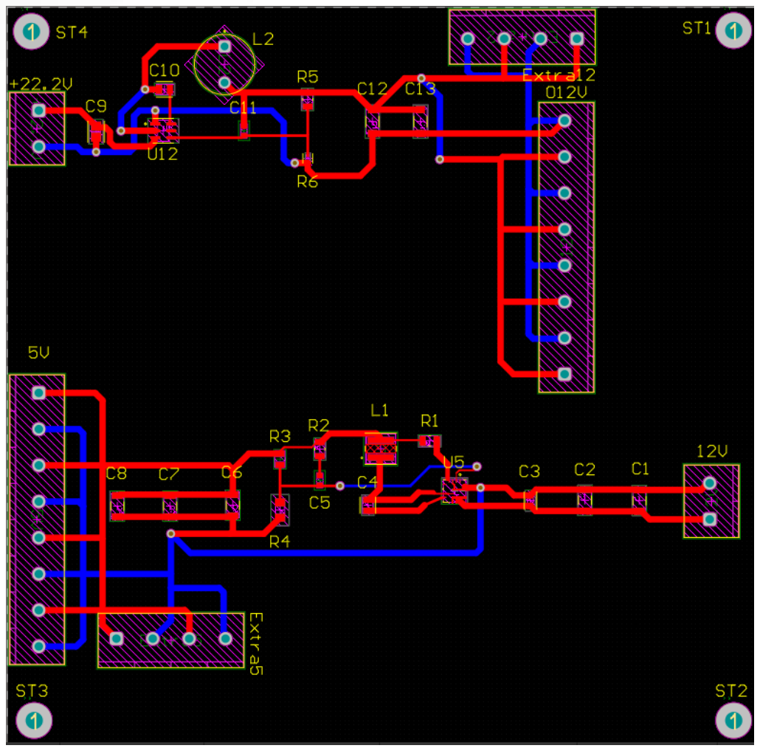
[picture p159: figure]

# Mobile App Subsystem

Yuwen Zheng

Accomplishments since last update 14 hrs of effort

Ongoing progress/problems and plans until the next presentation
- Changed IP address from
hardcoded to two user input entries for testing purposes
- Tested user coordinates
integration with microcontroller subsystem
- Video Display size in Mobile App is fixed
- Added LED Button & Nozzle Button
- Test the communication of all buttons between the mobile app and ESP32 in the server
- Use oscilloscope to test pin voltages of the ESP32 when the Mobile App is sending different signals
- Test the coordinates and video streaming functionality
simultaneously with ESP32

# App Interface(Before)

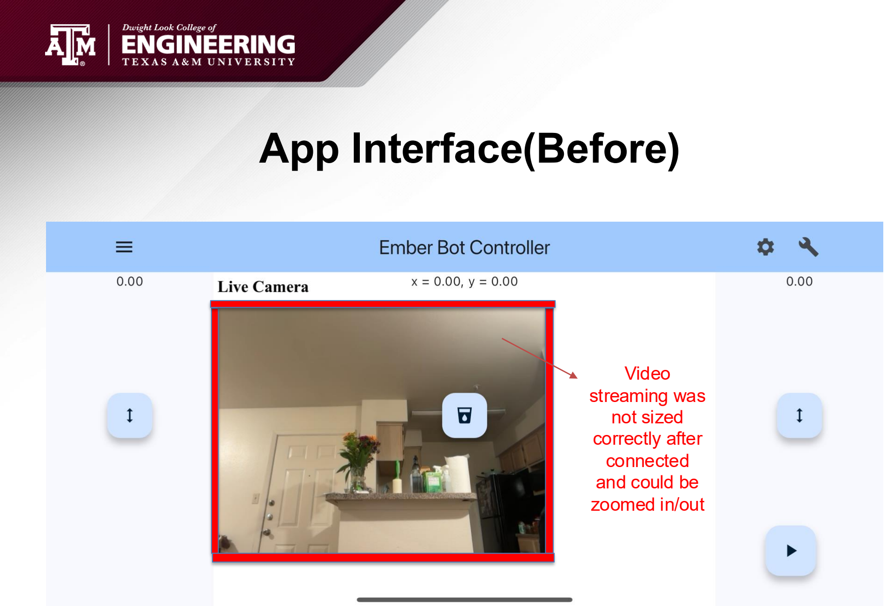
[picture p160: page 14]

Video
streaming was
not sized
correctly after
connected
and could be
zoomed in/out

# App Interface(After)

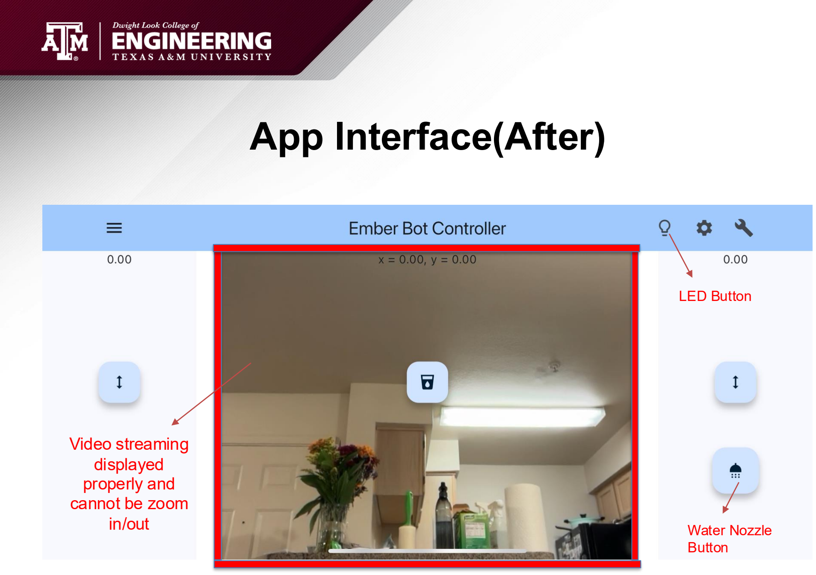
[picture p161: page 15]

LED Button

Water Nozzle
Button

Video streaming
displayed
properly and
cannot be zoom
in/out

# IP Address Entries

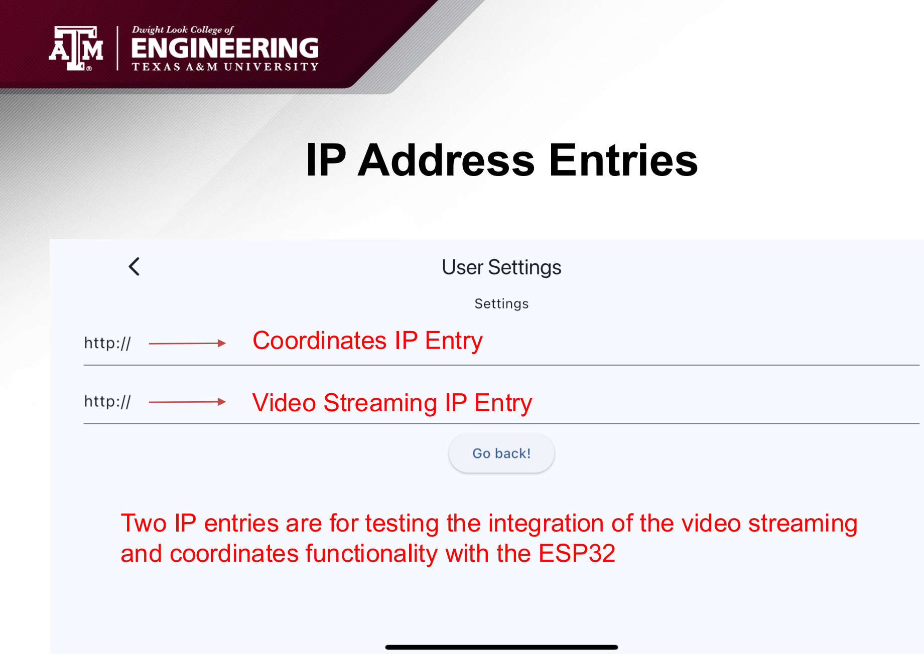
[picture p162: page 16]

Two IP entries are for testing the integration of the video streaming and coordinates functionality with the ESP32

Video Streaming IP Entry

Coordinates IP Entry

# Execution Plan

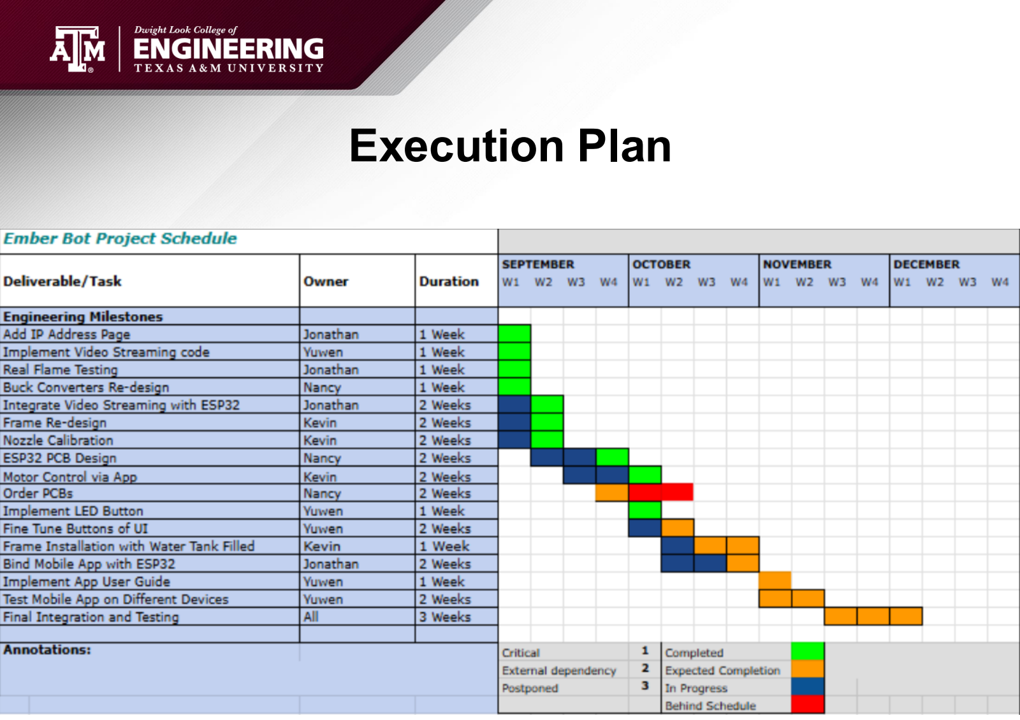
[picture p163: page 17]

# Validation Plan

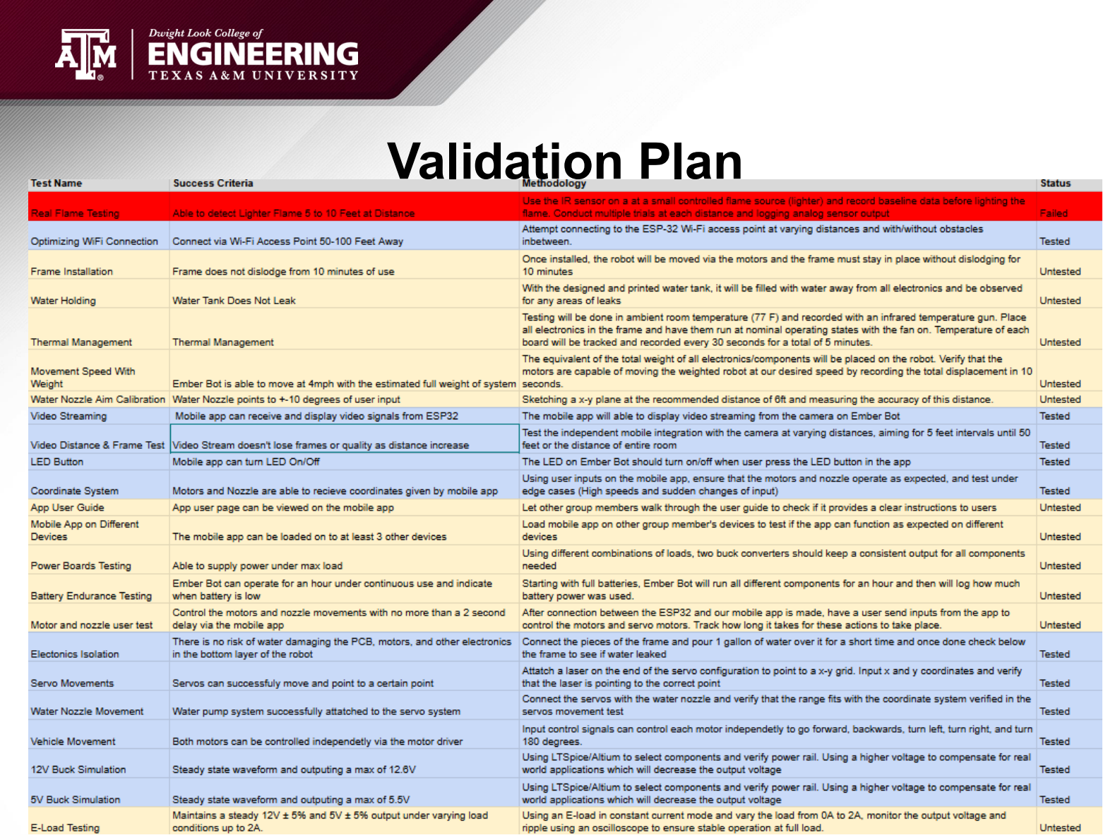
[picture p164: page 18]

# Thank You! Ember Bot

## Jonathan Chen, Kevin Rivera, Nancy Ramirez

## Castillo, Yuwen Zheng

## Sponsor: Kevin Nowka TA: Roman Venegas

# Questions?
