Yuwen2024/Fall-2025-Ember-Bot/Documentation/ECEN404 Status Update #4.pdf

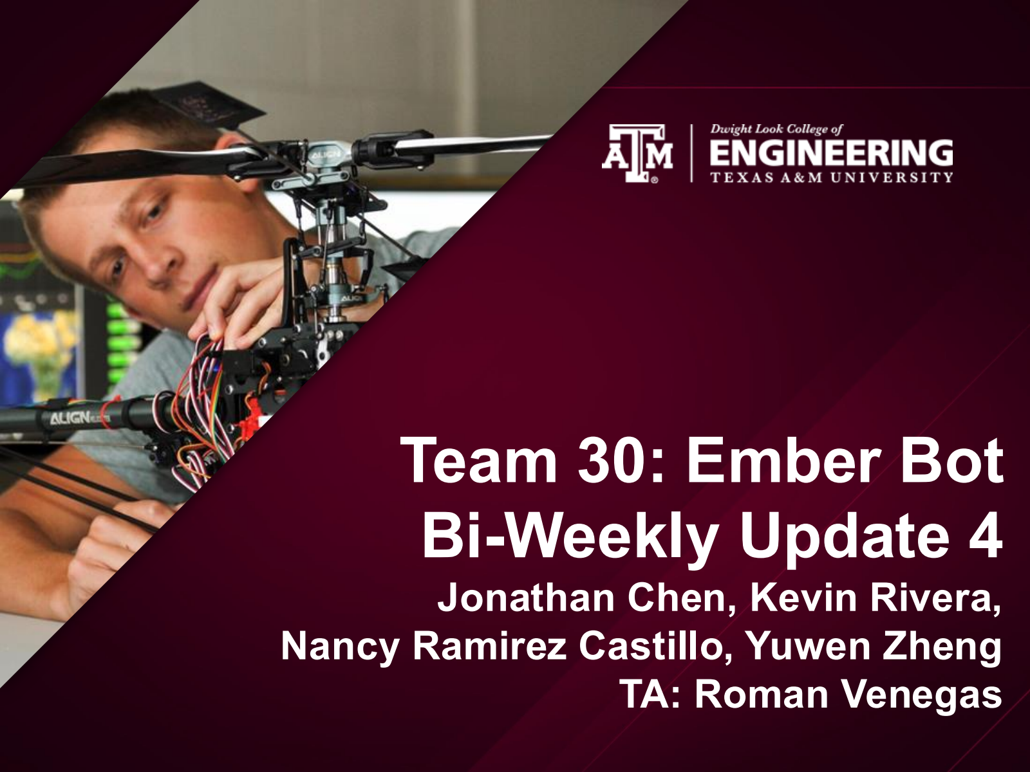
[picture p165: page 1]

# Team 30: Ember Bot Bi-Weekly Update 4

Jonathan Chen, Kevin Rivera,

## Nancy Ramirez Castillo, Yuwen Zheng TA: Roman Venegas

# Project Summary

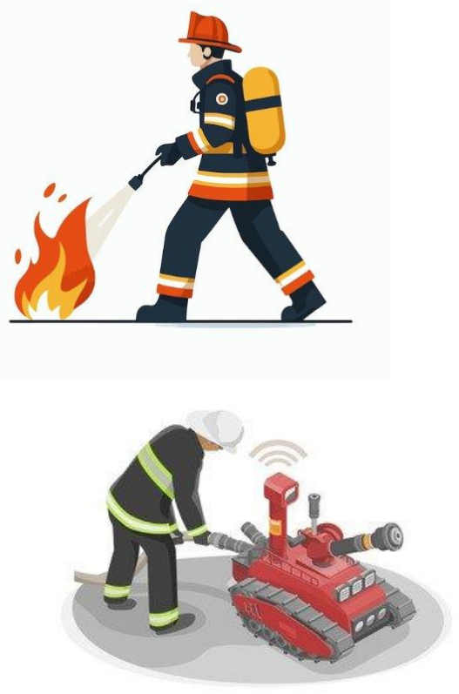
[picture p166: figure]

## Problem Statement:

Traditional firefighting methods place firefighters in direct danger, exposing them to conditions that significantly threaten their safety and livelihood.

## Solution Proposal:

Ember Bot introduces a remotely operated robotic vehicle that allows firefighters to combat fires from a safe distance.

# Integrated System Diagram

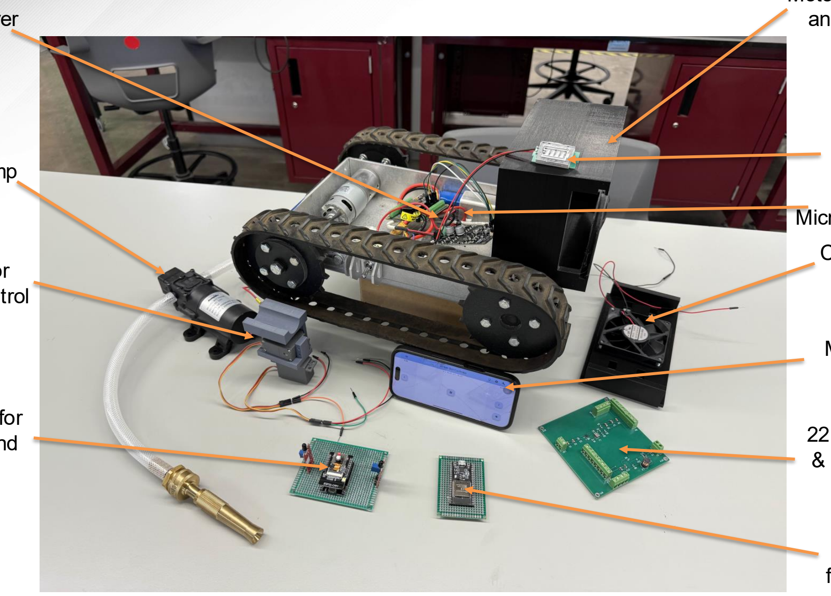
[picture p167: figure]

Motor Driver

Water Pump

Servos for
Nozzle Control

Perfboard for
sensors and
camera

Perfboard
for ESP32

22.2V to 12V
& 12V to 5V
PCB

Mobile App

Cooling Fan

Battery
Tracker

Frame for
Motor Control
and PCB

ESP32
Microcontroller

# Project Timeline

Subsystem
Designs and
Testing
(completed
9/11)

Integration of
motor
subsystem
and MCU
(completed
9/17)

Integration of
Wi-Fi and
iPhone App
(to complete
by 9/28)

Individual
Subsystem
Power Test
(to complete
by 10/15)

Frame
Placement
Integration
(to complete
by 11/2)

Full
Integration
Validation
(to complete
by 11/26)

Demo and
Report
(to complete
by 12/5)

## System Integration led by Jonathan Chen (Microcontroller)

Accomplishments since last update
18 hrs of effort

Ongoing progress/problems and plans until the next presentation
- Verified communication between mobile app commands and motor response are correctly
synchronized.
- Validated error handling for communication dropouts and motor command conflicts during extended runtime
- On-going adjusting real-time nozzle system alongside video stream feedback for coordinated point and shoot.
- Conducting extended range and latency tests for various
microcontroller communication protocols under varying signal conditions.
- Preparing full-field validation of system range, control precision, and streaming reliability with designated PCB.

## Microcontroller System Integration Jonathan Chen

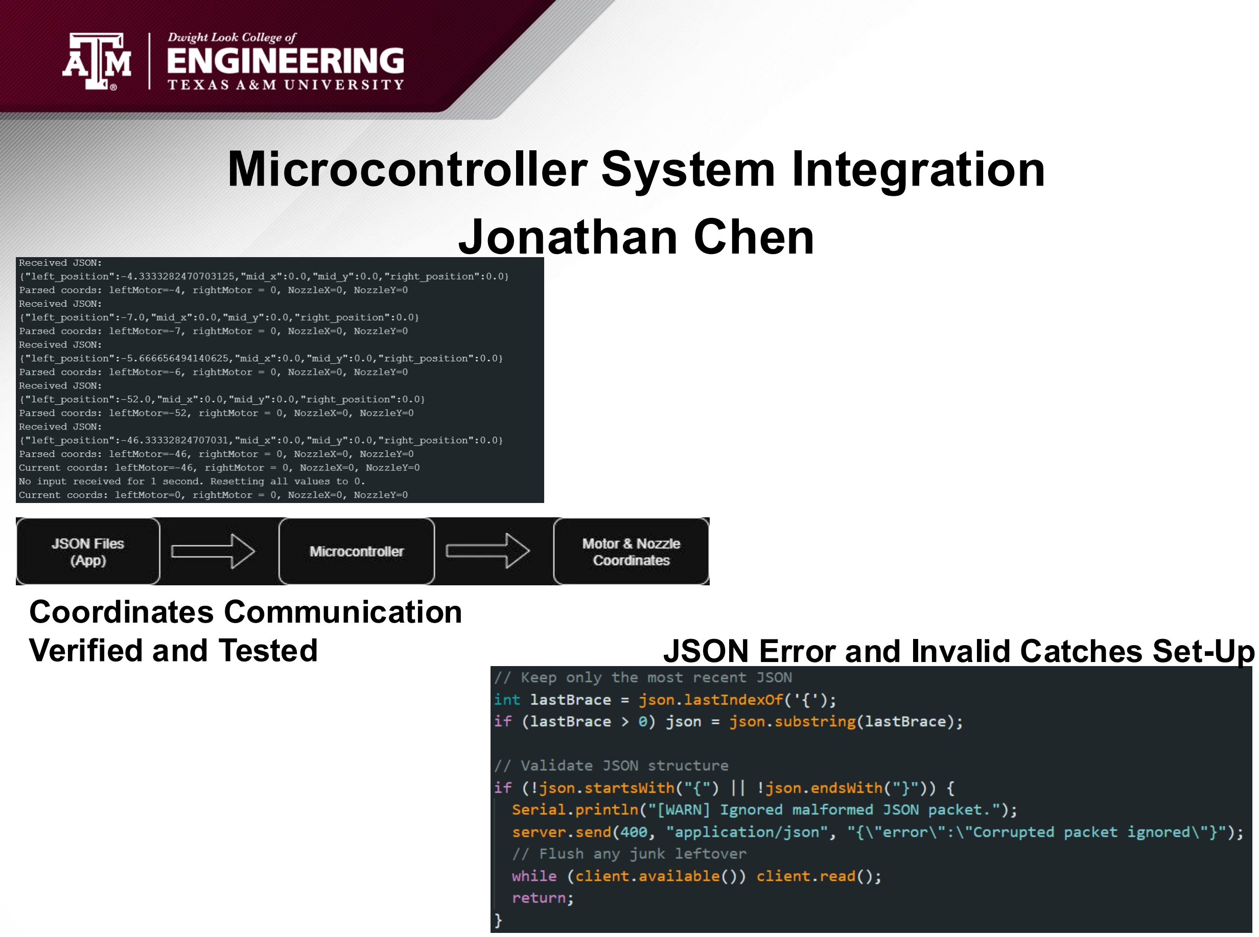
[picture p168: page 6]

Coordinates Communication
Verified and Tested | JSON Error and Invalid Catches Set-Up

## Microcontroller System Integration

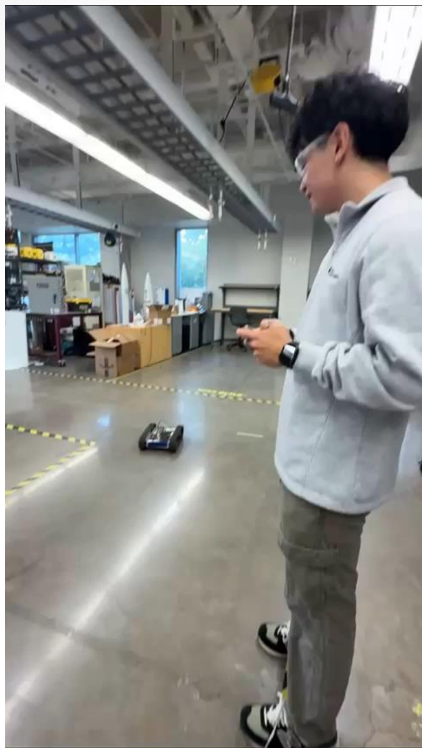
[picture p169: figure]
Jonathan Chen

## System Integration led by Kevin Rivera (Vehicle Operations & Water Pump)

Accomplishments since last update
21 hrs of effort

Ongoing progress/problems and plans until the next presentation
- Validated PWM speed control and direction signal code for DC motors through ESP32 and
mobile app
- Tested top speed, turn radius, and terrain capabilities through mobile app control
- Place new water tank on robot
- Mounting electronics into frames such as motor drive, PCBs, sensors, and camera.
- Ongoing adjustments to servo and camera integration

# User Maneuverability

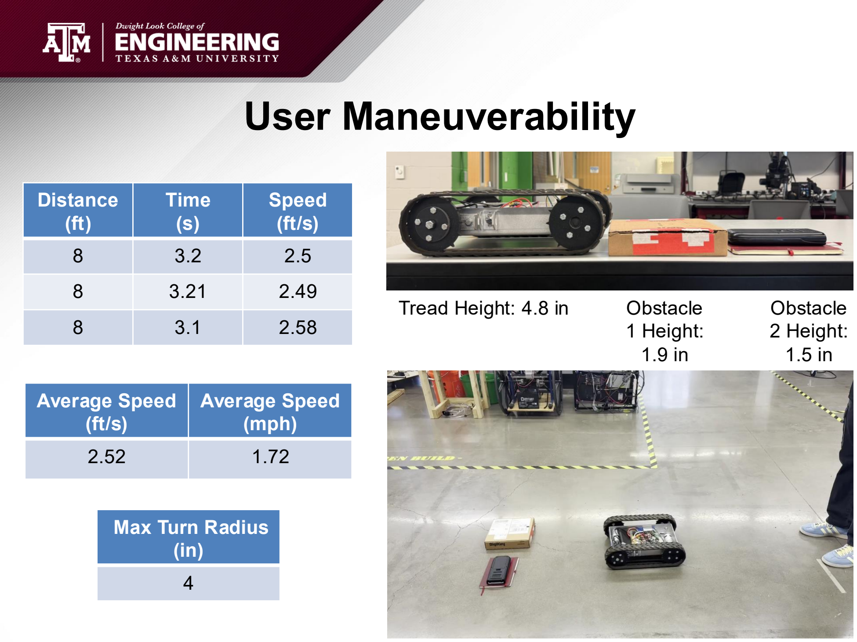
[picture p170: page 9]

Tread Height: 4.8 in | Obstacle 1 Height: 1.9 in

Obstacle
2 Height:
1.5 in
Distance (ft) | Time (s) | Speed (ft/s)
8 | 3.2 | 2.5
8 | 3.21 | 2.49
8 | 3.1 | 2.58
Average Speed (ft/s) | Average Speed (mph)
2.52 | 1.72

Max Turn Radius
(in)

4

## System Integration led by Nancy Ramirez Castillo (Power)

Accomplishments since last update 22 hrs of effort | Ongoing progress/problems and plans until the next presentation
- Successful 5V Buck E-load Test • First Integration Load Test with 5V Rail – Failed | • Ongoing12V Rail circuit debugging • Ongoing 5V Rail circuit debugging

# Power E-Load Test

Current (A) | Voltage (V)

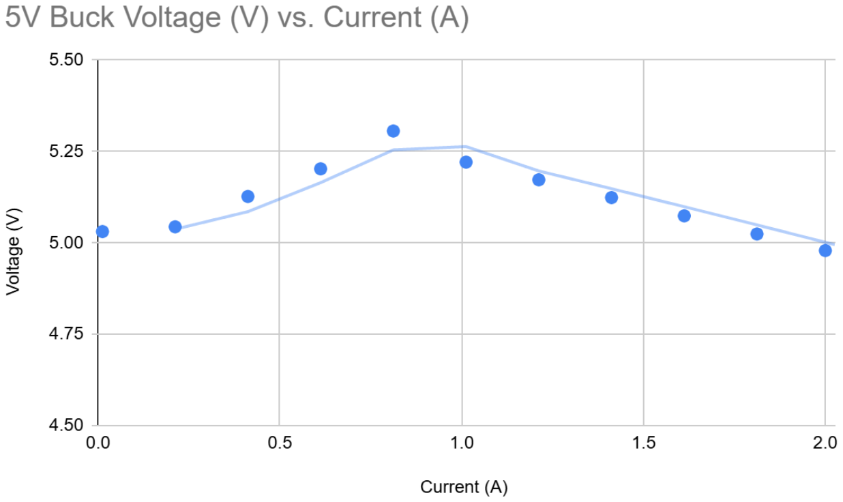
[picture p171: figure]

0.0121 | 5.0309
0.212 | 5.0439
0.412 | 5.1269
0.612 | 5.2026
0.812 | 5.3061
1.012 | 5.2209
1.212 | 5.1726
1.412 | 5.1239
1.612 | 5.0739
1.812 | 5.0243
2 | 4.9789

# Power Debugging

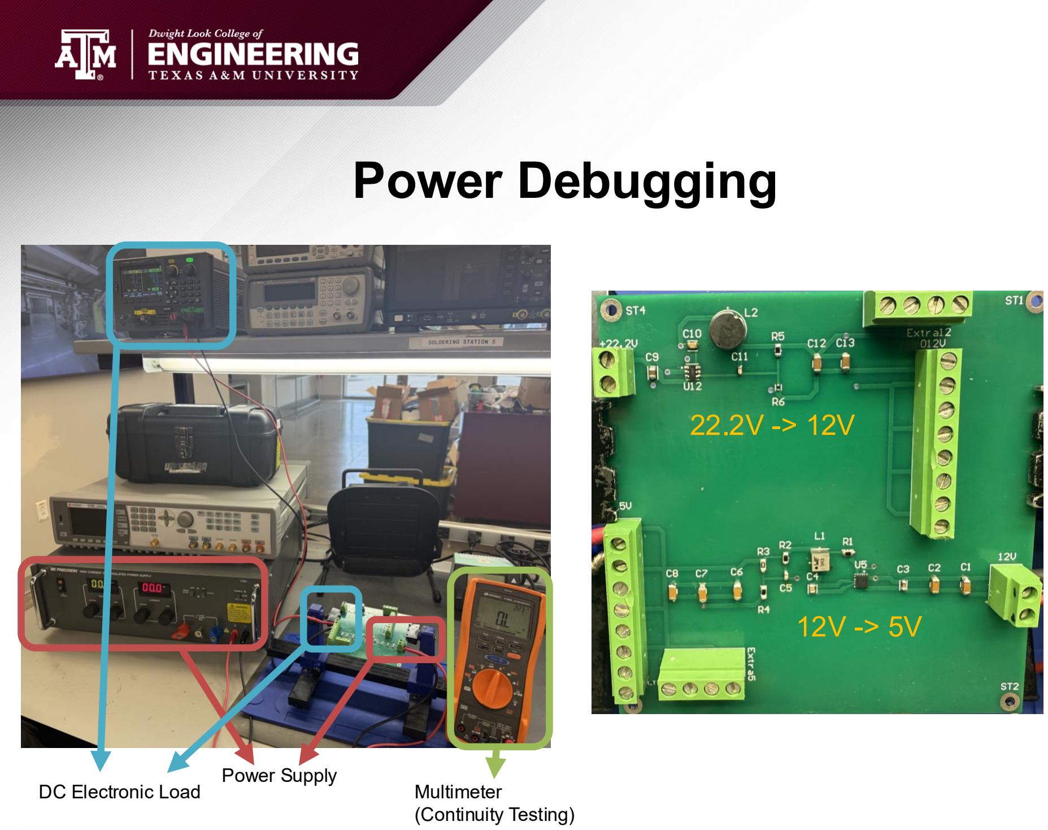
[picture p172: page 12]

Power Supply
DC Electronic Load | Multimeter (Continuity Testing)

22.2V -> 12V

12V -> 5V

# Power Debugging

22.2V to 12V Converter

Measurements | Voltage (V)
Input | 22.9
Output | 4.1
Pin 2 - SW | 12.9
Pin 3 – Vin | 22.9
Pin 4 - Feedback | 4.0
Pin 5 - Enable | 4.8
Pin 6 - Boot | 15.3
L_in | 12.9

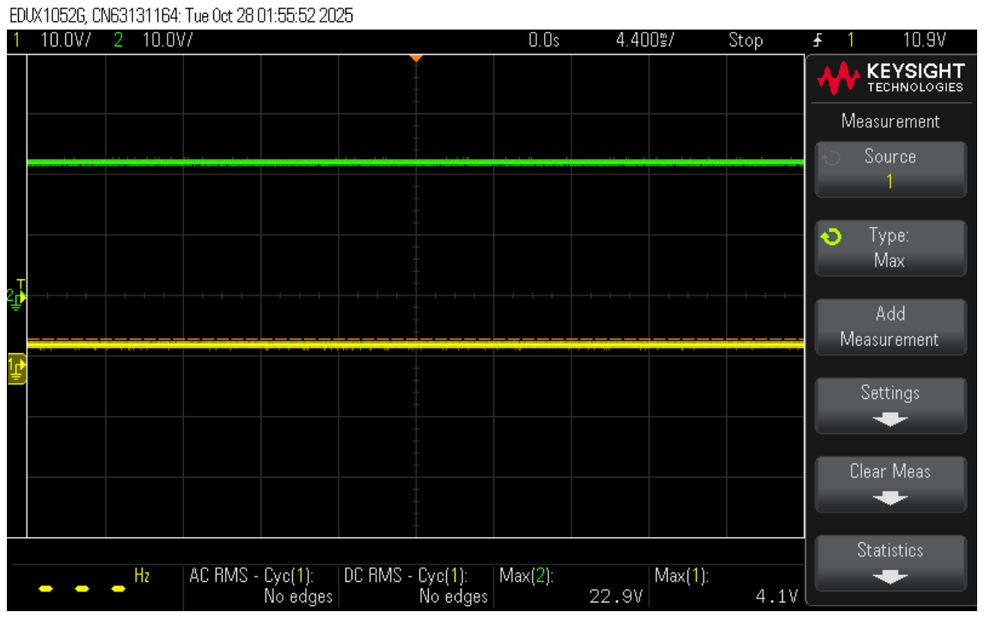
[picture p173: figure]

L_out | 5.6 | Green – Source Input Yellow – Converter Output

## Mobile App Integration Yuwen Zheng

Accomplishments since last update 10 hrs of effort

Ongoing progress/problems and plans until the next presentation
- During testing, when we flick a button too fast, motor may crack due to race condition of control signals received by
microcontroller
- The race condition is due to random network delay that may cause control signals not arriving in the order they were sent by the app
- Issue fixed by tagging control signals using a monotonically increasing counter, then the server can filter out control signals that arrive out of order
- Testing all functionalities of the app to determine other issues that may affect behavior
- Testing the app on different devices(Both android and
iPhone)
- Testing the accuracy of mobile app control over nozzle and LED

# App Control Over Motor Drive

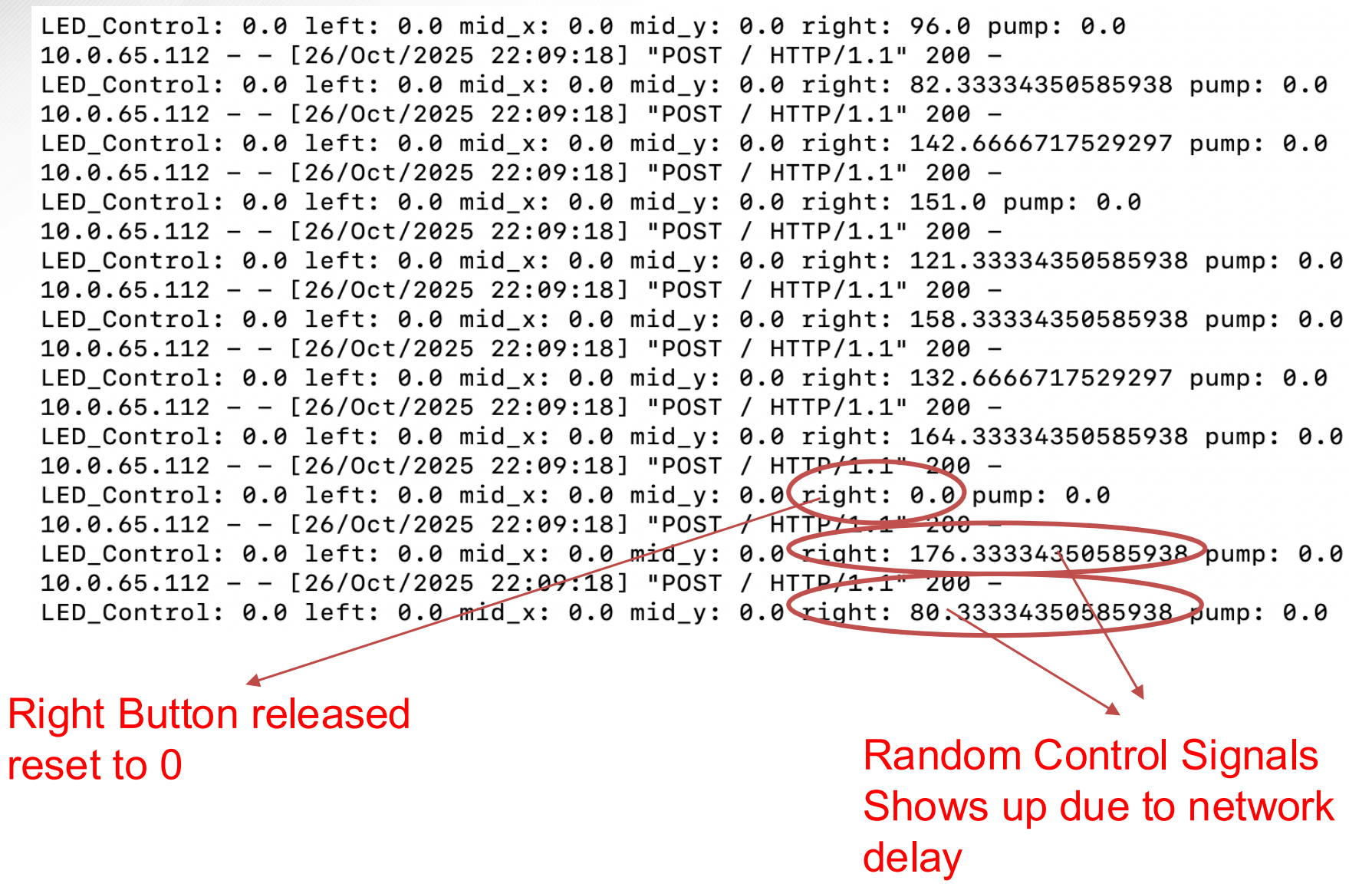
[picture p174: figure]
Random Control Signals Shows up due to network delay; Right Button released reset to 0

# App Control Over Motor Drive

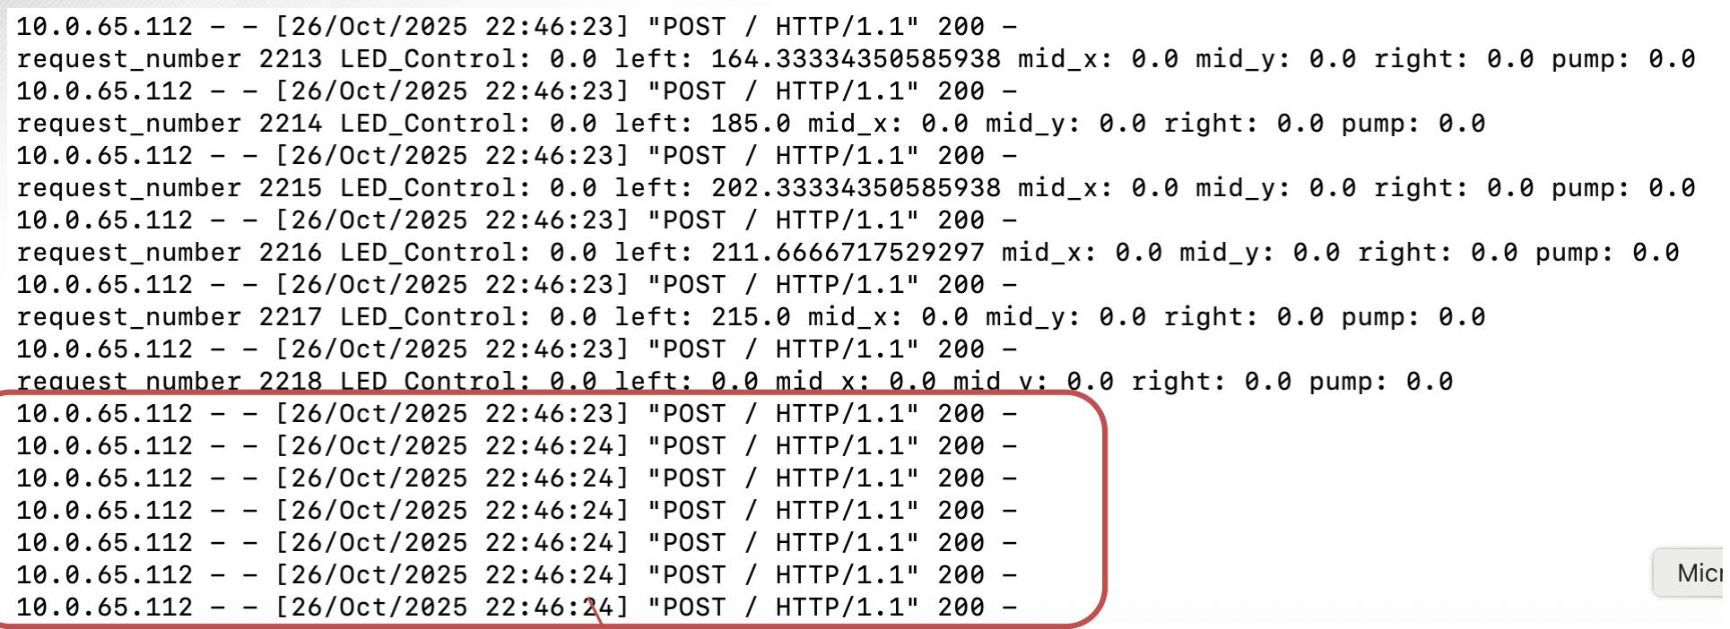
[picture p175: figure]

No extra signals generated
Out-of-order Signals are received but ignored

# Execution Plan

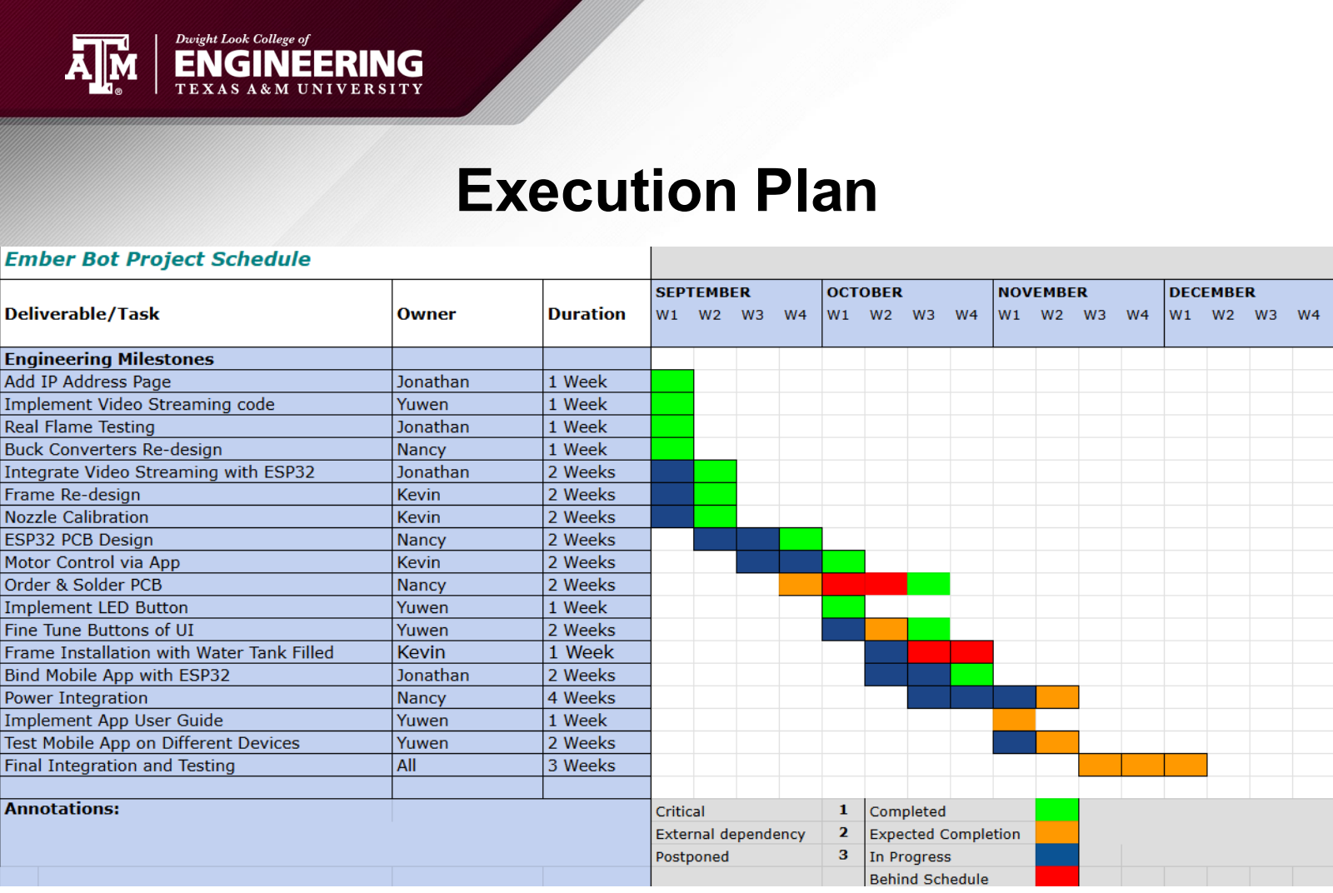
[picture p176: page 17]

# Validation Plan

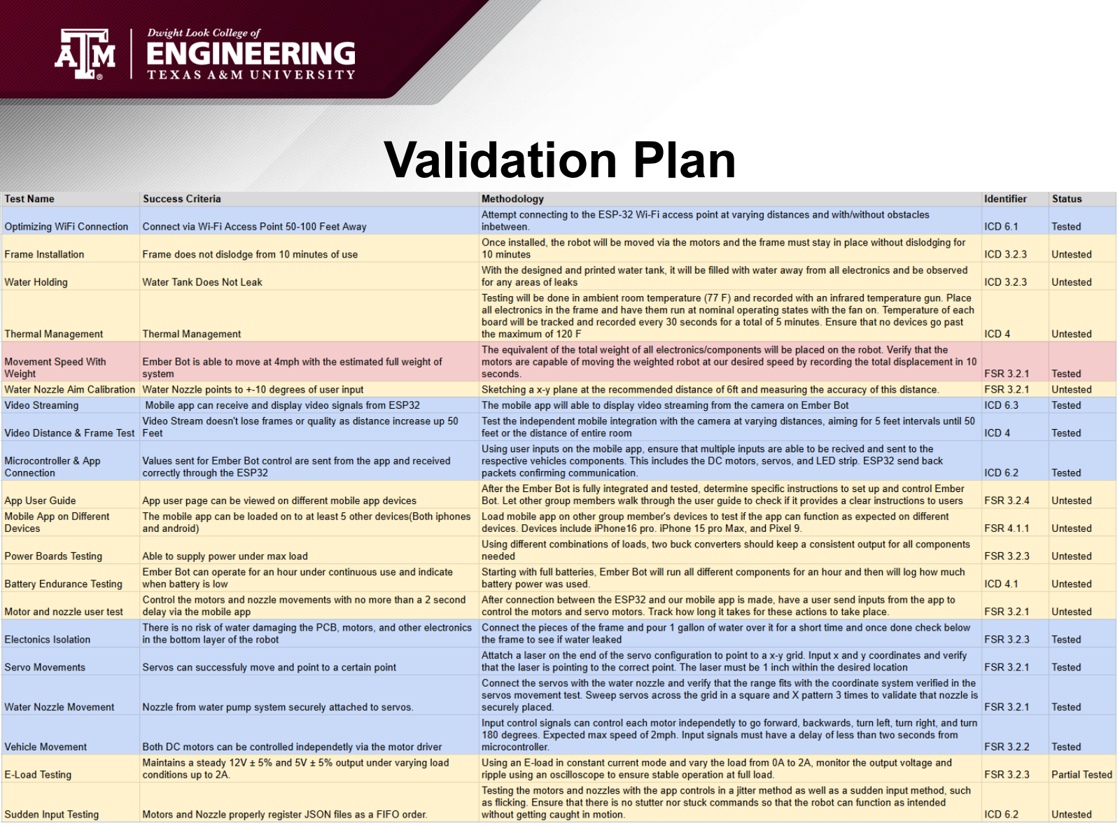
[picture p177: page 18]
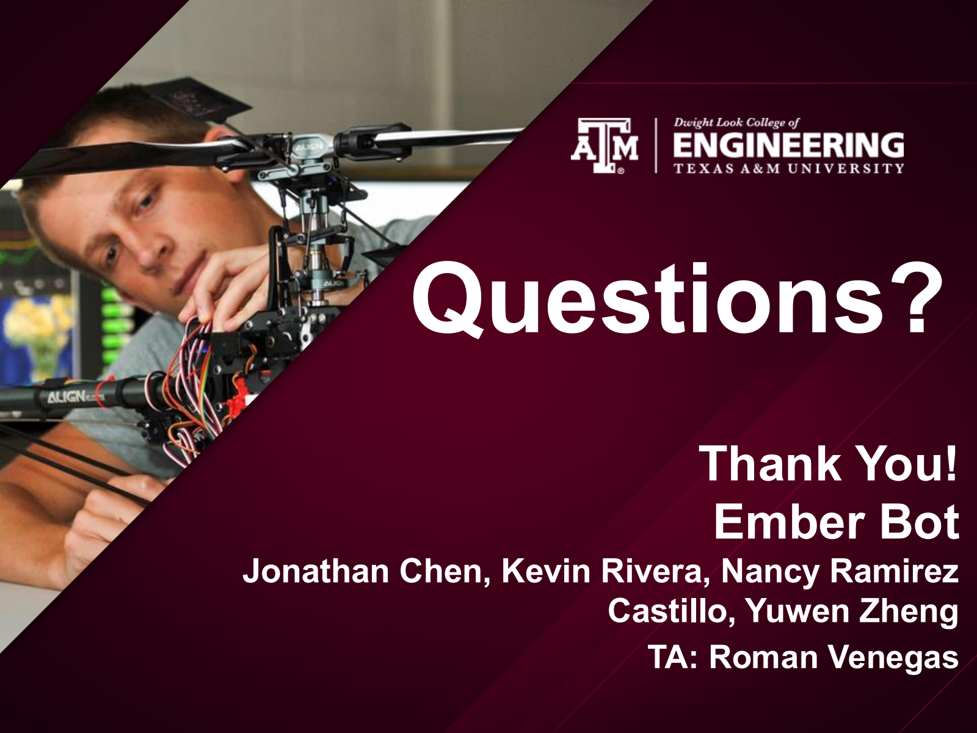
[picture p178: page 19]

# Thank You! Ember Bot

## Jonathan Chen, Kevin Rivera, Nancy Ramirez

## Castillo, Yuwen Zheng

## TA: Roman Venegas

# Questions?
