Yuwen2024/Fall-2025-Ember-Bot/Data/Mobile App Accuracy when sending signals.pdf

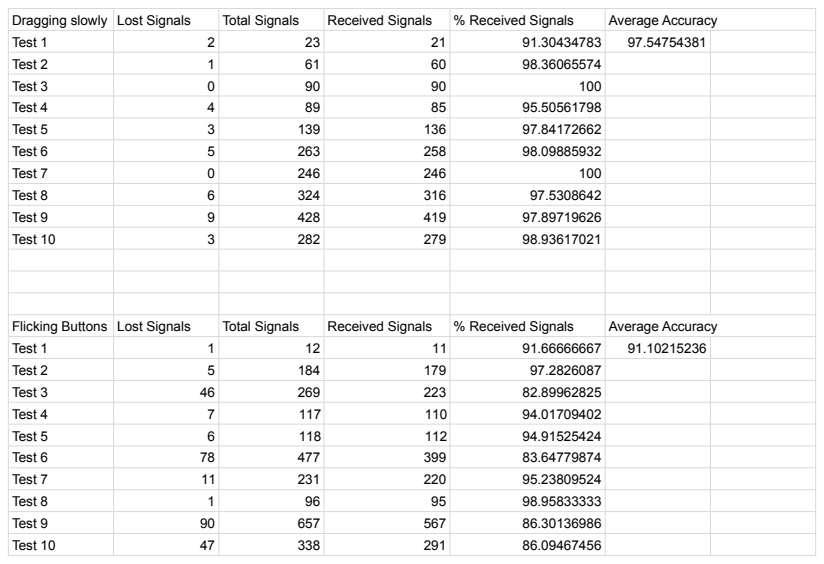
[picture p179: page 1]
Dragging slowly Lost Signals; Total Signals; Received Signals; % Received Signals; Average Accuracy; Test 1; Test 2; Test 3; Test 4; Test 5; Test 6; Test 7; Test 8; Test 9; Test 10; Flicking Buttons Lost Signals
