Yuwen2024/Fall-2025-Ember-Bot/(commit log)

2025-12-04 deleted camera code (will readd later)
2025-12-04 Readded Camera Code
    [partitions.csv]
2025-12-05 Added Response Time - JC
    [JSONResponseTime.xlsx]
